chaudhary-nikhil/E22_Senior_Design/hardware/GoldenForm_1.kicad_pcb

## KiCad design hardware/GoldenForm_1.kicad_pcb (2026-03-06)

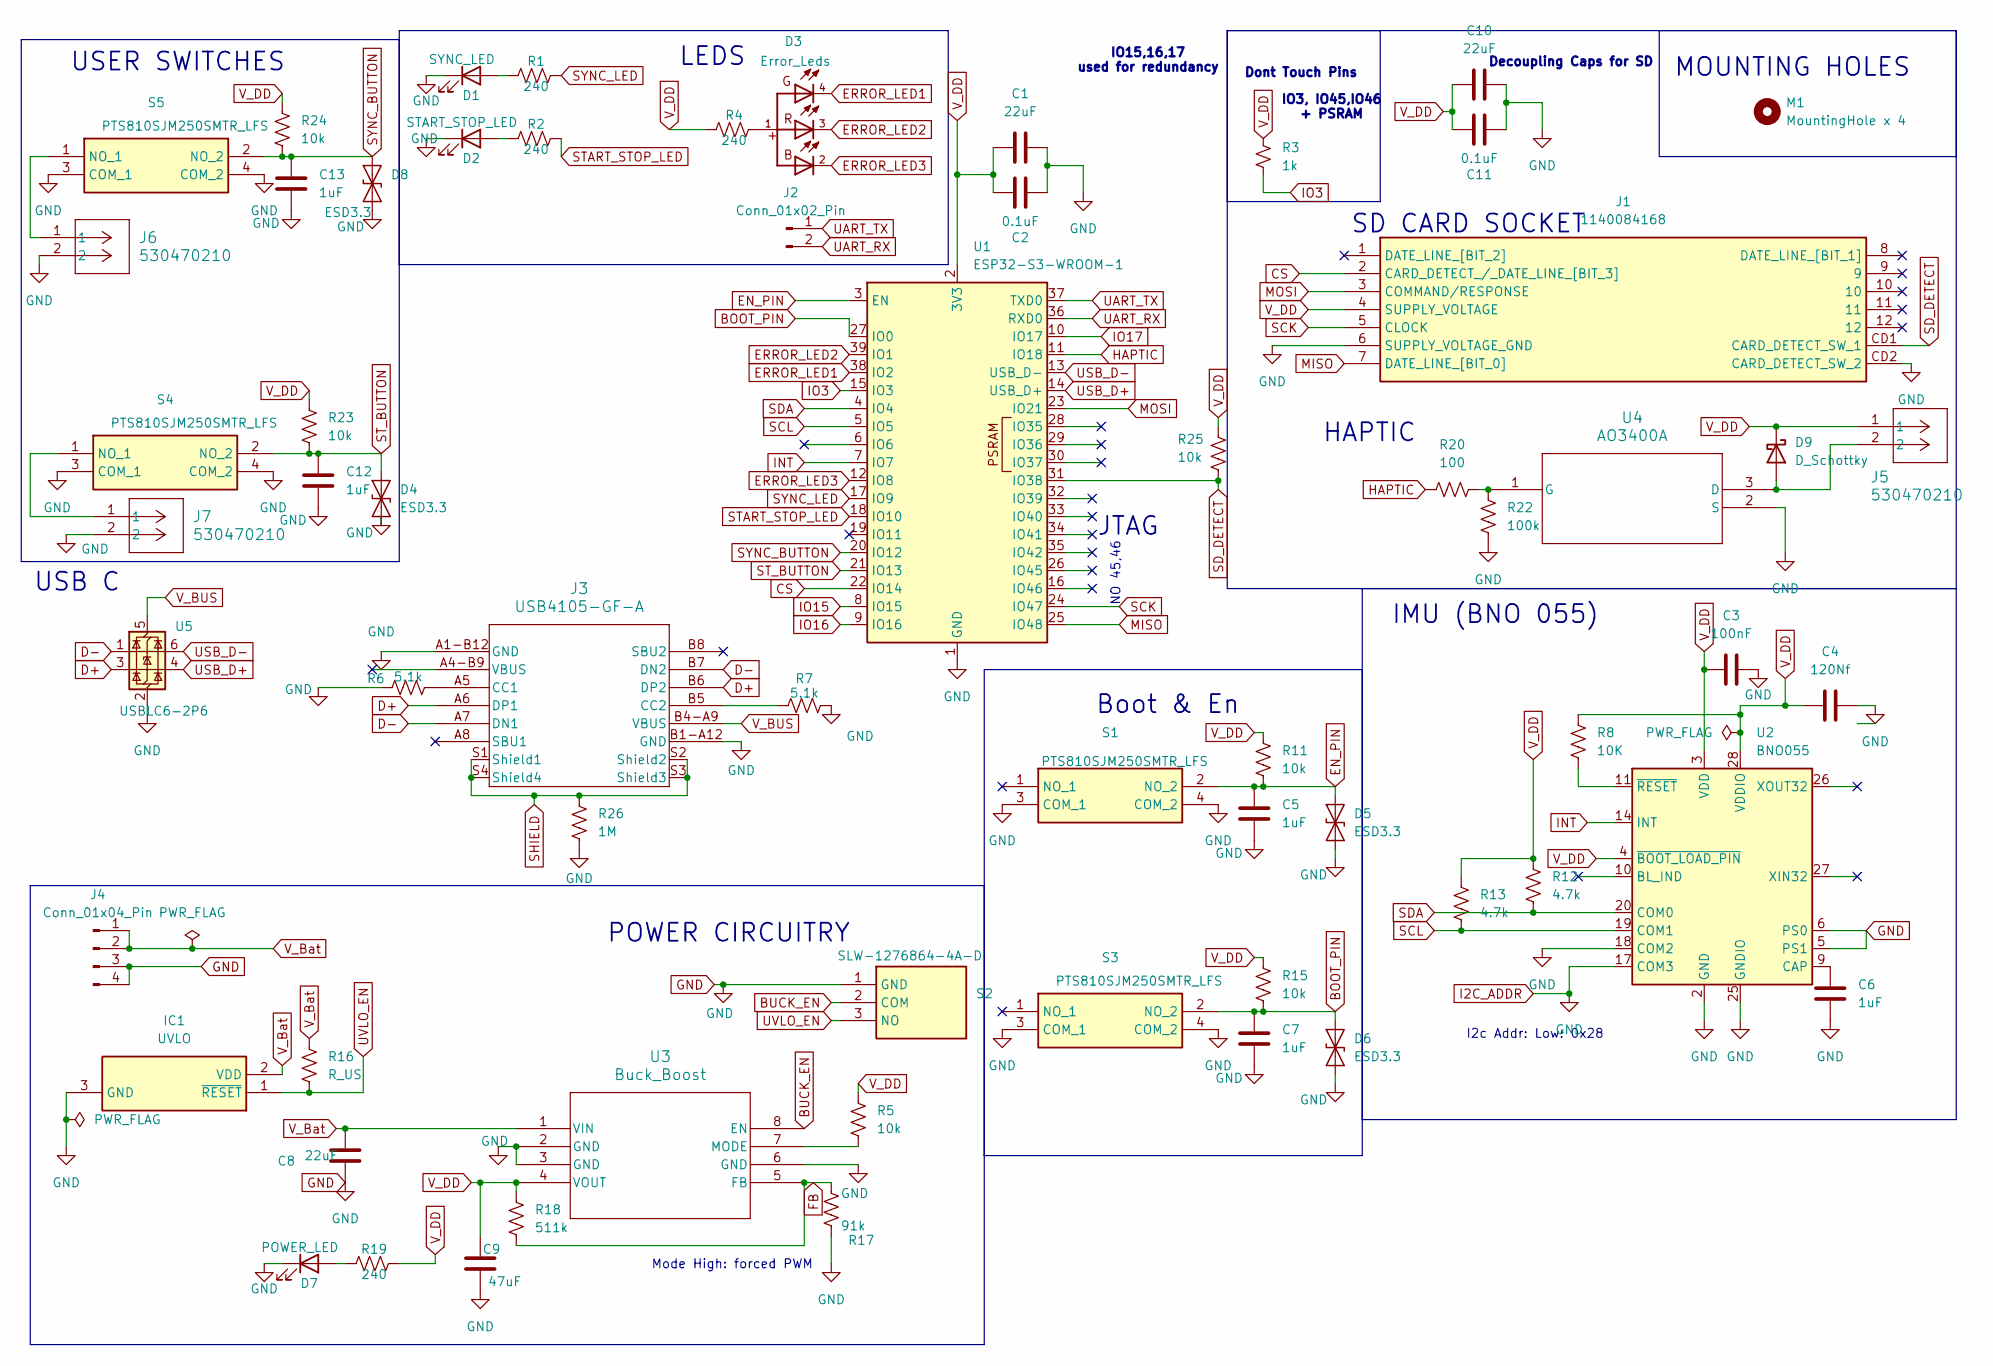
[picture p1: schematic GoldenForm_1.kicad_sch, GoldenFormPCB_1]

Parts:
C1, C10: 22uF; C_0805_2012Metric_Pad1.18x1.45mm_HandSolder
C2, C11: 0.1uF; C_0805_2012Metric_Pad1.18x1.45mm_HandSolder
C3: 100nF; C_0805_2012Metric_Pad1.18x1.45mm_HandSolder
C4: 120Nf; C_0805_2012Metric_Pad1.18x1.45mm_HandSolder
C5, C6, C7, C12, C13: 1uF; C_0805_2012Metric_Pad1.18x1.45mm_HandSolder
C8: 22uF; C_0603_1608Metric_Pad1.08x0.95mm_HandSolder
C9: 47uF; C_0603_1608Metric_Pad1.08x0.95mm_HandSolder
D1: SYNC_LED; LED_0805_2012Metric_Pad1.15x1.40mm_HandSolder
D2: START_STOP_LED; LED_0805_2012Metric_Pad1.15x1.40mm_HandSolder
D3: Error_Leds; WL-SFTW_3528_PLCC4; DigiKey_Part_Number 732-4998-1-ND
D4, D5, D6, D8: ESD3.3; D_0805_2012Metric_Pad1.15x1.40mm_HandSolder
D7: POWER_LED; LED_0805_2012Metric_Pad1.15x1.40mm_HandSolder
D9: D_Schottky; D_SOD-323_HandSoldering
IC1: UVLO; SOT95P237X112-3N; Mouser Part Number 595-TLV803EB33VDBZR
J1: 1140084168; Mouser Part Number 523-114-00841-68
J2: Conn_01x02_Pin; PinHeader_1x02_P2.54mm_Vertical
J3: USB4105-GF-A; USB4105_GCT
J4: Conn_01x04_Pin; PinHeader_1x04_P2.54mm_Vertical
J5, J6, J7: 530470210; CONN02_530470210_MOL
M1: MountingHole x 4; MountingHole_3.2mm_M3
R1, R2, R4, R19: 240; R_0805_2012Metric_Pad1.20x1.40mm_HandSolder
R3: 1k; R_0805_2012Metric_Pad1.20x1.40mm_HandSolder
R5, R11, R15, R23, R24, R25: 10k; R_0805_2012Metric_Pad1.20x1.40mm_HandSolder
R6, R7: 5.1k; R_0805_2012Metric_Pad1.20x1.40mm_HandSolder
R8: 10K; R_0805_2012Metric_Pad1.20x1.40mm_HandSolder
R12, R13: 4.7k; R_0805_2012Metric_Pad1.20x1.40mm_HandSolder
R16: R_US; R_0805_2012Metric_Pad1.20x1.40mm_HandSolder
R17: 91k; R_0805_2012Metric_Pad1.20x1.40mm_HandSolder
R18: 511k; R_0805_2012Metric_Pad1.20x1.40mm_HandSolder
R20: 100; R_0805_2012Metric_Pad1.20x1.40mm_HandSolder
R22: 100k; R_0805_2012Metric_Pad1.20x1.40mm_HandSolder
R26: 1M; R_0805_2012Metric_Pad1.20x1.40mm_HandSolder
S1, S3, S4, S5: PTS810SJM250SMTR_LFS; PTS810SJM250SMTRLFS; Mouser Part Number 611-PTS810SJM250SMTR
S2: SLW-1276864-4A-D; SLW12768644AD; Mouser Part Number 179-SLW-1276864-4A-D
U1: ESP32-S3-WROOM-1
U2: BNO055; LGA-28_5.2x3.8mm_P0.5mm
U3: Buck_Boost; MICROSIP8_SIU_TEX
U4: AO3400A; SOT-23-3L_AOS
U5: USBLC6-2P6; SOT-666

Connections:
BOOT_PIN: C7.1, D6.2 (A2), R15.2, S3.2 (NO_2), U1.27 (IO0)
BUCK_EN: S2.2 (COM), U3.8 (EN)
CS: J1.2 (CARD_DETECT_/_DATE_LINE_[BIT_3]), U1.22 (IO14)
D+: J3.A6 (DP1), J3.B6 (DP2), U5.3 (I/O2)
D-: J3.A7 (DN1), J3.B7 (DN2), U5.1 (I/O1)
EN_PIN: C5.1, D5.2 (A2), R11.2, S1.2 (NO_2), U1.3 (EN)
ERROR_LED1: D3.4, U1.38 (IO2)
ERROR_LED2: D3.3, U1.39 (IO1)
ERROR_LED3: D3.2, U1.12 (IO8)
FB: R17.1, R18.2, U3.5 (FB)
GND: C1.2, C2.2, C3.2, C4.1, C5.2, C6.2, C7.2, C8.2, C9.2, C10.2, C11.2, C12.2, C13.2, D1.1 (K), D2.1 (K), D4.1 (A1), D5.1 (A1), D6.1 (A1), D7.1 (K), D8.1 (A1), IC1.3 (GND), J1.6 (SUPPLY_VOLTAGE_GND), J1.CD2 (CARD_DETECT_SW_2), J3.A1-B12 (GND), J3.B1-A12 (GND), J4.3, J4.4, J6.2, J7.2, R6.1, R7.2, R17.2, R22.1, R26.2, S1.3 (COM_1), S1.4 (COM_2), S2.1 (GND), S3.3 (COM_1), S3.4 (COM_2), S4.3 (COM_1), S4.4 (COM_2), S5.3 (COM_1), S5.4 (COM_2), U1.1 (GND), U1.40 (GND), U1.41 (GND), U2.2 (GND), U2.5 (PS1), U2.6 (PS0), U2.17 (COM3), U2.18 (COM2), U2.25 (GNDIO), U3.2 (GND), U3.3 (GND), U3.6 (GND), U4.2 (S), U5.2 (GND)
HAPTIC: R20.1, U1.11 (IO18)
INT: U1.7 (IO7), U2.14 (INT)
IO3: R3.2, U1.15 (IO3)
IO15: U1.8 (IO15)
IO16: U1.9 (IO16)
IO17: U1.10 (IO17)
MISO: J1.7 (DATE_LINE_[BIT_0]), U1.25 (IO48)
MOSI: J1.3 (COMMAND/RESPONSE), U1.23 (IO21)
unnamed: D1.2 (A), R1.1
unnamed: D2.2 (A), R2.1
unnamed: D3.1, R4.2
unnamed: D7.2 (A), R19.1
unnamed: D9.2 (A), J5.2, U4.3 (D)
unnamed: J3.A5 (CC1), R6.2
unnamed: J3.B5 (CC2), R7.1
unnamed: J7.1, S4.1 (NO_1)
unnamed: J6.1, S5.1 (NO_1)
unnamed: C6.1, U2.9 (CAP)
unnamed: R8.2, U2.11 (~RESET)
unnamed: R5.2, U3.7 (MODE)
unnamed: R20.2, R22.2, U4.1 (G)
SCK: J1.5 (CLOCK), U1.24 (IO47)
SCL: R13.2, U1.5 (IO5), U2.19 (COM1)
SDA: R12.2, U1.4 (IO4), U2.20 (COM0)
SD_DETECT: J1.CD1 (CARD_DETECT_SW_1), R25.2, U1.31 (IO38)
SHIELD: J3.S1 (Shield1), J3.S2 (Shield2), J3.S3 (Shield3), J3.S4 (Shield4), R26.1
START_STOP_LED: R2.2, U1.18 (IO10)
ST_BUTTON: C12.1, D4.2 (A2), R23.2, S4.2 (NO_2), U1.21 (IO13)
SYNC_BUTTON: C13.1, D8.2 (A2), R24.2, S5.2 (NO_2), U1.20 (IO12)
SYNC_LED: R1.2, U1.17 (IO9)
UART_RX: J2.2, U1.36 (RXD0)
UART_TX: J2.1, U1.37 (TXD0)
USB_D+: U1.14 (USB_D+), U5.4 (I/O2)
USB_D-: U1.13 (USB_D-), U5.6 (I/O1)
UVLO_EN: IC1.1 (~RESET), R16.2, S2.3 (NO)
V_BUS: J3.B4-A9 (VBUS), U5.5 (VBUS)
V_Bat: C8.1, IC1.2 (VDD), J4.1, J4.2, R16.1, U3.1 (VIN)
V_DD: C1.1, C2.1, C3.1, C4.2, C9.1, C10.1, C11.1, D9.1 (K), J1.4 (SUPPLY_VOLTAGE), J5.1, R3.1, R4.1, R5.1, R8.1, R11.1, R12.1, R13.1, R15.1, R18.1, R19.2, R23.1, R24.1, R25.1, U1.2 (3V3), U2.3 (VDD), U2.4 (~BOOT_LOAD_PIN), U2.28 (VDDIO), U3.4 (VOUT)

Notes on the sheet:
LEDS
SD CARD SOCKET
POWER CIRCUITRY
Mode High: forced PWM
NO 45,46
USB C
IMU (BNO 055)
USER SWITCHES
Decoupling Caps for SD
Dont Touch Pins
HAPTIC
JTAG
IO3, IO45,IO46 + PSRAM
Boot & En
I2c Addr: Low: 0x28
MOUNTING HOLES
IO15,16,17 used for redundancy

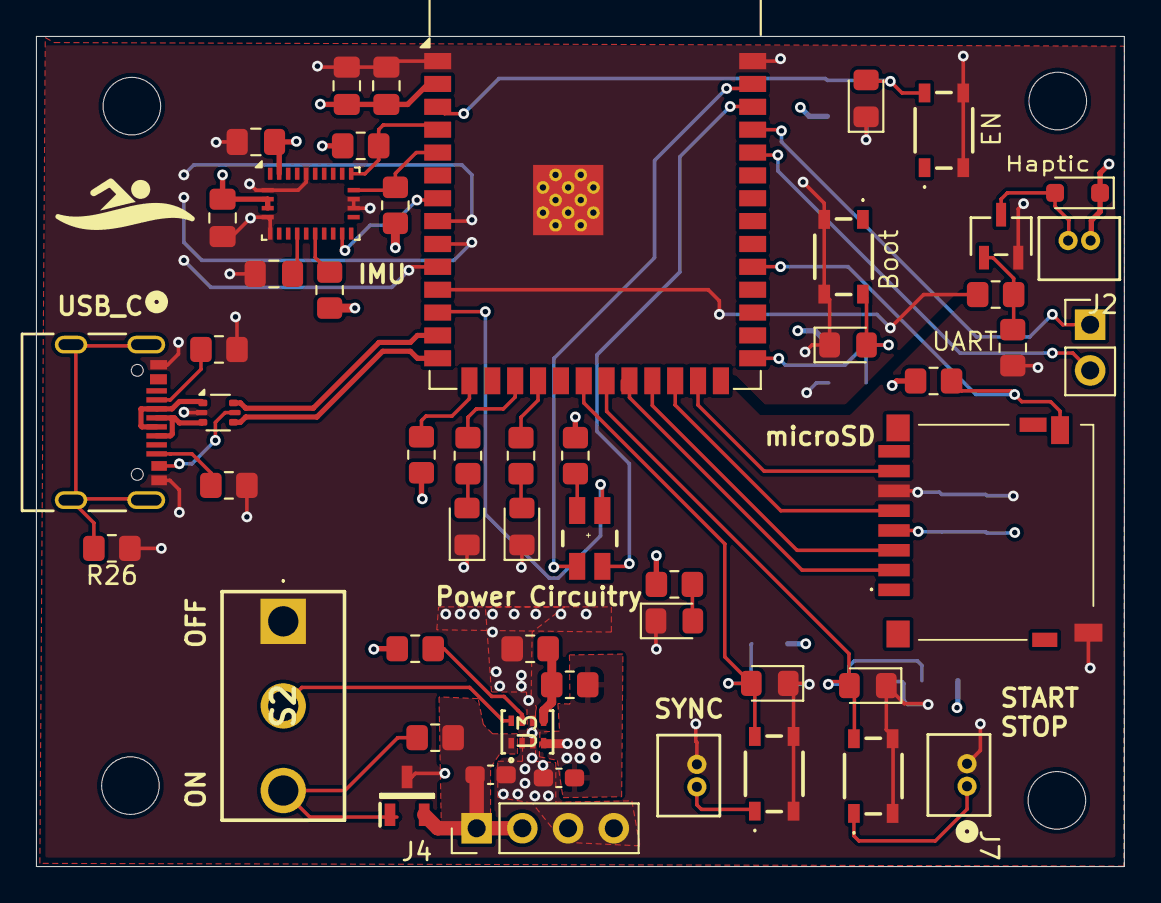
[picture p2: board GoldenForm_1.kicad_pcb from above]

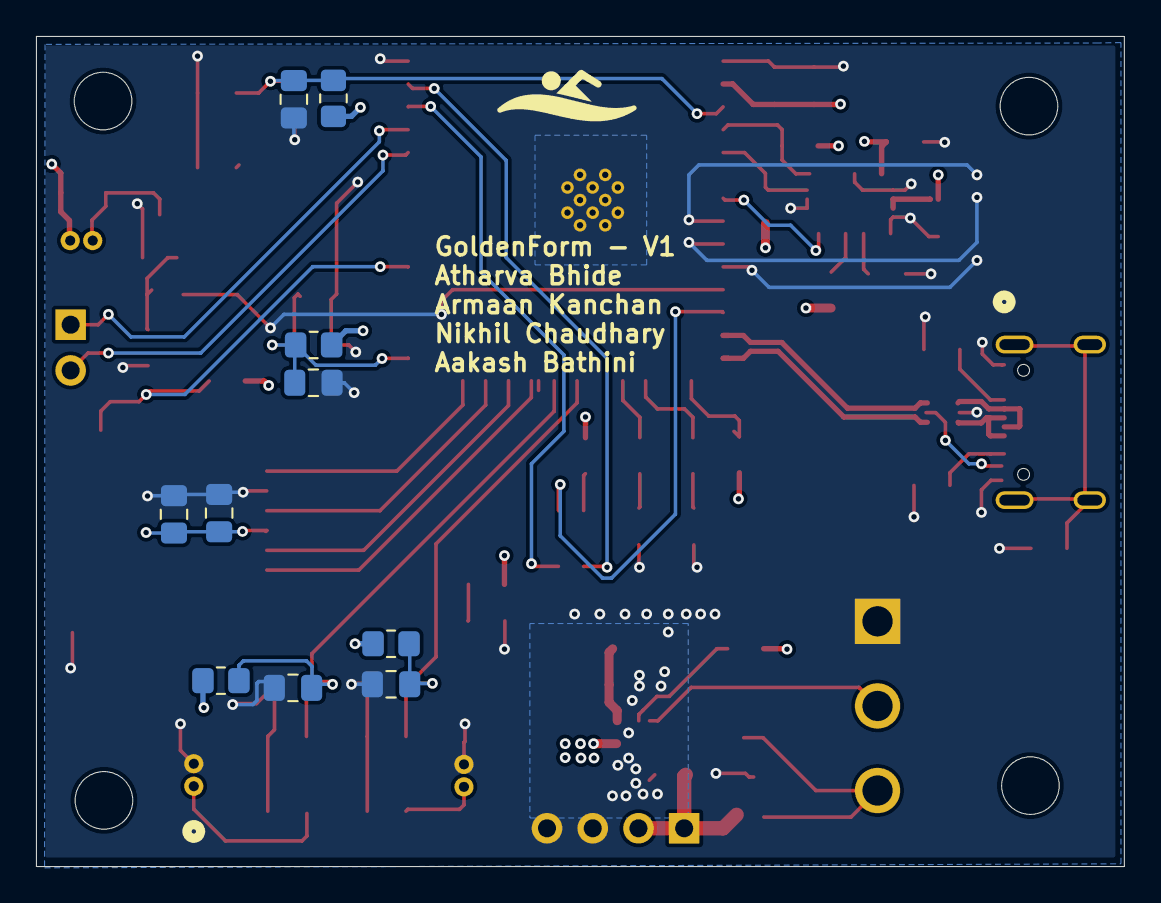
[picture p3: board GoldenForm_1.kicad_pcb from below]

Board: 4 copper layers, 60.4 x 46.1 mm, 62 parts (10 on the bottom side), 46 nets.
