chaudhary-nikhil/E22_Senior_Design/main/dummy_imu.c

#include "dummy_imu.h"

#include <stddef.h>

/*
 * Derived from goldenform_Session_1_-_Apr_21_10_44_AM_raw.json.
 * 504 samples, ~50 Hz, span 9913 ms, 4 strokes.
 *
 * Unlike the previous downsampled table this keeps the native ~20 ms
 * cadence so that downstream LIA integration and stroke detection see
 * the same sample rate they would on real hardware. Feeding widely
 * spaced samples caused the position trails to look erratic because
 * every LIA spike integrated over ~260 ms of dt instead of ~20 ms.
 */
static const bno055_sample_t s_demo_samples[] = {
    { .t_ms=16067, .ax=1.61f, .ay=-0.21f, .az=9.86f, .gx=-0.247f, .gy=0.232f, .gz=-0.146f, .mx=0.0f, .my=0.0f, .mz=0.0f, .roll=0.0f, .pitch=0.0f, .yaw=0.0f, .qw=0.9819f, .qx=-0.0167f, .qy=-0.1154f, .qz=-0.1487f, .lia_x=0.15f, .lia_y=-0.34f, .lia_z=0.3f, .temp=0.0f, .sys_cal=0, .gyro_cal=3, .accel_cal=3, .mag_cal=3, .haptic_fired=0, .deviation_score=0.0f, .haptic_reason=0, .pull_duration_ms=0.0f, .device_id=1, .device_role=0, .stroke_count=0, .breath_count=0, .entry_angle=0.0f },
    { .t_ms=16086, .ax=2.43f, .ay=-0.34f, .az=9.84f, .gx=-0.173f, .gy=0.216f, .gz=-0.079f, .mx=0.0f, .my=0.0f, .mz=0.0f, .roll=0.0f, .pitch=0.0f, .yaw=0.0f, .qw=0.9821f, .qx=-0.0175f, .qy=-0.1143f, .qz=-0.1492f, .lia_x=0.22f, .lia_y=-0.09f, .lia_z=0.28f, .temp=0.0f, .sys_cal=0, .gyro_cal=3, .accel_cal=3, .mag_cal=3, .haptic_fired=0, .deviation_score=0.0f, .haptic_reason=0, .pull_duration_ms=0.0f, .device_id=1, .device_role=0, .stroke_count=0, .breath_count=0, .entry_angle=0.0f },
    { .t_ms=16103, .ax=2.45f, .ay=-0.09f, .az=9.83f, .gx=0.001f, .gy=0.213f, .gz=-0.069f, .mx=0.0f, .my=0.0f, .mz=0.0f, .roll=0.0f, .pitch=0.0f, .yaw=0.0f, .qw=0.9822f, .qx=-0.017f, .qy=-0.1122f, .qz=-0.1497f, .lia_x=-0.36f, .lia_y=0.03f, .lia_z=1.15f, .temp=0.0f, .sys_cal=0, .gyro_cal=3, .accel_cal=3, .mag_cal=3, .haptic_fired=0, .deviation_score=0.0f, .haptic_reason=0, .pull_duration_ms=0.0f, .device_id=1, .device_role=0, .stroke_count=0, .breath_count=0, .entry_angle=0.0f },
    { .t_ms=16124, .ax=1.82f, .ay=0.02f, .az=10.71f, .gx=-0.159f, .gy=0.269f, .gz=-0.017f, .mx=0.0f, .my=0.0f, .mz=0.0f, .roll=0.0f, .pitch=0.0f, .yaw=0.0f, .qw=0.9824f, .qx=-0.0197f, .qy=-0.1093f, .qz=-0.1503f, .lia_x=-0.37f, .lia_y=0.0f, .lia_z=1.13f, .temp=0.0f, .sys_cal=0, .gyro_cal=3, .accel_cal=3, .mag_cal=3, .haptic_fired=0, .deviation_score=0.0f, .haptic_reason=0, .pull_duration_ms=0.0f, .device_id=1, .device_role=0, .stroke_count=0, .breath_count=0, .entry_angle=0.0f },
    { .t_ms=16151, .ax=2.33f, .ay=-0.49f, .az=9.85f, .gx=-0.863f, .gy=0.022f, .gz=-0.038f, .mx=0.0f, .my=0.0f, .mz=0.0f, .roll=0.0f, .pitch=0.0f, .yaw=0.0f, .qw=0.9821f, .qx=-0.0311f, .qy=-0.1071f, .qz=-0.1521f, .lia_x=0.26f, .lia_y=-0.46f, .lia_z=0.03f, .temp=0.0f, .sys_cal=0, .gyro_cal=3, .accel_cal=3, .mag_cal=3, .haptic_fired=0, .deviation_score=0.0f, .haptic_reason=0, .pull_duration_ms=0.0f, .device_id=1, .device_role=0, .stroke_count=0, .breath_count=0, .entry_angle=0.0f },
    { .t_ms=16172, .ax=2.46f, .ay=-0.86f, .az=9.49f, .gx=-0.694f, .gy=-0.12f, .gz=-0.02f, .mx=0.0f, .my=0.0f, .mz=0.0f, .roll=0.0f, .pitch=0.0f, .yaw=0.0f, .qw=0.9818f, .qx=-0.0372f, .qy=-0.1072f, .qz=-0.1527f, .lia_x=0.4f, .lia_y=-0.42f, .lia_z=0.44f, .temp=0.0f, .sys_cal=0, .gyro_cal=3, .accel_cal=3, .mag_cal=3, .haptic_fired=0, .deviation_score=0.0f, .haptic_reason=0, .pull_duration_ms=0.0f, .device_id=1, .device_role=0, .stroke_count=0, .breath_count=0, .entry_angle=0.0f },
    { .t_ms=16189, .ax=2.58f, .ay=-0.79f, .az=10.11f, .gx=-0.435f, .gy=0.032f, .gz=0.038f, .mx=0.0f, .my=0.0f, .mz=0.0f, .roll=0.0f, .pitch=0.0f, .yaw=0.0f, .qw=0.9817f, .qx=-0.0406f, .qy=-0.1054f, .qz=-0.1529f, .lia_x=0.42f, .lia_y=-0.3f, .lia_z=0.18f, .temp=0.0f, .sys_cal=0, .gyro_cal=3, .accel_cal=3, .mag_cal=3, .haptic_fired=0, .deviation_score=0.0f, .haptic_reason=0, .pull_duration_ms=0.0f, .device_id=1, .device_role=0, .stroke_count=0, .breath_count=0, .entry_angle=0.0f },
    { .t_ms=16207, .ax=2.58f, .ay=-0.76f, .az=9.38f, .gx=-0.127f, .gy=0.372f, .gz=-0.035f, .mx=0.0f, .my=0.0f, .mz=0.0f, .roll=0.0f, .pitch=0.0f, .yaw=0.0f, .qw=0.9821f, .qx=-0.0399f, .qy=-0.1017f, .qz=-0.1536f, .lia_x=0.43f, .lia_y=-0.74f, .lia_z=-0.16f, .temp=0.0f, .sys_cal=0, .gyro_cal=3, .accel_cal=3, .mag_cal=3, .haptic_fired=0, .deviation_score=0.0f, .haptic_reason=0, .pull_duration_ms=0.0f, .device_id=1, .device_role=0, .stroke_count=0, .breath_count=0, .entry_angle=0.0f },
    { .t_ms=16227, .ax=2.51f, .ay=-1.2f, .az=9.4f, .gx=0.392f, .gy=0.429f, .gz=-0.088f, .mx=0.0f, .my=0.0f, .mz=0.0f, .roll=0.0f, .pitch=0.0f, .yaw=0.0f, .qw=0.9823f, .qx=-0.0377f, .qy=-0.1f, .qz=-0.1541f, .lia_x=0.31f, .lia_y=-0.61f, .lia_z=-0.13f, .temp=0.0f, .sys_cal=0, .gyro_cal=3, .accel_cal=3, .mag_cal=3, .haptic_fired=0, .deviation_score=0.0f, .haptic_reason=0, .pull_duration_ms=0.0f, .device_id=1, .device_role=0, .stroke_count=0, .breath_count=0, .entry_angle=0.0f },
    { .t_ms=16245, .ax=2.31f, .ay=-0.98f, .az=9.45f, .gx=0.574f, .gy=0.452f, .gz=-0.057f, .mx=0.0f, .my=0.0f, .mz=0.0f, .roll=0.0f, .pitch=0.0f, .yaw=0.0f, .qw=0.9828f, .qx=-0.0311f, .qy=-0.0963f, .qz=-0.1542f, .lia_x=0.12f, .lia_y=-0.44f, .lia_z=-0.57f, .temp=0.0f, .sys_cal=0, .gyro_cal=3, .accel_cal=3, .mag_cal=3, .haptic_fired=0, .deviation_score=0.0f, .haptic_reason=0, .pull_duration_ms=0.0f, .device_id=1, .device_role=0, .stroke_count=0, .breath_count=0, .entry_angle=0.0f },
    { .t_ms=16264, .ax=2.02f, .ay=-0.68f, .az=9.04f, .gx=0.66f, .gy=0.586f, .gz=-0.057f, .mx=0.0f, .my=0.0f, .mz=0.0f, .roll=0.0f, .pitch=0.0f, .yaw=0.0f, .qw=0.9835f, .qx=-0.0241f, .qy=-0.0918f, .qz=-0.1542f, .lia_x=-0.1f, .lia_y=-0.09f, .lia_z=-0.92f, .temp=0.0f, .sys_cal=0, .gyro_cal=3, .accel_cal=3, .mag_cal=3, .haptic_fired=0, .deviation_score=0.0f, .haptic_reason=0, .pull_duration_ms=0.0f, .device_id=1, .device_role=0, .stroke_count=0, .breath_count=0, .entry_angle=0.0f },
    { .t_ms=16284, .ax=1.69f, .ay=-0.22f, .az=8.71f, .gx=0.545f, .gy=0.502f, .gz=-0.046f, .mx=0.0f, .my=0.0f, .mz=0.0f, .roll=0.0f, .pitch=0.0f, .yaw=0.0f, .qw=0.9839f, .qx=-0.0186f, .qy=-0.0878f, .qz=-0.1542f, .lia_x=-0.26f, .lia_y=0.16f, .lia_z=-0.84f, .temp=0.0f, .sys_cal=0, .gyro_cal=3, .accel_cal=3, .mag_cal=3, .haptic_fired=0, .deviation_score=0.0f, .haptic_reason=0, .pull_duration_ms=0.0f, .device_id=1, .device_role=0, .stroke_count=0, .breath_count=0, .entry_angle=0.0f },
    { .t_ms=16301, .ax=1.32f, .ay=0.2f, .az=8.96f, .gx=0.338f, .gy=0.571f, .gz=0.021f, .mx=0.0f, .my=0.0f, .mz=0.0f, .roll=0.0f, .pitch=0.0f, .yaw=0.0f, .qw=0.9846f, .qx=-0.0146f, .qy=-0.0819f, .qz=-0.1537f, .lia_x=-0.41f, .lia_y=0.05f, .lia_z=-1.16f, .temp=0.0f, .sys_cal=0, .gyro_cal=3, .accel_cal=3, .mag_cal=3, .haptic_fired=0, .deviation_score=0.0f, .haptic_reason=0, .pull_duration_ms=0.0f, .device_id=1, .device_role=0, .stroke_count=0, .breath_count=0, .entry_angle=0.0f },
    { .t_ms=16322, .ax=0.78f, .ay=-0.09f, .az=8.51f, .gx=0.351f, .gy=0.973f, .gz=0.101f, .mx=0.0f, .my=0.0f, .mz=0.0f, .roll=0.0f, .pitch=0.0f, .yaw=0.0f, .qw=0.9856f, .qx=-0.0096f, .qy=-0.0726f, .qz=-0.1523f, .lia_x=-1.03f, .lia_y=-0.13f, .lia_z=-0.82f, .temp=0.0f, .sys_cal=0, .gyro_cal=3, .accel_cal=3, .mag_cal=3, .haptic_fired=0, .deviation_score=0.0f, .haptic_reason=0, .pull_duration_ms=0.0f, .device_id=1, .device_role=0, .stroke_count=0, .breath_count=0, .entry_angle=0.0f },
    { .t_ms=16339, .ax=0.39f, .ay=-0.22f, .az=9.16f, .gx=0.321f, .gy=1.142f, .gz=0.176f, .mx=0.0f, .my=0.0f, .mz=0.0f, .roll=0.0f, .pitch=0.0f, .yaw=0.0f, .qw=0.9866f, .qx=-0.0058f, .qy=-0.0624f, .qz=-0.1507f, .lia_x=-1.3f, .lia_y=-0.58f, .lia_z=-0.77f, .temp=0.0f, .sys_cal=0, .gyro_cal=3, .accel_cal=3, .mag_cal=3, .haptic_fired=0, .deviation_score=0.0f, .haptic_reason=0, .pull_duration_ms=0.0f, .device_id=1, .device_role=0, .stroke_count=0, .breath_count=0, .entry_angle=0.0f },
    { .t_ms=16359, .ax=-0.08f, .ay=-0.66f, .az=8.68f, .gx=0.037f, .gy=0.867f, .gz=0.12f, .mx=0.0f, .my=0.0f, .mz=0.0f, .roll=0.0f, .pitch=0.0f, .yaw=0.0f, .qw=0.9872f, .qx=-0.0044f, .qy=-0.0552f, .qz=-0.1496f, .lia_x=-1.57f, .lia_y=-0.85f, .lia_z=-0.92f, .temp=0.0f, .sys_cal=0, .gyro_cal=3, .accel_cal=3, .mag_cal=3, .haptic_fired=0, .deviation_score=0.0f, .haptic_reason=0, .pull_duration_ms=0.0f, .device_id=1, .device_role=0, .stroke_count=0, .breath_count=0, .entry_angle=0.0f },
    { .t_ms=16379, .ax=-0.49f, .ay=-0.85f, .az=8.75f, .gx=0.117f, .gy=0.501f, .gz=0.111f, .mx=0.0f, .my=0.0f, .mz=0.0f, .roll=0.0f, .pitch=0.0f, .yaw=0.0f, .qw=0.9874f, .qx=-0.0021f, .qy=-0.0511f, .qz=-0.1482f, .lia_x=-2.13f, .lia_y=-0.94f, .lia_z=-1.46f, .temp=0.0f, .sys_cal=0, .gyro_cal=3, .accel_cal=3, .mag_cal=3, .haptic_fired=0, .deviation_score=0.0f, .haptic_reason=0, .pull_duration_ms=0.0f, .device_id=1, .device_role=0, .stroke_count=0, .breath_count=0, .entry_angle=0.0f },
    { .t_ms=16396, .ax=-1.14f, .ay=-0.83f, .az=8.28f, .gx=0.232f, .gy=0.397f, .gz=0.28f, .mx=0.0f, .my=0.0f, .mz=0.0f, .roll=0.0f, .pitch=0.0f, .yaw=0.0f, .qw=0.9879f, .qx=-0.0004f, .qy=-0.0493f, .qz=-0.1445f, .lia_x=-2.73f, .lia_y=-0.27f, .lia_z=-1.05f, .temp=0.0f, .sys_cal=0, .gyro_cal=3, .accel_cal=3, .mag_cal=3, .haptic_fired=0, .deviation_score=0.0f, .haptic_reason=0, .pull_duration_ms=0.0f, .device_id=1, .device_role=0, .stroke_count=0, .breath_count=0, .entry_angle=0.0f },
    { .t_ms=16415, .ax=-1.78f, .ay=-0.1f, .az=8.7f, .gx=0.358f, .gy=0.232f, .gz=0.604f, .mx=0.0f, .my=0.0f, .mz=0.0f, .roll=0.0f, .pitch=0.0f, .yaw=0.0f, .qw=0.9888f, .qx=0.0027f, .qy=-0.0483f, .qz=-0.1416f, .lia_x=-3.2f, .lia_y=0.0f, .lia_z=-1.75f, .temp=0.0f, .sys_cal=0, .gyro_cal=3, .accel_cal=3, .mag_cal=3, .haptic_fired=0, .deviation_score=0.0f, .haptic_reason=0, .pull_duration_ms=0.0f, .device_id=1, .device_role=0, .stroke_count=0, .breath_count=0, .entry_angle=0.0f },
    { .t_ms=16434, .ax=-2.29f, .ay=0.2f, .az=8.01f, .gx=0.211f, .gy=0.283f, .gz=0.718f, .mx=0.0f, .my=0.0f, .mz=0.0f, .roll=0.0f, .pitch=0.0f, .yaw=0.0f, .qw=0.9899f, .qx=0.0051f, .qy=-0.0459f, .qz=-0.1343f, .lia_x=-3.5f, .lia_y=-0.07f, .lia_z=-1.09f, .temp=0.0f, .sys_cal=0, .gyro_cal=3, .accel_cal=3, .mag_cal=3, .haptic_fired=0, .deviation_score=0.0f, .haptic_reason=0, .pull_duration_ms=0.0f, .device_id=1, .device_role=0, .stroke_count=0, .breath_count=0, .entry_angle=0.0f },
    { .t_ms=16452, .ax=-2.76f, .ay=-0.15f, .az=8.66f, .gx=0.377f, .gy=0.275f, .gz=0.753f, .mx=0.0f, .my=0.0f, .mz=0.0f, .roll=0.0f, .pitch=0.0f, .yaw=0.0f, .qw=0.9908f, .qx=0.0095f, .qy=-0.0439f, .qz=-0.1271f, .lia_x=-3.71f, .lia_y=-1.03f, .lia_z=-1.0f, .temp=0.0f, .sys_cal=0, .gyro_cal=3, .accel_cal=3, .mag_cal=3, .haptic_fired=0, .deviation_score=0.0f, .haptic_reason=0, .pull_duration_ms=0.0f, .device_id=1, .device_role=0, .stroke_count=0, .breath_count=0, .entry_angle=0.0f },
    { .t_ms=16473, .ax=-2.88f, .ay=-0.67f, .az=8.75f, .gx=0.72f, .gy=0.205f, .gz=0.672f, .mx=0.0f, .my=0.0f, .mz=0.0f, .roll=0.0f, .pitch=0.0f, .yaw=0.0f, .qw=0.9916f, .qx=0.0171f, .qy=-0.0435f, .qz=-0.1201f, .lia_x=-3.54f, .lia_y=-1.25f, .lia_z=-1.18f, .temp=0.0f, .sys_cal=0, .gyro_cal=3, .accel_cal=3, .mag_cal=3, .haptic_fired=0, .deviation_score=0.0f, .haptic_reason=0, .pull_duration_ms=0.0f, .device_id=1, .device_role=0, .stroke_count=0, .breath_count=0, .entry_angle=0.0f },
    { .t_ms=16491, .ax=-2.8f, .ay=-0.71f, .az=8.25f, .gx=1.032f, .gy=-0.011f, .gz=0.869f, .mx=0.0f, .my=0.0f, .mz=0.0f, .roll=0.0f, .pitch=0.0f, .yaw=0.0f, .qw=0.9925f, .qx=0.0267f, .qy=-0.0457f, .qz=-0.1104f, .lia_x=-3.72f, .lia_y=-1.09f, .lia_z=-1.62f, .temp=0.0f, .sys_cal=0, .gyro_cal=3, .accel_cal=3, .mag_cal=3, .haptic_fired=0, .deviation_score=0.0f, .haptic_reason=0, .pull_duration_ms=0.0f, .device_id=1, .device_role=0, .stroke_count=0, .breath_count=0, .entry_angle=0.0f },
    { .t_ms=16510, .ax=-2.95f, .ay=0.42f, .az=8.47f, .gx=0.981f, .gy=-0.225f, .gz=1.226f, .mx=0.0f, .my=0.0f, .mz=0.0f, .roll=0.0f, .pitch=0.0f, .yaw=0.0f, .qw=0.9934f, .qx=0.0342f, .qy=-0.049f, .qz=-0.0978f, .lia_x=-3.88f, .lia_y=0.45f, .lia_z=-0.69f, .temp=0.0f, .sys_cal=0, .gyro_cal=3, .accel_cal=3, .mag_cal=3, .haptic_fired=0, .deviation_score=0.0f, .haptic_reason=0, .pull_duration_ms=0.0f, .device_id=1, .device_role=0, .stroke_count=0, .breath_count=0, .entry_angle=0.0f },
    { .t_ms=16529, .ax=-2.99f, .ay=0.78f, .az=10.33f, .gx=0.427f, .gy=-0.111f, .gz=1.307f, .mx=0.0f, .my=0.0f, .mz=0.0f, .roll=0.0f, .pitch=0.0f, .yaw=0.0f, .qw=0.9939f, .qx=0.0359f, .qy=-0.0497f, .qz=-0.0856f, .lia_x=-4.4f, .lia_y=-0.68f, .lia_z=1.8f, .temp=0.0f, .sys_cal=0, .gyro_cal=3, .accel_cal=3, .mag_cal=3, .haptic_fired=0, .deviation_score=0.0f, .haptic_reason=0, .pull_duration_ms=0.0f, .device_id=1, .device_role=0, .stroke_count=0, .breath_count=0, .entry_angle=0.0f },
    { .t_ms=16551, .ax=-3.39f, .ay=0.2f, .az=10.78f, .gx=-0.507f, .gy=0.393f, .gz=1.081f, .mx=0.0f, .my=0.0f, .mz=0.0f, .roll=0.0f, .pitch=0.0f, .yaw=0.0f, .qw=0.9957f, .qx=0.0297f, .qy=-0.0453f, .qz=-0.0757f, .lia_x=-4.02f, .lia_y=-0.97f, .lia_z=0.2f, .temp=0.0f, .sys_cal=0, .gyro_cal=3, .accel_cal=3, .mag_cal=3, .haptic_fired=0, .deviation_score=0.0f, .haptic_reason=0, .pull_duration_ms=0.0f, .device_id=1, .device_role=0, .stroke_count=0, .breath_count=0, .entry_angle=0.0f },
    { .t_ms=16573, .ax=-3.4f, .ay=-0.62f, .az=9.96f, .gx=-0.513f, .gy=0.374f, .gz=1.021f, .mx=0.0f, .my=0.0f, .mz=0.0f, .roll=0.0f, .pitch=0.0f, .yaw=0.0f, .qw=0.9966f, .qx=0.0261f, .qy=-0.0424f, .qz=-0.0657f, .lia_x=-4.49f, .lia_y=-1.3f, .lia_z=0.23f, .temp=0.0f, .sys_cal=0, .gyro_cal=3, .accel_cal=3, .mag_cal=3, .haptic_fired=0, .deviation_score=0.0f, .haptic_reason=0, .pull_duration_ms=0.0f, .device_id=1, .device_role=0, .stroke_count=0, .breath_count=0, .entry_angle=0.0f },
    { .t_ms=16590, .ax=-3.69f, .ay=-0.82f, .az=10.37f, .gx=0.199f, .gy=0.128f, .gz=1.142f, .mx=0.0f, .my=0.0f, .mz=0.0f, .roll=0.0f, .pitch=0.0f, .yaw=0.0f, .qw=0.9969f, .qx=0.0297f, .qy=-0.0416f, .qz=-0.0541f, .lia_x=-3.01f, .lia_y=-1.3f, .lia_z=-0.1f, .temp=0.0f, .sys_cal=0, .gyro_cal=3, .accel_cal=3, .mag_cal=3, .haptic_fired=0, .deviation_score=0.0f, .haptic_reason=0, .pull_duration_ms=0.0f, .device_id=1, .device_role=0, .stroke_count=0, .breath_count=0, .entry_angle=0.0f },
    { .t_ms=16608, .ax=-2.23f, .ay=-0.68f, .az=9.91f, .gx=1.096f, .gy=0.297f, .gz=1.364f, .mx=0.0f, .my=0.0f, .mz=0.0f, .roll=0.0f, .pitch=0.0f, .yaw=0.0f, .qw=0.9976f, .qx=0.0411f, .qy=-0.0389f, .qz=-0.0397f, .lia_x=-2.07f, .lia_y=-0.05f, .lia_z=0.79f, .temp=0.0f, .sys_cal=0, .gyro_cal=3, .accel_cal=3, .mag_cal=3, .haptic_fired=0, .deviation_score=0.0f, .haptic_reason=0, .pull_duration_ms=0.0f, .device_id=1, .device_role=0, .stroke_count=0, .breath_count=0, .entry_angle=0.0f },
    { .t_ms=16628, .ax=-1.34f, .ay=0.78f, .az=10.53f, .gx=1.3f, .gy=0.567f, .gz=1.548f, .mx=0.0f, .my=0.0f, .mz=0.0f, .roll=0.0f, .pitch=0.0f, .yaw=0.0f, .qw=0.9977f, .qx=0.0472f, .qy=-0.0367f, .qz=-0.0237f, .lia_x=-1.48f, .lia_y=-0.83f, .lia_z=1.35f, .temp=0.0f, .sys_cal=0, .gyro_cal=3, .accel_cal=3, .mag_cal=3, .haptic_fired=0, .deviation_score=0.0f, .haptic_reason=0, .pull_duration_ms=0.0f, .device_id=1, .device_role=0, .stroke_count=0, .breath_count=0, .entry_angle=0.0f },
    { .t_ms=16646, .ax=-0.84f, .ay=0.19f, .az=11.09f, .gx=0.962f, .gy=0.656f, .gz=1.582f, .mx=0.0f, .my=0.0f, .mz=0.0f, .roll=0.0f, .pitch=0.0f, .yaw=0.0f, .qw=0.9979f, .qx=0.0541f, .qy=-0.0314f, .qz=-0.0089f, .lia_x=-0.81f, .lia_y=-0.47f, .lia_z=0.68f, .temp=0.0f, .sys_cal=0, .gyro_cal=3, .accel_cal=3, .mag_cal=3, .haptic_fired=0, .deviation_score=0.0f, .haptic_reason=0, .pull_duration_ms=0.0f, .device_id=1, .device_role=0, .stroke_count=0, .breath_count=0, .entry_angle=0.0f },
    { .t_ms=16665, .ax=-0.26f, .ay=0.61f, .az=10.41f, .gx=0.291f, .gy=0.59f, .gz=1.197f, .mx=0.0f, .my=0.0f, .mz=0.0f, .roll=0.0f, .pitch=0.0f, .yaw=0.0f, .qw=0.998f, .qx=0.0564f, .qy=-0.027f, .qz=-0.0029f, .lia_x=-0.08f, .lia_y=-0.58f, .lia_z=0.88f, .temp=0.0f, .sys_cal=0, .gyro_cal=3, .accel_cal=3, .mag_cal=3, .haptic_fired=0, .deviation_score=0.0f, .haptic_reason=0, .pull_duration_ms=0.0f, .device_id=1, .device_role=0, .stroke_count=0, .breath_count=0, .entry_angle=0.0f },
    { .t_ms=16684, .ax=0.4f, .ay=0.54f, .az=10.61f, .gx=0.308f, .gy=0.473f, .gz=0.999f, .mx=0.0f, .my=0.0f, .mz=0.0f, .roll=0.0f, .pitch=0.0f, .yaw=0.0f, .qw=0.9979f, .qx=0.0596f, .qy=-0.0221f, .qz=0.0067f, .lia_x=0.66f, .lia_y=-0.39f, .lia_z=1.61f, .temp=0.0f, .sys_cal=0, .gyro_cal=3, .accel_cal=3, .mag_cal=3, .haptic_fired=0, .deviation_score=0.0f, .haptic_reason=0, .pull_duration_ms=0.0f, .device_id=1, .device_role=0, .stroke_count=0, .breath_count=0, .entry_angle=0.0f },
    { .t_ms=16702, .ax=1.34f, .ay=0.48f, .az=12.06f, .gx=0.419f, .gy=0.892f, .gz=0.872f, .mx=0.0f, .my=0.0f, .mz=0.0f, .roll=0.0f, .pitch=0.0f, .yaw=0.0f, .qw=0.9979f, .qx=0.0626f, .qy=-0.0129f, .qz=0.0156f, .lia_x=1.51f, .lia_y=-1.46f, .lia_z=2.78f, .temp=0.0f, .sys_cal=0, .gyro_cal=3, .accel_cal=3, .mag_cal=3, .haptic_fired=0, .deviation_score=0.0f, .haptic_reason=0, .pull_duration_ms=0.0f, .device_id=1, .device_role=0, .stroke_count=0, .breath_count=0, .entry_angle=0.0f },
    { .t_ms=16723, .ax=1.54f, .ay=-0.51f, .az=12.51f, .gx=0.012f, .gy=1.227f, .gz=0.832f, .mx=0.0f, .my=0.0f, .mz=0.0f, .roll=0.0f, .pitch=0.0f, .yaw=0.0f, .qw=0.9978f, .qx=0.0612f, .qy=-0.0018f, .qz=0.024f, .lia_x=1.89f, .lia_y=-2.22f, .lia_z=3.16f, .temp=0.0f, .sys_cal=0, .gyro_cal=3, .accel_cal=3, .mag_cal=3, .haptic_fired=0, .deviation_score=0.0f, .haptic_reason=0, .pull_duration_ms=0.0f, .device_id=1, .device_role=0, .stroke_count=0, .breath_count=0, .entry_angle=0.0f },
    { .t_ms=16740, .ax=1.95f, .ay=-0.82f, .az=12.81f, .gx=-0.497f, .gy=1.024f, .gz=0.687f, .mx=0.0f, .my=0.0f, .mz=0.0f, .roll=0.0f, .pitch=0.0f, .yaw=0.0f, .qw=0.998f, .qx=0.0552f, .qy=0.0065f, .qz=0.0305f, .lia_x=2.04f, .lia_y=-1.71f, .lia_z=2.89f, .temp=0.0f, .sys_cal=0, .gyro_cal=3, .accel_cal=3, .mag_cal=3, .haptic_fired=0, .deviation_score=0.0f, .haptic_reason=0, .pull_duration_ms=0.0f, .device_id=1, .device_role=0, .stroke_count=0, .breath_count=0, .entry_angle=0.0f },
    { .t_ms=16759, .ax=1.95f, .ay=-0.22f, .az=12.61f, .gx=-0.785f, .gy=0.551f, .gz=0.336f, .mx=0.0f, .my=0.0f, .mz=0.0f, .roll=0.0f, .pitch=0.0f, .yaw=0.0f, .qw=0.9983f, .qx=0.0477f, .qy=0.0109f, .qz=0.0329f, .lia_x=2.01f, .lia_y=-1.13f, .lia_z=2.81f, .temp=0.0f, .sys_cal=0, .gyro_cal=3, .accel_cal=3, .mag_cal=3, .haptic_fired=0, .deviation_score=0.0f, .haptic_reason=0, .pull_duration_ms=0.0f, .device_id=1, .device_role=0, .stroke_count=0, .breath_count=0, .entry_angle=0.0f },
    { .t_ms=16779, .ax=1.82f, .ay=-0.19f, .az=12.57f, .gx=-0.657f, .gy=0.423f, .gz=-0.109f, .mx=0.0f, .my=0.0f, .mz=0.0f, .roll=0.0f, .pitch=0.0f, .yaw=0.0f, .qw=0.9984f, .qx=0.0444f, .qy=0.0129f, .qz=0.0314f, .lia_x=1.83f, .lia_y=-0.93f, .lia_z=3.06f, .temp=0.0f, .sys_cal=0, .gyro_cal=3, .accel_cal=3, .mag_cal=3, .haptic_fired=0, .deviation_score=0.0f, .haptic_reason=0, .pull_duration_ms=0.0f, .device_id=1, .device_role=0, .stroke_count=0, .breath_count=0, .entry_angle=0.0f },
    { .t_ms=16796, .ax=1.56f, .ay=-0.1f, .az=12.82f, .gx=-0.506f, .gy=0.47f, .gz=-0.441f, .mx=0.0f, .my=0.0f, .mz=0.0f, .roll=0.0f, .pitch=0.0f, .yaw=0.0f, .qw=0.9986f, .qx=0.0404f, .qy=0.0177f, .qz=0.0266f, .lia_x=2.16f, .lia_y=-0.94f, .lia_z=2.57f, .temp=0.0f, .sys_cal=0, .gyro_cal=3, .accel_cal=3, .mag_cal=3, .haptic_fired=0, .deviation_score=0.0f, .haptic_reason=0, .pull_duration_ms=0.0f, .device_id=1, .device_role=0, .stroke_count=0, .breath_count=0, .entry_angle=0.0f },
    { .t_ms=16815, .ax=1.78f, .ay=-0.13f, .az=12.34f, .gx=0.096f, .gy=0.5f, .gz=-0.75f, .mx=0.0f, .my=0.0f, .mz=0.0f, .roll=0.0f, .pitch=0.0f, .yaw=0.0f, .qw=0.9985f, .qx=0.0435f, .qy=0.0226f, .qz=0.023f, .lia_x=2.06f, .lia_y=-1.15f, .lia_z=3.12f, .temp=0.0f, .sys_cal=0, .gyro_cal=3, .accel_cal=3, .mag_cal=3, .haptic_fired=0, .deviation_score=0.0f, .haptic_reason=0, .pull_duration_ms=0.0f, .device_id=1, .device_role=0, .stroke_count=0, .breath_count=0, .entry_angle=0.0f },
    { .t_ms=16834, .ax=1.59f, .ay=-0.19f, .az=12.87f, .gx=1.038f, .gy=0.453f, .gz=-0.913f, .mx=0.0f, .my=0.0f, .mz=0.0f, .roll=0.0f, .pitch=0.0f, .yaw=0.0f, .qw=0.998f, .qx=0.0543f, .qy=0.0275f, .qz=0.014f, .lia_x=1.77f, .lia_y=-0.6f, .lia_z=3.14f, .temp=0.0f, .sys_cal=0, .gyro_cal=3, .accel_cal=3, .mag_cal=3, .haptic_fired=0, .deviation_score=0.0f, .haptic_reason=0, .pull_duration_ms=0.0f, .device_id=1, .device_role=0, .stroke_count=0, .breath_count=0, .entry_angle=0.0f },
    { .t_ms=16852, .ax=1.2f, .ay=0.96f, .az=13.06f, .gx=1.198f, .gy=0.257f, .gz=-0.839f, .mx=0.0f, .my=0.0f, .mz=0.0f, .roll=0.0f, .pitch=0.0f, .yaw=0.0f, .qw=0.9975f, .qx=0.0643f, .qy=0.0296f, .qz=0.0061f, .lia_x=1.8f, .lia_y=-0.04f, .lia_z=3.61f, .temp=0.0f, .sys_cal=0, .gyro_cal=3, .accel_cal=3, .mag_cal=3, .haptic_fired=0, .deviation_score=0.0f, .haptic_reason=0, .pull_duration_ms=0.0f, .device_id=1, .device_role=0, .stroke_count=0, .breath_count=0, .entry_angle=0.0f },
    { .t_ms=16873, .ax=1.19f, .ay=0.8f, .az=13.32f, .gx=0.527f, .gy=-0.056f, .gz=-0.674f, .mx=0.0f, .my=0.0f, .mz=0.0f, .roll=0.0f, .pitch=0.0f, .yaw=0.0f, .qw=0.9973f, .qx=0.0673f, .qy=0.029f, .qz=-0.0001f, .lia_x=2.08f, .lia_y=-0.93f, .lia_z=3.3f, .temp=0.0f, .sys_cal=0, .gyro_cal=3, .accel_cal=3, .mag_cal=3, .haptic_fired=0, .deviation_score=0.0f, .haptic_reason=0, .pull_duration_ms=0.0f, .device_id=1, .device_role=0, .stroke_count=0, .breath_count=0, .entry_angle=0.0f },
    { .t_ms=16890, .ax=1.78f, .ay=0.21f, .az=12.63f, .gx=-0.164f, .gy=-0.268f, .gz=-0.448f, .mx=0.0f, .my=0.0f, .mz=0.0f, .roll=0.0f, .pitch=0.0f, .yaw=0.0f, .qw=0.9976f, .qx=0.065f, .qy=0.0261f, .qz=-0.0043f, .lia_x=2.44f, .lia_y=-1.08f, .lia_z=2.48f, .temp=0.0f, .sys_cal=0, .gyro_cal=3, .accel_cal=3, .mag_cal=3, .haptic_fired=0, .deviation_score=0.0f, .haptic_reason=0, .pull_duration_ms=0.0f, .device_id=1, .device_role=0, .stroke_count=0, .breath_count=0, .entry_angle=0.0f },
    { .t_ms=16909, .ax=1.92f, .ay=0.2f, .az=11.44f, .gx=-0.205f, .gy=-0.422f, .gz=-0.435f, .mx=0.0f, .my=0.0f, .mz=0.0f, .roll=0.0f, .pitch=0.0f, .yaw=0.0f, .qw=0.9977f, .qx=0.064f, .qy=0.0227f, .qz=-0.0092f, .lia_x=2.47f, .lia_y=-0.68f, .lia_z=1.66f, .temp=0.0f, .sys_cal=0, .gyro_cal=3, .accel_cal=3, .mag_cal=3, .haptic_fired=0, .deviation_score=0.0f, .haptic_reason=0, .pull_duration_ms=0.0f, .device_id=1, .device_role=0, .stroke_count=0, .breath_count=0, .entry_angle=0.0f },
    { .t_ms=16929, .ax=2.01f, .ay=0.56f, .az=11.77f, .gx=0.279f, .gy=-0.179f, .gz=-0.682f, .mx=0.0f, .my=0.0f, .mz=0.0f, .roll=0.0f, .pitch=0.0f, .yaw=0.0f, .qw=0.9976f, .qx=0.0652f, .qy=0.022f, .qz=-0.0168f, .lia_x=2.32f, .lia_y=0.34f, .lia_z=2.48f, .temp=0.0f, .sys_cal=0, .gyro_cal=3, .accel_cal=3, .mag_cal=3, .haptic_fired=0, .deviation_score=0.0f, .haptic_reason=0, .pull_duration_ms=0.0f, .device_id=1, .device_role=0, .stroke_count=0, .breath_count=0, .entry_angle=0.0f },
    { .t_ms=16946, .ax=1.86f, .ay=1.65f, .az=12.19f, .gx=0.397f, .gy=0.056f, .gz=-1.048f, .mx=0.0f, .my=0.0f, .mz=0.0f, .roll=0.0f, .pitch=0.0f, .yaw=0.0f, .qw=0.9971f, .qx=0.0687f, .qy=0.024f, .qz=-0.0274f, .lia_x=2.18f, .lia_y=1.1f, .lia_z=2.12f, .temp=0.0f, .sys_cal=0, .gyro_cal=3, .accel_cal=3, .mag_cal=3, .haptic_fired=0, .deviation_score=0.0f, .haptic_reason=0, .pull_duration_ms=0.0f, .device_id=1, .device_role=0, .stroke_count=0, .breath_count=0, .entry_angle=0.0f },
    { .t_ms=16965, .ax=1.64f, .ay=2.45f, .az=11.81f, .gx=0.262f, .gy=0.206f, .gz=-1.189f, .mx=0.0f, .my=0.0f, .mz=0.0f, .roll=0.0f, .pitch=0.0f, .yaw=0.0f, .qw=0.9966f, .qx=0.0704f, .qy=0.0258f, .qz=-0.0331f, .lia_x=2.24f, .lia_y=1.28f, .lia_z=0.94f, .temp=0.0f, .sys_cal=0, .gyro_cal=3, .accel_cal=3, .mag_cal=3, .haptic_fired=0, .deviation_score=0.0f, .haptic_reason=0, .pull_duration_ms=0.0f, .device_id=1, .device_role=0, .stroke_count=0, .breath_count=0, .entry_angle=0.0f },
    { .t_ms=16984, .ax=1.7f, .ay=2.64f, .az=10.64f, .gx=0.089f, .gy=-0.293f, .gz=-1.115f, .mx=0.0f, .my=0.0f, .mz=0.0f, .roll=0.0f, .pitch=0.0f, .yaw=0.0f, .qw=0.9963f, .qx=0.0713f, .qy=0.0222f, .qz=-0.0435f, .lia_x=2.2f, .lia_y=1.1f, .lia_z=0.72f, .temp=0.0f, .sys_cal=0, .gyro_cal=3, .accel_cal=3, .mag_cal=3, .haptic_fired=0, .deviation_score=0.0f, .haptic_reason=0, .pull_duration_ms=0.0f, .device_id=1, .device_role=0, .stroke_count=0, .breath_count=0, .entry_angle=0.0f },
    { .t_ms=17002, .ax=1.79f, .ay=2.24f, .az=10.3f, .gx=0.329f, .gy=-0.788f, .gz=-0.772f, .mx=0.0f, .my=0.0f, .mz=0.0f, .roll=0.0f, .pitch=0.0f, .yaw=0.0f, .qw=0.9958f, .qx=0.0745f, .qy=0.0146f, .qz=-0.0505f, .lia_x=2.09f, .lia_y=0.69f, .lia_z=0.66f, .temp=0.0f, .sys_cal=0, .gyro_cal=3, .accel_cal=3, .mag_cal=3, .haptic_fired=0, .deviation_score=0.0f, .haptic_reason=0, .pull_duration_ms=0.0f, .device_id=1, .device_role=0, .stroke_count=0, .breath_count=0, .entry_angle=0.0f },
    { .t_ms=17023, .ax=2.24f, .ay=2.23f, .az=10.93f, .gx=0.453f, .gy=-0.743f, .gz=-0.336f, .mx=0.0f, .my=0.0f, .mz=0.0f, .roll=0.0f, .pitch=0.0f, .yaw=0.0f, .qw=0.9955f, .qx=0.0776f, .qy=0.0085f, .qz=-0.0534f, .lia_x=2.62f, .lia_y=0.83f, .lia_z=1.34f, .temp=0.0f, .sys_cal=0, .gyro_cal=3, .accel_cal=3, .mag_cal=3, .haptic_fired=0, .deviation_score=0.0f, .haptic_reason=0, .pull_duration_ms=0.0f, .device_id=1, .device_role=0, .stroke_count=0, .breath_count=0, .entry_angle=0.0f },
    { .t_ms=17040, .ax=2.37f, .ay=2.34f, .az=10.88f, .gx=-0.106f, .gy=-0.285f, .gz=-0.068f, .mx=0.0f, .my=0.0f, .mz=0.0f, .roll=0.0f, .pitch=0.0f, .yaw=0.0f, .qw=0.9957f, .qx=0.0747f, .qy=0.0068f, .qz=-0.054f, .lia_x=3.14f, .lia_y=0.58f, .lia_z=0.83f, .temp=0.0f, .sys_cal=0, .gyro_cal=3, .accel_cal=3, .mag_cal=3, .haptic_fired=0, .deviation_score=0.0f, .haptic_reason=0, .pull_duration_ms=0.0f, .device_id=1, .device_role=0, .stroke_count=0, .breath_count=0, .entry_angle=0.0f },
    { .t_ms=17059, .ax=2.93f, .ay=2.04f, .az=10.23f, .gx=-0.741f, .gy=-0.046f, .gz=-0.033f, .mx=0.0f, .my=0.0f, .mz=0.0f, .roll=0.0f, .pitch=0.0f, .yaw=0.0f, .qw=0.9962f, .qx=0.0672f, .qy=0.0067f, .qz=-0.0545f, .lia_x=3.23f, .lia_y=0.57f, .lia_z=0.32f, .temp=0.0f, .sys_cal=0, .gyro_cal=3, .accel_cal=3, .mag_cal=3, .haptic_fired=0, .deviation_score=0.0f, .haptic_reason=0, .pull_duration_ms=0.0f, .device_id=1, .device_role=0, .stroke_count=0, .breath_count=0, .entry_angle=0.0f },
    { .t_ms=17087, .ax=2.96f, .ay=1.89f, .az=10.04f, .gx=-0.704f, .gy=-0.139f, .gz=-0.184f, .mx=0.0f, .my=0.0f, .mz=0.0f, .roll=0.0f, .pitch=0.0f, .yaw=0.0f, .qw=0.9965f, .qx=0.0612f, .qy=0.0053f, .qz=-0.0569f, .lia_x=2.0f, .lia_y=0.47f, .lia_z=1.19f, .temp=0.0f, .sys_cal=0, .gyro_cal=3, .accel_cal=3, .mag_cal=3, .haptic_fired=0, .deviation_score=0.0f, .haptic_reason=0, .pull_duration_ms=0.0f, .device_id=1, .device_role=0, .stroke_count=0, .breath_count=0, .entry_angle=0.0f },
    { .t_ms=17116, .ax=1.72f, .ay=1.44f, .az=11.38f, .gx=-0.439f, .gy=-0.572f, .gz=0.211f, .mx=0.0f, .my=0.0f, .mz=0.0f, .roll=0.0f, .pitch=0.0f, .yaw=0.0f, .qw=0.9969f, .qx=0.0538f, .qy=-0.0012f, .qz=-0.0543f, .lia_x=1.92f, .lia_y=-0.17f, .lia_z=1.74f, .temp=0.0f, .sys_cal=0, .gyro_cal=3, .accel_cal=3, .mag_cal=3, .haptic_fired=0, .deviation_score=0.0f, .haptic_reason=0, .pull_duration_ms=0.0f, .device_id=1, .device_role=0, .stroke_count=0, .breath_count=0, .entry_angle=0.0f },
    { .t_ms=17136, .ax=1.94f, .ay=0.81f, .az=11.49f, .gx=-0.754f, .gy=-0.634f, .gz=0.416f, .mx=0.0f, .my=0.0f, .mz=0.0f, .roll=0.0f, .pitch=0.0f, .yaw=0.0f, .qw=0.9976f, .qx=0.0458f, .qy=-0.0072f, .qz=-0.0519f, .lia_x=2.14f, .lia_y=-0.22f, .lia_z=1.7f, .temp=0.0f, .sys_cal=0, .gyro_cal=3, .accel_cal=3, .mag_cal=3, .haptic_fired=0, .deviation_score=0.0f, .haptic_reason=0, .pull_duration_ms=0.0f, .device_id=1, .device_role=0, .stroke_count=0, .breath_count=0, .entry_angle=0.0f },
    { .t_ms=17154, .ax=2.36f, .ay=0.72f, .az=11.47f, .gx=-0.837f, .gy=-0.664f, .gz=0.631f, .mx=0.0f, .my=0.0f, .mz=0.0f, .roll=0.0f, .pitch=0.0f, .yaw=0.0f, .qw=0.9981f, .qx=0.0375f, .qy=-0.0138f, .qz=-0.0461f, .lia_x=2.86f, .lia_y=0.01f, .lia_z=0.12f, .temp=0.0f, .sys_cal=0, .gyro_cal=3, .accel_cal=3, .mag_cal=3, .haptic_fired=0, .deviation_score=0.0f, .haptic_reason=0, .pull_duration_ms=0.0f, .device_id=1, .device_role=0, .stroke_count=0, .breath_count=0, .entry_angle=0.0f },
    { .t_ms=17175, .ax=3.18f, .ay=0.71f, .az=9.9f, .gx=-0.583f, .gy=-0.876f, .gz=0.595f, .mx=0.0f, .my=0.0f, .mz=0.0f, .roll=0.0f, .pitch=0.0f, .yaw=0.0f, .qw=0.9983f, .qx=0.0334f, .qy=-0.0303f, .qz=-0.0394f, .lia_x=2.06f, .lia_y=-0.13f, .lia_z=0.97f, .temp=0.0f, .sys_cal=0, .gyro_cal=3, .accel_cal=3, .mag_cal=3, .haptic_fired=0, .deviation_score=0.0f, .haptic_reason=0, .pull_duration_ms=0.0f, .device_id=1, .device_role=0, .stroke_count=0, .breath_count=0, .entry_angle=0.0f },
    { .t_ms=17196, .ax=2.63f, .ay=0.56f, .az=10.74f, .gx=0.314f, .gy=-1.462f, .gz=0.315f, .mx=0.0f, .my=0.0f, .mz=0.0f, .roll=0.0f, .pitch=0.0f, .yaw=0.0f, .qw=0.9979f, .qx=0.0412f, .qy=-0.0448f, .qz=-0.0371f, .lia_x=1.31f, .lia_y=0.62f, .lia_z=1.67f, .temp=0.0f, .sys_cal=0, .gyro_cal=3, .accel_cal=3, .mag_cal=3, .haptic_fired=0, .deviation_score=0.0f, .haptic_reason=0, .pull_duration_ms=0.0f, .device_id=1, .device_role=0, .stroke_count=0, .breath_count=0, .entry_angle=0.0f },
    { .t_ms=17218, .ax=2.15f, .ay=1.46f, .az=11.0f, .gx=1.13f, .gy=-1.409f, .gz=0.119f, .mx=0.0f, .my=0.0f, .mz=0.0f, .roll=0.0f, .pitch=0.0f, .yaw=0.0f, .qw=0.9969f, .qx=0.0464f, .qy=-0.0586f, .qz=-0.0359f, .lia_x=1.49f, .lia_y=0.61f, .lia_z=0.67f, .temp=0.0f, .sys_cal=0, .gyro_cal=3, .accel_cal=3, .mag_cal=3, .haptic_fired=0, .deviation_score=0.0f, .haptic_reason=0, .pull_duration_ms=0.0f, .device_id=1, .device_role=0, .stroke_count=0, .breath_count=0, .entry_angle=0.0f },
    { .t_ms=17237, .ax=2.6f, .ay=1.71f, .az=10.35f, .gx=1.654f, .gy=-1.332f, .gz=0.219f, .mx=0.0f, .my=0.0f, .mz=0.0f, .roll=0.0f, .pitch=0.0f, .yaw=0.0f, .qw=0.9952f, .qx=0.0646f, .qy=-0.0654f, .qz=-0.0345f, .lia_x=2.06f, .lia_y=1.2f, .lia_z=0.49f, .temp=0.0f, .sys_cal=0, .gyro_cal=3, .accel_cal=3, .mag_cal=3, .haptic_fired=0, .deviation_score=0.0f, .haptic_reason=0, .pull_duration_ms=0.0f, .device_id=1, .device_role=0, .stroke_count=0, .breath_count=0, .entry_angle=0.0f },
    { .t_ms=17255, .ax=3.43f, .ay=2.75f, .az=10.08f, .gx=2.616f, .gy=-1.405f, .gz=0.395f, .mx=0.0f, .my=0.0f, .mz=0.0f, .roll=0.0f, .pitch=0.0f, .yaw=0.0f, .qw=0.9924f, .qx=0.0884f, .qy=-0.0799f, .qz=-0.0242f, .lia_x=1.04f, .lia_y=0.75f, .lia_z=-0.53f, .temp=0.0f, .sys_cal=0, .gyro_cal=3, .accel_cal=3, .mag_cal=3, .haptic_fired=0, .deviation_score=0.0f, .haptic_reason=0, .pull_duration_ms=0.0f, .device_id=1, .device_role=0, .stroke_count=0, .breath_count=0, .entry_angle=0.0f },
    { .t_ms=17276, .ax=2.68f, .ay=2.66f, .az=8.94f, .gx=1.799f, .gy=-1.283f, .gz=0.923f, .mx=0.0f, .my=0.0f, .mz=0.0f, .roll=0.0f, .pitch=0.0f, .yaw=0.0f, .qw=0.9904f, .qx=0.0997f, .qy=-0.0945f, .qz=-0.0192f, .lia_x=2.28f, .lia_y=0.16f, .lia_z=0.78f, .temp=0.0f, .sys_cal=0, .gyro_cal=3, .accel_cal=3, .mag_cal=3, .haptic_fired=0, .deviation_score=0.0f, .haptic_reason=0, .pull_duration_ms=0.0f, .device_id=1, .device_role=0, .stroke_count=0, .breath_count=0, .entry_angle=0.0f },
    { .t_ms=17293, .ax=2.92f, .ay=2.23f, .az=8.92f, .gx=-0.47f, .gy=-1.623f, .gz=1.27f, .mx=0.0f, .my=0.0f, .mz=0.0f, .roll=0.0f, .pitch=0.0f, .yaw=0.0f, .qw=0.9899f, .qx=0.0882f, .qy=-0.1106f, .qz=-0.0093f, .lia_x=0.83f, .lia_y=0.15f, .lia_z=-0.47f, .temp=0.0f, .sys_cal=0, .gyro_cal=3, .accel_cal=3, .mag_cal=3, .haptic_fired=0, .deviation_score=0.0f, .haptic_reason=0, .pull_duration_ms=0.0f, .device_id=1, .device_role=0, .stroke_count=0, .breath_count=0, .entry_angle=0.0f },
    { .t_ms=17313, .ax=3.51f, .ay=1.35f, .az=9.19f, .gx=-2.508f, .gy=-1.274f, .gz=1.225f, .mx=0.0f, .my=0.0f, .mz=0.0f, .roll=0.0f, .pitch=0.0f, .yaw=0.0f, .qw=0.9907f, .qx=0.0595f, .qy=-0.1219f, .qz=-0.0023f, .lia_x=1.39f, .lia_y=-0.46f, .lia_z=-0.76f, .temp=0.0f, .sys_cal=0, .gyro_cal=3, .accel_cal=3, .mag_cal=3, .haptic_fired=0, .deviation_score=0.0f, .haptic_reason=0, .pull_duration_ms=0.0f, .device_id=1, .device_role=0, .stroke_count=0, .breath_count=0, .entry_angle=0.0f },
    { .t_ms=17332, .ax=4.68f, .ay=0.05f, .az=8.34f, .gx=-3.439f, .gy=-0.798f, .gz=0.794f, .mx=0.0f, .my=0.0f, .mz=0.0f, .roll=0.0f, .pitch=0.0f, .yaw=0.0f, .qw=0.9911f, .qx=0.0266f, .qy=-0.1299f, .qz=0.0001f, .lia_x=2.06f, .lia_y=-0.96f, .lia_z=-1.21f, .temp=0.0f, .sys_cal=0, .gyro_cal=3, .accel_cal=3, .mag_cal=3, .haptic_fired=0, .deviation_score=0.0f, .haptic_reason=0, .pull_duration_ms=0.0f, .device_id=1, .device_role=0, .stroke_count=0, .breath_count=0, .entry_angle=0.0f },
    { .t_ms=17350, .ax=4.58f, .ay=-1.54f, .az=7.65f, .gx=-2.705f, .gy=-0.922f, .gz=0.579f, .mx=0.0f, .my=0.0f, .mz=0.0f, .roll=0.0f, .pitch=0.0f, .yaw=0.0f, .qw=0.9902f, .qx=0.0037f, .qy=-0.1396f, .qz=0.0025f, .lia_x=1.46f, .lia_y=-1.68f, .lia_z=-1.55f, .temp=0.0f, .sys_cal=0, .gyro_cal=3, .accel_cal=3, .mag_cal=3, .haptic_fired=0, .deviation_score=0.0f, .haptic_reason=0, .pull_duration_ms=0.0f, .device_id=1, .device_role=0, .stroke_count=0, .breath_count=0, .entry_angle=0.0f },
    { .t_ms=17371, .ax=4.16f, .ay=-1.44f, .az=8.27f, .gx=-1.213f, .gy=-1.185f, .gz=0.623f, .mx=0.0f, .my=0.0f, .mz=0.0f, .roll=0.0f, .pitch=0.0f, .yaw=0.0f, .qw=0.9894f, .qx=-0.0068f, .qy=-0.1512f, .qz=0.0074f, .lia_x=1.26f, .lia_y=-0.37f, .lia_z=-0.87f, .temp=0.0f, .sys_cal=0, .gyro_cal=3, .accel_cal=3, .mag_cal=3, .haptic_fired=0, .deviation_score=0.0f, .haptic_reason=0, .pull_duration_ms=0.0f, .device_id=1, .device_role=0, .stroke_count=0, .breath_count=0, .entry_angle=0.0f },
    { .t_ms=17389, .ax=4.19f, .ay=-0.52f, .az=8.48f, .gx=-0.788f, .gy=-1.23f, .gz=0.734f, .mx=0.0f, .my=0.0f, .mz=0.0f, .roll=0.0f, .pitch=0.0f, .yaw=0.0f, .qw=0.9875f, .qx=-0.0106f, .qy=-0.1571f, .qz=0.0133f, .lia_x=1.67f, .lia_y=0.29f, .lia_z=-1.55f, .temp=0.0f, .sys_cal=0, .gyro_cal=3, .accel_cal=3, .mag_cal=3, .haptic_fired=0, .deviation_score=0.0f, .haptic_reason=0, .pull_duration_ms=0.0f, .device_id=1, .device_role=0, .stroke_count=0, .breath_count=0, .entry_angle=0.0f },
    { .t_ms=17406, .ax=4.82f, .ay=-0.02f, .az=7.72f, .gx=-0.759f, .gy=-1.125f, .gz=0.597f, .mx=0.0f, .my=0.0f, .mz=0.0f, .roll=0.0f, .pitch=0.0f, .yaw=0.0f, .qw=0.9855f, .qx=-0.0192f, .qy=-0.1737f, .qz=0.017f, .lia_x=1.24f, .lia_y=0.69f, .lia_z=-0.93f, .temp=0.0f, .sys_cal=0, .gyro_cal=3, .accel_cal=3, .mag_cal=3, .haptic_fired=0, .deviation_score=0.0f, .haptic_reason=0, .pull_duration_ms=0.0f, .device_id=1, .device_role=0, .stroke_count=0, .breath_count=0, .entry_angle=0.0f },
    { .t_ms=17428, .ax=4.58f, .ay=0.16f, .az=8.26f, .gx=-1.013f, .gy=-1.181f, .gz=0.387f, .mx=0.0f, .my=0.0f, .mz=0.0f, .roll=0.0f, .pitch=0.0f, .yaw=0.0f, .qw=0.983f, .qx=-0.0305f, .qy=-0.1798f, .qz=0.018f, .lia_x=1.17f, .lia_y=0.14f, .lia_z=-1.01f, .temp=0.0f, .sys_cal=0, .gyro_cal=3, .accel_cal=3, .mag_cal=3, .haptic_fired=0, .deviation_score=0.0f, .haptic_reason=0, .pull_duration_ms=0.0f, .device_id=1, .device_role=0, .stroke_count=0, .breath_count=0, .entry_angle=0.0f },
    { .t_ms=17445, .ax=4.65f, .ay=-0.64f, .az=8.08f, .gx=-1.493f, .gy=-1.335f, .gz=0.427f, .mx=0.0f, .my=0.0f, .mz=0.0f, .roll=0.0f, .pitch=0.0f, .yaw=0.0f, .qw=0.9799f, .qx=-0.0456f, .qy=-0.1929f, .qz=0.0204f, .lia_x=1.12f, .lia_y=-0.1f, .lia_z=-2.3f, .temp=0.0f, .sys_cal=0, .gyro_cal=3, .accel_cal=3, .mag_cal=3, .haptic_fired=0, .deviation_score=0.0f, .haptic_reason=0, .pull_duration_ms=0.0f, .device_id=1, .device_role=0, .stroke_count=0, .breath_count=0, .entry_angle=0.0f },
    { .t_ms=17465, .ax=5.0f, .ay=-1.2f, .az=6.66f, .gx=-1.302f, .gy=-1.448f, .gz=0.659f, .mx=0.0f, .my=0.0f, .mz=0.0f, .roll=0.0f, .pitch=0.0f, .yaw=0.0f, .qw=0.9764f, .qx=-0.0567f, .qy=-0.2067f, .qz=0.0257f, .lia_x=1.0f, .lia_y=-0.18f, .lia_z=-2.44f, .temp=0.0f, .sys_cal=0, .gyro_cal=3, .accel_cal=3, .mag_cal=3, .haptic_fired=0, .deviation_score=0.0f, .haptic_reason=0, .pull_duration_ms=0.0f, .device_id=1, .device_role=0, .stroke_count=0, .breath_count=0, .entry_angle=0.0f },
    { .t_ms=17484, .ax=4.85f, .ay=-1.29f, .az=6.65f, .gx=-0.327f, .gy=-1.516f, .gz=0.815f, .mx=0.0f, .my=0.0f, .mz=0.0f, .roll=0.0f, .pitch=0.0f, .yaw=0.0f, .qw=0.9731f, .qx=-0.0594f, .qy=-0.2201f, .qz=0.0341f, .lia_x=0.39f, .lia_y=-0.06f, .lia_z=-1.81f, .temp=0.0f, .sys_cal=0, .gyro_cal=3, .accel_cal=3, .mag_cal=3, .haptic_fired=0, .deviation_score=0.0f, .haptic_reason=0, .pull_duration_ms=0.0f, .device_id=1, .device_role=0, .stroke_count=0, .breath_count=0, .entry_angle=0.0f },
    { .t_ms=17501, .ax=4.74f, .ay=-1.7f, .az=6.99f, .gx=0.125f, .gy=-1.205f, .gz=0.865f, .mx=0.0f, .my=0.0f, .mz=0.0f, .roll=0.0f, .pitch=0.0f, .yaw=0.0f, .qw=0.9703f, .qx=-0.0604f, .qy=-0.23f, .qz=0.0433f, .lia_x=0.93f, .lia_y=-0.67f, .lia_z=-1.89f, .temp=0.0f, .sys_cal=0, .gyro_cal=3, .accel_cal=3, .mag_cal=3, .haptic_fired=0, .deviation_score=0.0f, .haptic_reason=0, .pull_duration_ms=0.0f, .device_id=1, .device_role=0, .stroke_count=0, .breath_count=0, .entry_angle=0.0f },
    { .t_ms=17522, .ax=5.63f, .ay=-1.86f, .az=6.66f, .gx=-0.265f, .gy=-0.855f, .gz=1.029f, .mx=0.0f, .my=0.0f, .mz=0.0f, .roll=0.0f, .pitch=0.0f, .yaw=0.0f, .qw=0.9678f, .qx=-0.0661f, .qy=-0.2372f, .qz=0.0526f, .lia_x=1.58f, .lia_y=-0.26f, .lia_z=-2.76f, .temp=0.0f, .sys_cal=0, .gyro_cal=3, .accel_cal=3, .mag_cal=3, .haptic_fired=0, .deviation_score=0.0f, .haptic_reason=0, .pull_duration_ms=0.0f, .device_id=1, .device_role=0, .stroke_count=0, .breath_count=0, .entry_angle=0.0f },
    { .t_ms=17539, .ax=6.01f, .ay=-1.76f, .az=5.85f, .gx=-0.656f, .gy=-0.785f, .gz=0.934f, .mx=0.0f, .my=0.0f, .mz=0.0f, .roll=0.0f, .pitch=0.0f, .yaw=0.0f, .qw=0.9664f, .qx=-0.07f, .qy=-0.2443f, .qz=0.0598f, .lia_x=1.62f, .lia_y=0.08f, .lia_z=-3.25f, .temp=0.0f, .sys_cal=0, .gyro_cal=3, .accel_cal=3, .mag_cal=3, .haptic_fired=0, .deviation_score=0.0f, .haptic_reason=0, .pull_duration_ms=0.0f, .device_id=1, .device_role=0, .stroke_count=0, .breath_count=0, .entry_angle=0.0f },
    { .t_ms=17557, .ax=6.16f, .ay=-1.58f, .az=5.27f, .gx=-0.526f, .gy=-0.786f, .gz=0.563f, .mx=0.0f, .my=0.0f, .mz=0.0f, .roll=0.0f, .pitch=0.0f, .yaw=0.0f, .qw=0.9639f, .qx=-0.0742f, .qy=-0.2512f, .qz=0.0646f, .lia_x=0.6f, .lia_y=-0.23f, .lia_z=-2.83f, .temp=0.0f, .sys_cal=0, .gyro_cal=3, .accel_cal=3, .mag_cal=3, .haptic_fired=0, .deviation_score=0.0f, .haptic_reason=0, .pull_duration_ms=0.0f, .device_id=1, .device_role=0, .stroke_count=0, .breath_count=0, .entry_angle=0.0f },
    { .t_ms=17578, .ax=5.25f, .ay=-1.95f, .az=5.62f, .gx=0.127f, .gy=-0.623f, .gz=0.355f, .mx=0.0f, .my=0.0f, .mz=0.0f, .roll=0.0f, .pitch=0.0f, .yaw=0.0f, .qw=0.9622f, .qx=-0.0727f, .qy=-0.2538f, .qz=0.067f, .lia_x=0.16f, .lia_y=-0.44f, .lia_z=-2.48f, .temp=0.0f, .sys_cal=0, .gyro_cal=3, .accel_cal=3, .mag_cal=3, .haptic_fired=0, .deviation_score=0.0f, .haptic_reason=0, .pull_duration_ms=0.0f, .device_id=1, .device_role=0, .stroke_count=0, .breath_count=0, .entry_angle=0.0f },
    { .t_ms=17595, .ax=4.88f, .ay=-2.13f, .az=5.94f, .gx=0.452f, .gy=-0.436f, .gz=0.427f, .mx=0.0f, .my=0.0f, .mz=0.0f, .roll=0.0f, .pitch=0.0f, .yaw=0.0f, .qw=0.9613f, .qx=-0.07f, .qy=-0.2563f, .qz=0.0728f, .lia_x=0.01f, .lia_y=-0.4f, .lia_z=-3.16f, .temp=0.0f, .sys_cal=0, .gyro_cal=3, .accel_cal=3, .mag_cal=3, .haptic_fired=0, .deviation_score=0.0f, .haptic_reason=0, .pull_duration_ms=0.0f, .device_id=1, .device_role=0, .stroke_count=0, .breath_count=0, .entry_angle=0.0f },
    { .t_ms=17615, .ax=5.04f, .ay=-2.1f, .az=5.25f, .gx=0.134f, .gy=-0.075f, .gz=0.733f, .mx=0.0f, .my=0.0f, .mz=0.0f, .roll=0.0f, .pitch=0.0f, .yaw=0.0f, .qw=0.9606f, .qx=-0.0714f, .qy=-0.2561f, .qz=0.0803f, .lia_x=0.49f, .lia_y=-0.25f, .lia_z=-3.47f, .temp=0.0f, .sys_cal=0, .gyro_cal=3, .accel_cal=3, .mag_cal=3, .haptic_fired=0, .deviation_score=0.0f, .haptic_reason=0, .pull_duration_ms=0.0f, .device_id=1, .device_role=0, .stroke_count=0, .breath_count=0, .entry_angle=0.0f },
    { .t_ms=17633, .ax=5.28f, .ay=-1.88f, .az=4.95f, .gx=-0.002f, .gy=0.107f, .gz=0.878f, .mx=0.0f, .my=0.0f, .mz=0.0f, .roll=0.0f, .pitch=0.0f, .yaw=0.0f, .qw=0.9604f, .qx=-0.0731f, .qy=-0.2539f, .qz=0.0884f, .lia_x=0.68f, .lia_y=0.2f, .lia_z=-3.0f, .temp=0.0f, .sys_cal=0, .gyro_cal=3, .accel_cal=3, .mag_cal=3, .haptic_fired=0, .deviation_score=0.0f, .haptic_reason=0, .pull_duration_ms=0.0f, .device_id=1, .device_role=0, .stroke_count=0, .breath_count=0, .entry_angle=0.0f },
    { .t_ms=17651, .ax=5.33f, .ay=-1.69f, .az=6.09f, .gx=0.208f, .gy=0.346f, .gz=0.845f, .mx=0.0f, .my=0.0f, .mz=0.0f, .roll=0.0f, .pitch=0.0f, .yaw=0.0f, .qw=0.9608f, .qx=-0.074f, .qy=-0.2495f, .qz=0.0964f, .lia_x=1.19f, .lia_y=-0.08f, .lia_z=-2.46f, .temp=0.0f, .sys_cal=0, .gyro_cal=3, .accel_cal=3, .mag_cal=3, .haptic_fired=0, .deviation_score=0.0f, .haptic_reason=0, .pull_duration_ms=0.0f, .device_id=1, .device_role=0, .stroke_count=0, .breath_count=0, .entry_angle=0.0f },
    { .t_ms=17672, .ax=5.93f, .ay=-2.08f, .az=5.33f, .gx=-0.035f, .gy=0.432f, .gz=0.857f, .mx=0.0f, .my=0.0f, .mz=0.0f, .roll=0.0f, .pitch=0.0f, .yaw=0.0f, .qw=0.9608f, .qx=-0.0764f, .qy=-0.2455f, .qz=0.1039f, .lia_x=1.55f, .lia_y=-0.62f, .lia_z=-4.09f, .temp=0.0f, .sys_cal=0, .gyro_cal=3, .accel_cal=3, .mag_cal=3, .haptic_fired=0, .deviation_score=0.0f, .haptic_reason=0, .pull_duration_ms=0.0f, .device_id=1, .device_role=0, .stroke_count=0, .breath_count=0, .entry_angle=0.0f },
    { .t_ms=17689, .ax=6.02f, .ay=-2.56f, .az=4.41f, .gx=0.324f, .gy=0.095f, .gz=0.716f, .mx=0.0f, .my=0.0f, .mz=0.0f, .roll=0.0f, .pitch=0.0f, .yaw=0.0f, .qw=0.9606f, .qx=-0.0758f, .qy=-0.2446f, .qz=0.111f, .lia_x=1.32f, .lia_y=-0.7f, .lia_z=-4.43f, .temp=0.0f, .sys_cal=0, .gyro_cal=3, .accel_cal=3, .mag_cal=3, .haptic_fired=0, .deviation_score=0.0f, .haptic_reason=0, .pull_duration_ms=0.0f, .device_id=1, .device_role=0, .stroke_count=0, .breath_count=0, .entry_angle=0.0f },
    { .t_ms=17706, .ax=5.77f, .ay=-2.61f, .az=3.39f, .gx=0.812f, .gy=-0.136f, .gz=0.357f, .mx=0.0f, .my=0.0f, .mz=0.0f, .roll=0.0f, .pitch=0.0f, .yaw=0.0f, .qw=0.9604f, .qx=-0.0665f, .qy=-0.2447f, .qz=0.1152f, .lia_x=0.59f, .lia_y=-0.19f, .lia_z=-5.26f, .temp=0.0f, .sys_cal=0, .gyro_cal=3, .accel_cal=3, .mag_cal=3, .haptic_fired=0, .deviation_score=0.0f, .haptic_reason=0, .pull_duration_ms=0.0f, .device_id=1, .device_role=0, .stroke_count=0, .breath_count=0, .entry_angle=0.0f },
    { .t_ms=17732, .ax=4.85f, .ay=-1.53f, .az=3.52f, .gx=0.541f, .gy=-0.159f, .gz=-0.073f, .mx=0.0f, .my=0.0f, .mz=0.0f, .roll=0.0f, .pitch=0.0f, .yaw=0.0f, .qw=0.9605f, .qx=-0.0628f, .qy=-0.2457f, .qz=0.1146f, .lia_x=0.16f, .lia_y=0.67f, .lia_z=-5.04f, .temp=0.0f, .sys_cal=0, .gyro_cal=3, .accel_cal=3, .mag_cal=3, .haptic_fired=0, .deviation_score=0.0f, .haptic_reason=0, .pull_duration_ms=0.0f, .device_id=1, .device_role=0, .stroke_count=0, .breath_count=0, .entry_angle=0.0f },
    { .t_ms=17749, .ax=4.64f, .ay=-1.05f, .az=2.21f, .gx=-0.22f, .gy=-0.021f, .gz=-0.42f, .mx=0.0f, .my=0.0f, .mz=0.0f, .roll=0.0f, .pitch=0.0f, .yaw=0.0f, .qw=0.9611f, .qx=-0.0633f, .qy=-0.2455f, .qz=0.1093f, .lia_x=-0.88f, .lia_y=-0.06f, .lia_z=-6.72f, .temp=0.0f, .sys_cal=0, .gyro_cal=3, .accel_cal=3, .mag_cal=3, .haptic_fired=0, .deviation_score=0.0f, .haptic_reason=0, .pull_duration_ms=0.0f, .device_id=1, .device_role=0, .stroke_count=0, .breath_count=0, .entry_angle=0.0f },
    { .t_ms=17772, .ax=3.24f, .ay=-1.95f, .az=1.57f, .gx=0.436f, .gy=0.4f, .gz=-0.778f, .mx=0.0f, .my=0.0f, .mz=0.0f, .roll=0.0f, .pitch=0.0f, .yaw=0.0f, .qw=0.9621f, .qx=-0.0605f, .qy=-0.2437f, .qz=0.1061f, .lia_x=-1.23f, .lia_y=-0.3f, .lia_z=-6.99f, .temp=0.0f, .sys_cal=0, .gyro_cal=3, .accel_cal=3, .mag_cal=3, .haptic_fired=0, .deviation_score=0.0f, .haptic_reason=0, .pull_duration_ms=0.0f, .device_id=1, .device_role=0, .stroke_count=0, .breath_count=0, .entry_angle=0.0f },
    { .t_ms=17790, .ax=2.94f, .ay=-1.68f, .az=1.31f, .gx=1.18f, .gy=0.573f, .gz=-0.748f, .mx=0.0f, .my=0.0f, .mz=0.0f, .roll=0.0f, .pitch=0.0f, .yaw=0.0f, .qw=0.9651f, .qx=-0.0359f, .qy=-0.2316f, .qz=0.1007f, .lia_x=-2.31f, .lia_y=0.71f, .lia_z=-9.03f, .temp=0.0f, .sys_cal=0, .gyro_cal=3, .accel_cal=3, .mag_cal=3, .haptic_fired=0, .deviation_score=0.0f, .haptic_reason=0, .pull_duration_ms=0.0f, .device_id=1, .device_role=0, .stroke_count=0, .breath_count=0, .entry_angle=0.0f },
    { .t_ms=17812, .ax=1.73f, .ay=0.11f, .az=-0.34f, .gx=1.813f, .gy=0.954f, .gz=-0.705f, .mx=0.0f, .my=0.0f, .mz=0.0f, .roll=0.0f, .pitch=0.0f, .yaw=0.0f, .qw=0.9702f, .qx=-0.0211f, .qy=-0.2214f, .qz=0.0968f, .lia_x=-3.26f, .lia_y=2.25f, .lia_z=-8.45f, .temp=0.0f, .sys_cal=0, .gyro_cal=3, .accel_cal=3, .mag_cal=3, .haptic_fired=0, .deviation_score=0.0f, .haptic_reason=0, .pull_duration_ms=0.0f, .device_id=1, .device_role=0, .stroke_count=0, .breath_count=0, .entry_angle=0.0f },
    { .t_ms=17832, .ax=0.3f, .ay=1.14f, .az=-0.07f, .gx=0.352f, .gy=0.99f, .gz=-0.957f, .mx=0.0f, .my=0.0f, .mz=0.0f, .roll=0.0f, .pitch=0.0f, .yaw=0.0f, .qw=0.9733f, .qx=-0.0196f, .qy=-0.2117f, .qz=0.0867f, .lia_x=-4.27f, .lia_y=1.12f, .lia_z=-9.64f, .temp=0.0f, .sys_cal=0, .gyro_cal=3, .accel_cal=3, .mag_cal=3, .haptic_fired=0, .deviation_score=0.0f, .haptic_reason=0, .pull_duration_ms=0.0f, .device_id=1, .device_role=0, .stroke_count=0, .breath_count=0, .entry_angle=0.0f },
    { .t_ms=17850, .ax=-0.26f, .ay=0.38f, .az=-0.15f, .gx=-0.266f, .gy=1.334f, .gz=-1.305f, .mx=0.0f, .my=0.0f, .mz=0.0f, .roll=0.0f, .pitch=0.0f, .yaw=0.0f, .qw=0.9774f, .qx=-0.0175f, .qy=-0.197f, .qz=0.0744f, .lia_x=-8.39f, .lia_y=2.44f, .lia_z=-8.3f, .temp=0.0f, .sys_cal=0, .gyro_cal=3, .accel_cal=3, .mag_cal=3, .haptic_fired=0, .deviation_score=0.0f, .haptic_reason=0, .pull_duration_ms=0.0f, .device_id=1, .device_role=0, .stroke_count=0, .breath_count=0, .entry_angle=0.0f },
    { .t_ms=17871, .ax=-4.64f, .ay=2.41f, .az=1.6f, .gx=1.377f, .gy=2.578f, .gz=-1.131f, .mx=0.0f, .my=0.0f, .mz=0.0f, .roll=0.0f, .pitch=0.0f, .yaw=0.0f, .qw=0.9834f, .qx=-0.0003f, .qy=-0.168f, .qz=0.0681f, .lia_x=-10.03f, .lia_y=3.09f, .lia_z=-6.13f, .temp=0.0f, .sys_cal=0, .gyro_cal=3, .accel_cal=3, .mag_cal=3, .haptic_fired=0, .deviation_score=0.0f, .haptic_reason=0, .pull_duration_ms=0.0f, .device_id=1, .device_role=0, .stroke_count=0, .breath_count=0, .entry_angle=0.0f },
    { .t_ms=17889, .ax=-6.79f, .ay=2.86f, .az=3.11f, .gx=2.298f, .gy=3.913f, .gz=-0.195f, .mx=0.0f, .my=0.0f, .mz=0.0f, .roll=0.0f, .pitch=0.0f, .yaw=0.0f, .qw=0.9864f, .qx=0.0116f, .qy=-0.1485f, .qz=0.0732f, .lia_x=-10.39f, .lia_y=1.81f, .lia_z=1.49f, .temp=0.0f, .sys_cal=0, .gyro_cal=3, .accel_cal=3, .mag_cal=3, .haptic_fired=0, .deviation_score=0.0f, .haptic_reason=0, .pull_duration_ms=0.0f, .device_id=1, .device_role=0, .stroke_count=0, .breath_count=0, .entry_angle=0.0f },
    { .t_ms=17907, .ax=-7.89f, .ay=2.04f, .az=10.97f, .gx=2.342f, .gy=4.12f, .gz=0.773f, .mx=0.0f, .my=0.0f, .mz=0.0f, .roll=0.0f, .pitch=0.0f, .yaw=0.0f, .qw=0.9909f, .qx=0.0234f, .qy=-0.0915f, .qz=0.0807f, .lia_x=-8.66f, .lia_y=1.77f, .lia_z=3.93f, .temp=0.0f, .sys_cal=0, .gyro_cal=3, .accel_cal=3, .mag_cal=3, .haptic_fired=0, .deviation_score=0.0f, .haptic_reason=0, .pull_duration_ms=0.0f, .device_id=1, .device_role=0, .stroke_count=1, .breath_count=0, .entry_angle=10.67f },
    { .t_ms=17929, .ax=-6.85f, .ay=1.96f, .az=13.57f, .gx=-2.164f, .gy=2.526f, .gz=-0.057f, .mx=0.0f, .my=0.0f, .mz=0.0f, .roll=0.0f, .pitch=0.0f, .yaw=0.0f, .qw=0.9936f, .qx=0.0059f, .qy=-0.0802f, .qz=0.0738f, .lia_x=-9.75f, .lia_y=3.62f, .lia_z=7.12f, .temp=0.0f, .sys_cal=0, .gyro_cal=3, .accel_cal=3, .mag_cal=3, .haptic_fired=0, .deviation_score=0.0f, .haptic_reason=0, .pull_duration_ms=0.0f, .device_id=1, .device_role=0, .stroke_count=1, .breath_count=0, .entry_angle=0.0f },
    { .t_ms=17946, .ax=-8.38f, .ay=3.42f, .az=16.83f, .gx=-2.152f, .gy=2.071f, .gz=-1.071f, .mx=0.0f, .my=0.0f, .mz=0.0f, .roll=0.0f, .pitch=0.0f, .yaw=0.0f, .qw=0.9961f, .qx=-0.0118f, .qy=-0.0614f, .qz=0.0626f, .lia_x=-10.86f, .lia_y=3.77f, .lia_z=9.14f, .temp=0.0f, .sys_cal=0, .gyro_cal=3, .accel_cal=3, .mag_cal=3, .haptic_fired=0, .deviation_score=0.0f, .haptic_reason=0, .pull_duration_ms=0.0f, .device_id=1, .device_role=0, .stroke_count=1, .breath_count=0, .entry_angle=0.0f },
    { .t_ms=17966, .ax=-9.89f, .ay=3.43f, .az=18.89f, .gx=-0.711f, .gy=2.404f, .gz=-2.901f, .mx=0.0f, .my=0.0f, .mz=0.0f, .roll=0.0f, .pitch=0.0f, .yaw=0.0f, .qw=0.9985f, .qx=-0.0166f, .qy=-0.0381f, .qz=0.0339f, .lia_x=-9.2f, .lia_y=1.8f, .lia_z=8.32f, .temp=0.0f, .sys_cal=0, .gyro_cal=3, .accel_cal=3, .mag_cal=3, .haptic_fired=0, .deviation_score=0.0f, .haptic_reason=0, .pull_duration_ms=0.0f, .device_id=1, .device_role=0, .stroke_count=1, .breath_count=0, .entry_angle=0.0f },
    { .t_ms=17986, .ax=-8.68f, .ay=1.44f, .az=18.11f, .gx=-0.215f, .gy=2.399f, .gz=-2.19f, .mx=0.0f, .my=0.0f, .mz=0.0f, .roll=0.0f, .pitch=0.0f, .yaw=0.0f, .qw=0.9995f, .qx=-0.0186f, .qy=-0.0176f, .qz=0.0175f, .lia_x=-8.05f, .lia_y=1.29f, .lia_z=7.47f, .temp=0.0f, .sys_cal=0, .gyro_cal=3, .accel_cal=3, .mag_cal=3, .haptic_fired=0, .deviation_score=0.0f, .haptic_reason=0, .pull_duration_ms=0.0f, .device_id=1, .device_role=0, .stroke_count=1, .breath_count=0, .entry_angle=0.0f },
    { .t_ms=18003, .ax=-5.51f, .ay=0.14f, .az=15.82f, .gx=-0.166f, .gy=1.448f, .gz=-0.07f, .mx=0.0f, .my=0.0f, .mz=0.0f, .roll=0.0f, .pitch=0.0f, .yaw=0.0f, .qw=0.9996f, .qx=-0.0196f, .qy=-0.0053f, .qz=0.0199f, .lia_x=-4.96f, .lia_y=-0.11f, .lia_z=4.89f, .temp=0.0f, .sys_cal=0, .gyro_cal=3, .accel_cal=3, .mag_cal=3, .haptic_fired=0, .deviation_score=0.0f, .haptic_reason=0, .pull_duration_ms=0.0f, .device_id=1, .device_role=0, .stroke_count=1, .breath_count=0, .entry_angle=0.0f },
    { .t_ms=18025, .ax=-4.43f, .ay=-1.03f, .az=14.69f, .gx=0.278f, .gy=0.92f, .gz=0.89f, .mx=0.0f, .my=0.0f, .mz=0.0f, .roll=0.0f, .pitch=0.0f, .yaw=0.0f, .qw=0.9995f, .qx=-0.0161f, .qy=0.0034f, .qz=0.0284f, .lia_x=-3.91f, .lia_y=-0.95f, .lia_z=4.96f, .temp=0.0f, .sys_cal=0, .gyro_cal=3, .accel_cal=3, .mag_cal=3, .haptic_fired=0, .deviation_score=0.0f, .haptic_reason=0, .pull_duration_ms=0.0f, .device_id=1, .device_role=0, .stroke_count=1, .breath_count=0, .entry_angle=0.0f },
    { .t_ms=18042, .ax=-3.98f, .ay=-1.78f, .az=13.84f, .gx=0.564f, .gy=0.816f, .gz=0.796f, .mx=0.0f, .my=0.0f, .mz=0.0f, .roll=0.0f, .pitch=0.0f, .yaw=0.0f, .qw=0.9993f, .qx=-0.0104f, .qy=0.0118f, .qz=0.0352f, .lia_x=-2.0f, .lia_y=-1.52f, .lia_z=3.68f, .temp=0.0f, .sys_cal=0, .gyro_cal=3, .accel_cal=3, .mag_cal=3, .haptic_fired=0, .deviation_score=0.0f, .haptic_reason=0, .pull_duration_ms=0.0f, .device_id=1, .device_role=0, .stroke_count=1, .breath_count=0, .entry_angle=0.0f },
    { .t_ms=18062, .ax=-2.24f, .ay=-1.09f, .az=13.02f, .gx=0.867f, .gy=0.88f, .gz=0.482f, .mx=0.0f, .my=0.0f, .mz=0.0f, .roll=0.0f, .pitch=0.0f, .yaw=0.0f, .qw=0.999f, .qx=-0.0009f, .qy=0.0209f, .qz=0.0391f, .lia_x=-0.83f, .lia_y=-0.23f, .lia_z=2.79f, .temp=0.0f, .sys_cal=0, .gyro_cal=3, .accel_cal=3, .mag_cal=3, .haptic_fired=0, .deviation_score=0.0f, .haptic_reason=0, .pull_duration_ms=0.0f, .device_id=1, .device_role=0, .stroke_count=1, .breath_count=0, .entry_angle=0.0f },
    { .t_ms=18090, .ax=-1.42f, .ay=0.18f, .az=12.91f, .gx=1.182f, .gy=0.832f, .gz=0.111f, .mx=0.0f, .my=0.0f, .mz=0.0f, .roll=0.0f, .pitch=0.0f, .yaw=0.0f, .qw=0.9987f, .qx=0.0144f, .qy=0.0336f, .qz=0.041f, .lia_x=-1.34f, .lia_y=-0.53f, .lia_z=3.79f, .temp=0.0f, .sys_cal=0, .gyro_cal=3, .accel_cal=3, .mag_cal=3, .haptic_fired=0, .deviation_score=0.0f, .haptic_reason=0, .pull_duration_ms=0.0f, .device_id=1, .device_role=0, .stroke_count=1, .breath_count=0, .entry_angle=0.0f },
    { .t_ms=18109, .ax=-1.98f, .ay=-0.22f, .az=13.57f, .gx=0.196f, .gy=0.657f, .gz=0.215f, .mx=0.0f, .my=0.0f, .mz=0.0f, .roll=0.0f, .pitch=0.0f, .yaw=0.0f, .qw=0.9982f, .qx=0.0136f, .qy=0.0396f, .qz=0.0438f, .lia_x=-1.26f, .lia_y=-2.15f, .lia_z=4.2f, .temp=0.0f, .sys_cal=0, .gyro_cal=3, .accel_cal=3, .mag_cal=3, .haptic_fired=0, .deviation_score=0.0f, .haptic_reason=0, .pull_duration_ms=0.0f, .device_id=1, .device_role=0, .stroke_count=1, .breath_count=0, .entry_angle=0.0f },
    { .t_ms=18129, .ax=-2.03f, .ay=-1.85f, .az=13.97f, .gx=-0.334f, .gy=0.491f, .gz=0.489f, .mx=0.0f, .my=0.0f, .mz=0.0f, .roll=0.0f, .pitch=0.0f, .yaw=0.0f, .qw=0.998f, .qx=0.0101f, .qy=0.0417f, .qz=0.0463f, .lia_x=-0.31f, .lia_y=-2.04f, .lia_z=3.43f, .temp=0.0f, .sys_cal=0, .gyro_cal=3, .accel_cal=3, .mag_cal=3, .haptic_fired=0, .deviation_score=0.0f, .haptic_reason=0, .pull_duration_ms=0.0f, .device_id=1, .device_role=0, .stroke_count=1, .breath_count=0, .entry_angle=0.0f },
    { .t_ms=18147, .ax=-1.15f, .ay=-1.88f, .az=13.2f, .gx=-0.856f, .gy=0.371f, .gz=0.55f, .mx=0.0f, .my=0.0f, .mz=0.0f, .roll=0.0f, .pitch=0.0f, .yaw=0.0f, .qw=0.9977f, .qx=0.0028f, .qy=0.0444f, .qz=0.0516f, .lia_x=1.63f, .lia_y=-0.1f, .lia_z=0.67f, .temp=0.0f, .sys_cal=0, .gyro_cal=3, .accel_cal=3, .mag_cal=3, .haptic_fired=0, .deviation_score=0.0f, .haptic_reason=0, .pull_duration_ms=0.0f, .device_id=1, .device_role=0, .stroke_count=1, .breath_count=0, .entry_angle=0.0f },
    { .t_ms=18166, .ax=0.75f, .ay=-0.01f, .az=10.44f, .gx=-0.134f, .gy=0.227f, .gz=0.019f, .mx=0.0f, .my=0.0f, .mz=0.0f, .roll=0.0f, .pitch=0.0f, .yaw=0.0f, .qw=0.9975f, .qx=0.0048f, .qy=0.0466f, .qz=0.053f, .lia_x=1.48f, .lia_y=0.47f, .lia_z=0.92f, .temp=0.0f, .sys_cal=0, .gyro_cal=3, .accel_cal=3, .mag_cal=3, .haptic_fired=0, .deviation_score=0.0f, .haptic_reason=0, .pull_duration_ms=0.0f, .device_id=1, .device_role=0, .stroke_count=1, .breath_count=0, .entry_angle=0.0f },
    { .t_ms=18186, .ax=0.02f, .ay=0.71f, .az=10.68f, .gx=1.058f, .gy=0.171f, .gz=-0.201f, .mx=0.0f, .my=0.0f, .mz=0.0f, .roll=0.0f, .pitch=0.0f, .yaw=0.0f, .qw=0.9974f, .qx=0.0152f, .qy=0.0489f, .qz=0.0502f, .lia_x=-0.1f, .lia_y=-0.7f, .lia_z=2.01f, .temp=0.0f, .sys_cal=0, .gyro_cal=3, .accel_cal=3, .mag_cal=3, .haptic_fired=0, .deviation_score=0.0f, .haptic_reason=0, .pull_duration_ms=0.0f, .device_id=1, .device_role=0, .stroke_count=1, .breath_count=0, .entry_angle=0.0f },
    { .t_ms=18203, .ax=-1.39f, .ay=-0.93f, .az=11.88f, .gx=0.806f, .gy=0.269f, .gz=-0.149f, .mx=0.0f, .my=0.0f, .mz=0.0f, .roll=0.0f, .pitch=0.0f, .yaw=0.0f, .qw=0.9972f, .qx=0.0202f, .qy=0.0523f, .qz=0.0499f, .lia_x=-0.63f, .lia_y=-1.86f, .lia_z=2.2f, .temp=0.0f, .sys_cal=0, .gyro_cal=3, .accel_cal=3, .mag_cal=3, .haptic_fired=0, .deviation_score=0.0f, .haptic_reason=0, .pull_duration_ms=0.0f, .device_id=1, .device_role=0, .stroke_count=1, .breath_count=0, .entry_angle=0.0f },
    { .t_ms=18224, .ax=-1.64f, .ay=-1.75f, .az=12.14f, .gx=-0.292f, .gy=0.456f, .gz=0.4f, .mx=0.0f, .my=0.0f, .mz=0.0f, .roll=0.0f, .pitch=0.0f, .yaw=0.0f, .qw=0.9968f, .qx=0.0154f, .qy=0.0563f, .qz=0.0547f, .lia_x=-0.33f, .lia_y=-2.04f, .lia_z=2.18f, .temp=0.0f, .sys_cal=0, .gyro_cal=3, .accel_cal=3, .mag_cal=3, .haptic_fired=0, .deviation_score=0.0f, .haptic_reason=0, .pull_duration_ms=0.0f, .device_id=1, .device_role=0, .stroke_count=1, .breath_count=0, .entry_angle=0.0f },
    { .t_ms=18241, .ax=-1.41f, .ay=-1.67f, .az=11.5f, .gx=-0.916f, .gy=0.351f, .gz=0.482f, .mx=0.0f, .my=0.0f, .mz=0.0f, .roll=0.0f, .pitch=0.0f, .yaw=0.0f, .qw=0.9966f, .qx=0.0069f, .qy=0.0585f, .qz=0.0588f, .lia_x=0.79f, .lia_y=-1.26f, .lia_z=1.01f, .temp=0.0f, .sys_cal=0, .gyro_cal=3, .accel_cal=3, .mag_cal=3, .haptic_fired=0, .deviation_score=0.0f, .haptic_reason=0, .pull_duration_ms=0.0f, .device_id=1, .device_role=0, .stroke_count=1, .breath_count=0, .entry_angle=0.0f },
    { .t_ms=18260, .ax=-0.33f, .ay=-1.06f, .az=9.69f, .gx=-0.444f, .gy=0.073f, .gz=-0.032f, .mx=0.0f, .my=0.0f, .mz=0.0f, .roll=0.0f, .pitch=0.0f, .yaw=0.0f, .qw=0.9966f, .qx=0.0054f, .qy=0.0589f, .qz=0.0569f, .lia_x=0.64f, .lia_y=0.74f, .lia_z=-0.44f, .temp=0.0f, .sys_cal=0, .gyro_cal=3, .accel_cal=3, .mag_cal=3, .haptic_fired=0, .deviation_score=0.0f, .haptic_reason=0, .pull_duration_ms=0.0f, .device_id=1, .device_role=0, .stroke_count=1, .breath_count=0, .entry_angle=0.0f },
    { .t_ms=18280, .ax=-0.49f, .ay=0.91f, .az=9.29f, .gx=0.688f, .gy=0.002f, .gz=-0.648f, .mx=0.0f, .my=0.0f, .mz=0.0f, .roll=0.0f, .pitch=0.0f, .yaw=0.0f, .qw=0.9968f, .qx=0.0085f, .qy=0.0591f, .qz=0.0499f, .lia_x=-0.4f, .lia_y=0.72f, .lia_z=-0.02f, .temp=0.0f, .sys_cal=0, .gyro_cal=3, .accel_cal=3, .mag_cal=3, .haptic_fired=0, .deviation_score=0.0f, .haptic_reason=0, .pull_duration_ms=0.0f, .device_id=1, .device_role=0, .stroke_count=1, .breath_count=0, .entry_angle=0.0f },
    { .t_ms=18297, .ax=-1.54f, .ay=1.03f, .az=9.71f, .gx=0.99f, .gy=-0.014f, .gz=-0.728f, .mx=0.0f, .my=0.0f, .mz=0.0f, .roll=0.0f, .pitch=0.0f, .yaw=0.0f, .qw=0.9969f, .qx=0.0176f, .qy=0.0598f, .qz=0.0468f, .lia_x=-1.3f, .lia_y=-0.36f, .lia_z=1.03f, .temp=0.0f, .sys_cal=0, .gyro_cal=3, .accel_cal=3, .mag_cal=3, .haptic_fired=0, .deviation_score=0.0f, .haptic_reason=0, .pull_duration_ms=0.0f, .device_id=1, .device_role=0, .stroke_count=1, .breath_count=0, .entry_angle=0.0f },
    { .t_ms=18317, .ax=-2.49f, .ay=0.05f, .az=10.76f, .gx=0.215f, .gy=0.312f, .gz=0.125f, .mx=0.0f, .my=0.0f, .mz=0.0f, .roll=0.0f, .pitch=0.0f, .yaw=0.0f, .qw=0.9964f, .qx=0.0182f, .qy=0.0654f, .qz=0.0508f, .lia_x=-0.87f, .lia_y=-0.69f, .lia_z=0.76f, .temp=0.0f, .sys_cal=0, .gyro_cal=3, .accel_cal=3, .mag_cal=3, .haptic_fired=0, .deviation_score=0.0f, .haptic_reason=0, .pull_duration_ms=0.0f, .device_id=1, .device_role=0, .stroke_count=1, .breath_count=0, .entry_angle=0.0f },
    { .t_ms=18342, .ax=-2.13f, .ay=-0.16f, .az=10.3f, .gx=-0.235f, .gy=0.515f, .gz=0.491f, .mx=0.0f, .my=0.0f, .mz=0.0f, .roll=0.0f, .pitch=0.0f, .yaw=0.0f, .qw=0.9959f, .qx=0.0168f, .qy=0.0697f, .qz=0.0547f, .lia_x=0.0f, .lia_y=-0.25f, .lia_z=0.08f, .temp=0.0f, .sys_cal=0, .gyro_cal=3, .accel_cal=3, .mag_cal=3, .haptic_fired=0, .deviation_score=0.0f, .haptic_reason=0, .pull_duration_ms=0.0f, .device_id=1, .device_role=0, .stroke_count=1, .breath_count=0, .entry_angle=0.0f },
    { .t_ms=18361, .ax=-1.35f, .ay=0.56f, .az=9.34f, .gx=0.208f, .gy=0.243f, .gz=0.041f, .mx=0.0f, .my=0.0f, .mz=0.0f, .roll=0.0f, .pitch=0.0f, .yaw=0.0f, .qw=0.9958f, .qx=0.0199f, .qy=0.0717f, .qz=0.0538f, .lia_x=-0.14f, .lia_y=0.35f, .lia_z=-0.08f, .temp=0.0f, .sys_cal=0, .gyro_cal=3, .accel_cal=3, .mag_cal=3, .haptic_fired=0, .deviation_score=0.0f, .haptic_reason=0, .pull_duration_ms=0.0f, .device_id=1, .device_role=0, .stroke_count=1, .breath_count=0, .entry_angle=0.0f },
    { .t_ms=18380, .ax=-1.52f, .ay=0.81f, .az=10.12f, .gx=0.524f, .gy=0.119f, .gz=-0.261f, .mx=0.0f, .my=0.0f, .mz=0.0f, .roll=0.0f, .pitch=0.0f, .yaw=0.0f, .qw=0.9957f, .qx=0.0223f, .qy=0.0735f, .qz=0.0516f, .lia_x=-0.87f, .lia_y=-0.67f, .lia_z=0.9f, .temp=0.0f, .sys_cal=0, .gyro_cal=3, .accel_cal=3, .mag_cal=3, .haptic_fired=0, .deviation_score=0.0f, .haptic_reason=0, .pull_duration_ms=0.0f, .device_id=1, .device_role=0, .stroke_count=1, .breath_count=0, .entry_angle=0.0f },
    { .t_ms=18398, .ax=-2.28f, .ay=-0.13f, .az=10.59f, .gx=0.372f, .gy=0.209f, .gz=0.093f, .mx=0.0f, .my=0.0f, .mz=0.0f, .roll=0.0f, .pitch=0.0f, .yaw=0.0f, .qw=0.9955f, .qx=0.0243f, .qy=0.0748f, .qz=0.0535f, .lia_x=-0.88f, .lia_y=-1.1f, .lia_z=0.98f, .temp=0.0f, .sys_cal=0, .gyro_cal=3, .accel_cal=3, .mag_cal=3, .haptic_fired=0, .deviation_score=0.0f, .haptic_reason=0, .pull_duration_ms=0.0f, .device_id=1, .device_role=0, .stroke_count=1, .breath_count=0, .entry_angle=0.0f },
    { .t_ms=18421, .ax=-2.35f, .ay=-0.45f, .az=10.67f, .gx=-0.156f, .gy=0.261f, .gz=0.283f, .mx=0.0f, .my=0.0f, .mz=0.0f, .roll=0.0f, .pitch=0.0f, .yaw=0.0f, .qw=0.9951f, .qx=0.0228f, .qy=0.0782f, .qz=0.0557f, .lia_x=-0.77f, .lia_y=-0.87f, .lia_z=1.16f, .temp=0.0f, .sys_cal=0, .gyro_cal=3, .accel_cal=3, .mag_cal=3, .haptic_fired=0, .deviation_score=0.0f, .haptic_reason=0, .pull_duration_ms=0.0f, .device_id=1, .device_role=0, .stroke_count=1, .breath_count=0, .entry_angle=0.0f },
    { .t_ms=18441, .ax=-2.27f, .ay=-0.34f, .az=10.71f, .gx=0.205f, .gy=0.113f, .gz=-0.037f, .mx=0.0f, .my=0.0f, .mz=0.0f, .roll=0.0f, .pitch=0.0f, .yaw=0.0f, .qw=0.9951f, .qx=0.0259f, .qy=0.0792f, .qz=0.0543f, .lia_x=-0.32f, .lia_y=-0.4f, .lia_z=0.69f, .temp=0.0f, .sys_cal=0, .gyro_cal=3, .accel_cal=3, .mag_cal=3, .haptic_fired=0, .deviation_score=0.0f, .haptic_reason=0, .pull_duration_ms=0.0f, .device_id=1, .device_role=0, .stroke_count=1, .breath_count=0, .entry_angle=0.0f },
    { .t_ms=18459, .ax=-1.84f, .ay=0.18f, .az=10.36f, .gx=0.693f, .gy=-0.003f, .gz=-0.344f, .mx=0.0f, .my=0.0f, .mz=0.0f, .roll=0.0f, .pitch=0.0f, .yaw=0.0f, .qw=0.9951f, .qx=0.0331f, .qy=0.0794f, .qz=0.0499f, .lia_x=-0.24f, .lia_y=0.32f, .lia_z=0.0f, .temp=0.0f, .sys_cal=0, .gyro_cal=3, .accel_cal=3, .mag_cal=3, .haptic_fired=0, .deviation_score=0.0f, .haptic_reason=0, .pull_duration_ms=0.0f, .device_id=1, .device_role=0, .stroke_count=1, .breath_count=0, .entry_angle=0.0f },
    { .t_ms=18479, .ax=-1.76f, .ay=1.04f, .az=9.65f, .gx=0.86f, .gy=-0.095f, .gz=-0.413f, .mx=0.0f, .my=0.0f, .mz=0.0f, .roll=0.0f, .pitch=0.0f, .yaw=0.0f, .qw=0.995f, .qx=0.0372f, .qy=0.0792f, .qz=0.0476f, .lia_x=-0.9f, .lia_y=0.22f, .lia_z=0.61f, .temp=0.0f, .sys_cal=0, .gyro_cal=3, .accel_cal=3, .mag_cal=3, .haptic_fired=0, .deviation_score=0.0f, .haptic_reason=0, .pull_duration_ms=0.0f, .device_id=1, .device_role=0, .stroke_count=1, .breath_count=0, .entry_angle=0.0f },
    { .t_ms=18497, .ax=-2.4f, .ay=1.08f, .az=10.27f, .gx=0.711f, .gy=-0.088f, .gz=-0.297f, .mx=0.0f, .my=0.0f, .mz=0.0f, .roll=0.0f, .pitch=0.0f, .yaw=0.0f, .qw=0.9949f, .qx=0.0421f, .qy=0.079f, .qz=0.0453f, .lia_x=-1.04f, .lia_y=-0.3f, .lia_z=1.14f, .temp=0.0f, .sys_cal=0, .gyro_cal=3, .accel_cal=3, .mag_cal=3, .haptic_fired=0, .deviation_score=0.0f, .haptic_reason=0, .pull_duration_ms=0.0f, .device_id=1, .device_role=0, .stroke_count=1, .breath_count=0, .entry_angle=0.0f },
    { .t_ms=18516, .ax=-2.5f, .ay=0.57f, .az=10.79f, .gx=-0.128f, .gy=0.06f, .gz=0.112f, .mx=0.0f, .my=0.0f, .mz=0.0f, .roll=0.0f, .pitch=0.0f, .yaw=0.0f, .qw=0.9949f, .qx=0.0392f, .qy=0.0797f, .qz=0.0474f, .lia_x=-0.77f, .lia_y=-0.68f, .lia_z=1.24f, .temp=0.0f, .sys_cal=0, .gyro_cal=3, .accel_cal=3, .mag_cal=3, .haptic_fired=0, .deviation_score=0.0f, .haptic_reason=0, .pull_duration_ms=609.0f, .device_id=1, .device_role=0, .stroke_count=1, .breath_count=0, .entry_angle=0.0f },
    { .t_ms=18536, .ax=-2.07f, .ay=-0.03f, .az=10.89f, .gx=-0.694f, .gy=0.148f, .gz=0.317f, .mx=0.0f, .my=0.0f, .mz=0.0f, .roll=0.0f, .pitch=0.0f, .yaw=0.0f, .qw=0.9949f, .qx=0.0327f, .qy=0.0806f, .qz=0.0507f, .lia_x=-0.26f, .lia_y=-0.92f, .lia_z=1.16f, .temp=0.0f, .sys_cal=0, .gyro_cal=3, .accel_cal=3, .mag_cal=3, .haptic_fired=0, .deviation_score=0.0f, .haptic_reason=0, .pull_duration_ms=0.0f, .device_id=1, .device_role=0, .stroke_count=1, .breath_count=0, .entry_angle=0.0f },
    { .t_ms=18554, .ax=-1.47f, .ay=-0.25f, .az=10.66f, .gx=-0.521f, .gy=0.069f, .gz=0.104f, .mx=0.0f, .my=0.0f, .mz=0.0f, .roll=0.0f, .pitch=0.0f, .yaw=0.0f, .qw=0.995f, .qx=0.0289f, .qy=0.0807f, .qz=0.0513f, .lia_x=0.08f, .lia_y=-0.83f, .lia_z=0.98f, .temp=0.0f, .sys_cal=0, .gyro_cal=3, .accel_cal=3, .mag_cal=3, .haptic_fired=0, .deviation_score=0.0f, .haptic_reason=0, .pull_duration_ms=0.0f, .device_id=1, .device_role=0, .stroke_count=1, .breath_count=0, .entry_angle=0.0f },
    { .t_ms=18575, .ax=-1.59f, .ay=-0.15f, .az=10.64f, .gx=-0.019f, .gy=-0.024f, .gz=-0.192f, .mx=0.0f, .my=0.0f, .mz=0.0f, .roll=0.0f, .pitch=0.0f, .yaw=0.0f, .qw=0.9951f, .qx=0.0296f, .qy=0.0807f, .qz=0.0488f, .lia_x=-0.12f, .lia_y=-0.89f, .lia_z=0.96f, .temp=0.0f, .sys_cal=0, .gyro_cal=3, .accel_cal=3, .mag_cal=3, .haptic_fired=0, .deviation_score=0.0f, .haptic_reason=0, .pull_duration_ms=0.0f, .device_id=1, .device_role=0, .stroke_count=1, .breath_count=0, .entry_angle=0.0f },
    { .t_ms=18592, .ax=-1.67f, .ay=-0.44f, .az=10.89f, .gx=0.376f, .gy=0.068f, .gz=-0.335f, .mx=0.0f, .my=0.0f, .mz=0.0f, .roll=0.0f, .pitch=0.0f, .yaw=0.0f, .qw=0.9951f, .qx=0.033f, .qy=0.0818f, .qz=0.0456f, .lia_x=-0.49f, .lia_y=-1.14f, .lia_z=1.51f, .temp=0.0f, .sys_cal=0, .gyro_cal=3, .accel_cal=3, .mag_cal=3, .haptic_fired=0, .deviation_score=0.0f, .haptic_reason=0, .pull_duration_ms=0.0f, .device_id=1, .device_role=0, .stroke_count=1, .breath_count=0, .entry_angle=0.0f },
    { .t_ms=18612, .ax=-2.05f, .ay=-0.27f, .az=11.51f, .gx=0.214f, .gy=0.144f, .gz=-0.183f, .mx=0.0f, .my=0.0f, .mz=0.0f, .roll=0.0f, .pitch=0.0f, .yaw=0.0f, .qw=0.995f, .qx=0.0336f, .qy=0.0833f, .qz=0.0442f, .lia_x=-0.65f, .lia_y=-0.94f, .lia_z=2.01f, .temp=0.0f, .sys_cal=0, .gyro_cal=3, .accel_cal=3, .mag_cal=3, .haptic_fired=0, .deviation_score=0.0f, .haptic_reason=0, .pull_duration_ms=0.0f, .device_id=1, .device_role=0, .stroke_count=1, .breath_count=0, .entry_angle=0.0f },
    { .t_ms=18631, .ax=-2.25f, .ay=-0.21f, .az=11.66f, .gx=-0.283f, .gy=0.105f, .gz=-0.047f, .mx=0.0f, .my=0.0f, .mz=0.0f, .roll=0.0f, .pitch=0.0f, .yaw=0.0f, .qw=0.995f, .qx=0.0322f, .qy=0.0838f, .qz=0.0441f, .lia_x=-0.4f, .lia_y=-0.75f, .lia_z=1.71f, .temp=0.0f, .sys_cal=0, .gyro_cal=3, .accel_cal=3, .mag_cal=3, .haptic_fired=0, .deviation_score=0.0f, .haptic_reason=0, .pull_duration_ms=0.0f, .device_id=1, .device_role=0, .stroke_count=1, .breath_count=0, .entry_angle=0.0f },
    { .t_ms=18648, .ax=-2.01f, .ay=-0.09f, .az=11.36f, .gx=-0.381f, .gy=0.045f, .gz=-0.06f, .mx=0.0f, .my=0.0f, .mz=0.0f, .roll=0.0f, .pitch=0.0f, .yaw=0.0f, .qw=0.9951f, .qx=0.0283f, .qy=0.0837f, .qz=0.0436f, .lia_x=-0.08f, .lia_y=-0.76f, .lia_z=1.42f, .temp=0.0f, .sys_cal=0, .gyro_cal=3, .accel_cal=3, .mag_cal=3, .haptic_fired=0, .deviation_score=0.0f, .haptic_reason=0, .pull_duration_ms=0.0f, .device_id=1, .device_role=0, .stroke_count=1, .breath_count=0, .entry_angle=0.0f },
    { .t_ms=18668, .ax=-1.68f, .ay=-0.18f, .az=11.08f, .gx=-0.413f, .gy=-0.133f, .gz=-0.149f, .mx=0.0f, .my=0.0f, .mz=0.0f, .roll=0.0f, .pitch=0.0f, .yaw=0.0f, .qw=0.9954f, .qx=0.0243f, .qy=0.0825f, .qz=0.043f, .lia_x=-0.11f, .lia_y=-0.9f, .lia_z=1.33f, .temp=0.0f, .sys_cal=0, .gyro_cal=3, .accel_cal=3, .mag_cal=3, .haptic_fired=0, .deviation_score=0.0f, .haptic_reason=0, .pull_duration_ms=0.0f, .device_id=1, .device_role=0, .stroke_count=1, .breath_count=0, .entry_angle=0.0f },
    { .t_ms=18687, .ax=-1.69f, .ay=-0.4f, .az=11.0f, .gx=-0.397f, .gy=-0.128f, .gz=-0.196f, .mx=0.0f, .my=0.0f, .mz=0.0f, .roll=0.0f, .pitch=0.0f, .yaw=0.0f, .qw=0.9956f, .qx=0.0204f, .qy=0.0812f, .qz=0.0412f, .lia_x=-0.15f, .lia_y=-0.88f, .lia_z=0.95f, .temp=0.0f, .sys_cal=0, .gyro_cal=3, .accel_cal=3, .mag_cal=3, .haptic_fired=0, .deviation_score=0.0f, .haptic_reason=0, .pull_duration_ms=0.0f, .device_id=1, .device_role=0, .stroke_count=1, .breath_count=0, .entry_angle=0.0f },
    { .t_ms=18705, .ax=-1.61f, .ay=-0.27f, .az=10.63f, .gx=-0.348f, .gy=-0.065f, .gz=-0.293f, .mx=0.0f, .my=0.0f, .mz=0.0f, .roll=0.0f, .pitch=0.0f, .yaw=0.0f, .qw=0.9958f, .qx=0.0172f, .qy=0.0805f, .qz=0.0385f, .lia_x=-0.03f, .lia_y=-0.55f, .lia_z=1.12f, .temp=0.0f, .sys_cal=0, .gyro_cal=3, .accel_cal=3, .mag_cal=3, .haptic_fired=0, .deviation_score=0.0f, .haptic_reason=0, .pull_duration_ms=0.0f, .device_id=1, .device_role=0, .stroke_count=1, .breath_count=0, .entry_angle=0.0f },
    { .t_ms=18726, .ax=-1.63f, .ay=-0.08f, .az=10.79f, .gx=-0.195f, .gy=-0.108f, .gz=-0.293f, .mx=0.0f, .my=0.0f, .mz=0.0f, .roll=0.0f, .pitch=0.0f, .yaw=0.0f, .qw=0.9961f, .qx=0.0156f, .qy=0.0793f, .qz=0.0358f, .lia_x=-0.16f, .lia_y=-0.48f, .lia_z=0.69f, .temp=0.0f, .sys_cal=0, .gyro_cal=3, .accel_cal=3, .mag_cal=3, .haptic_fired=0, .deviation_score=0.0f, .haptic_reason=0, .pull_duration_ms=0.0f, .device_id=1, .device_role=0, .stroke_count=1, .breath_count=0, .entry_angle=0.0f },
    { .t_ms=18743, .ax=-1.52f, .ay=-0.11f, .az=10.18f, .gx=0.077f, .gy=-0.153f, .gz=-0.301f, .mx=0.0f, .my=0.0f, .mz=0.0f, .roll=0.0f, .pitch=0.0f, .yaw=0.0f, .qw=0.9963f, .qx=0.0172f, .qy=0.0778f, .qz=0.0327f, .lia_x=0.09f, .lia_y=-0.4f, .lia_z=0.37f, .temp=0.0f, .sys_cal=0, .gyro_cal=3, .accel_cal=3, .mag_cal=3, .haptic_fired=0, .deviation_score=0.0f, .haptic_reason=0, .pull_duration_ms=0.0f, .device_id=1, .device_role=0, .stroke_count=1, .breath_count=0, .entry_angle=0.0f },
    { .t_ms=18763, .ax=-1.25f, .ay=0.17f, .az=10.11f, .gx=0.442f, .gy=-0.195f, .gz=-0.343f, .mx=0.0f, .my=0.0f, .mz=0.0f, .roll=0.0f, .pitch=0.0f, .yaw=0.0f, .qw=0.9965f, .qx=0.0213f, .qy=0.0762f, .qz=0.0287f, .lia_x=0.51f, .lia_y=0.13f, .lia_z=0.42f, .temp=0.0f, .sys_cal=0, .gyro_cal=3, .accel_cal=3, .mag_cal=3, .haptic_fired=0, .deviation_score=0.0f, .haptic_reason=0, .pull_duration_ms=0.0f, .device_id=1, .device_role=0, .stroke_count=1, .breath_count=0, .entry_angle=0.0f },
    { .t_ms=18782, .ax=-0.95f, .ay=0.83f, .az=9.92f, .gx=0.344f, .gy=-0.164f, .gz=-0.472f, .mx=0.0f, .my=0.0f, .mz=0.0f, .roll=0.0f, .pitch=0.0f, .yaw=0.0f, .qw=0.9965f, .qx=0.0233f, .qy=0.0748f, .qz=0.0234f, .lia_x=0.56f, .lia_y=0.55f, .lia_z=0.24f, .temp=0.0f, .sys_cal=0, .gyro_cal=3, .accel_cal=3, .mag_cal=3, .haptic_fired=0, .deviation_score=0.0f, .haptic_reason=0, .pull_duration_ms=0.0f, .device_id=1, .device_role=0, .stroke_count=1, .breath_count=0, .entry_angle=0.0f },
    { .t_ms=18800, .ax=-0.88f, .ay=1.04f, .az=9.92f, .gx=0.152f, .gy=-0.157f, .gz=-0.683f, .mx=0.0f, .my=0.0f, .mz=0.0f, .roll=0.0f, .pitch=0.0f, .yaw=0.0f, .qw=0.9968f, .qx=0.0228f, .qy=0.0735f, .qz=0.0167f, .lia_x=0.61f, .lia_y=0.49f, .lia_z=0.04f, .temp=0.0f, .sys_cal=0, .gyro_cal=3, .accel_cal=3, .mag_cal=3, .haptic_fired=0, .deviation_score=0.0f, .haptic_reason=0, .pull_duration_ms=0.0f, .device_id=1, .device_role=0, .stroke_count=1, .breath_count=0, .entry_angle=0.0f },
    { .t_ms=18820, .ax=-0.81f, .ay=0.93f, .az=9.74f, .gx=-0.432f, .gy=-0.137f, .gz=-0.717f, .mx=0.0f, .my=0.0f, .mz=0.0f, .roll=0.0f, .pitch=0.0f, .yaw=0.0f, .qw=0.9971f, .qx=0.0188f, .qy=0.0728f, .qz=0.0104f, .lia_x=0.55f, .lia_y=0.2f, .lia_z=-0.12f, .temp=0.0f, .sys_cal=0, .gyro_cal=3, .accel_cal=3, .mag_cal=3, .haptic_fired=0, .deviation_score=0.0f, .haptic_reason=0, .pull_duration_ms=0.0f, .device_id=1, .device_role=0, .stroke_count=1, .breath_count=0, .entry_angle=0.0f },
    { .t_ms=18838, .ax=-0.85f, .ay=0.54f, .az=9.57f, .gx=-0.457f, .gy=-0.118f, .gz=-0.647f, .mx=0.0f, .my=0.0f, .mz=0.0f, .roll=0.0f, .pitch=0.0f, .yaw=0.0f, .qw=0.9973f, .qx=0.0145f, .qy=0.072f, .qz=0.0079f, .lia_x=0.74f, .lia_y=0.12f, .lia_z=-0.2f, .temp=0.0f, .sys_cal=0, .gyro_cal=3, .accel_cal=3, .mag_cal=3, .haptic_fired=0, .deviation_score=0.0f, .haptic_reason=0, .pull_duration_ms=0.0f, .device_id=1, .device_role=0, .stroke_count=1, .breath_count=0, .entry_angle=0.0f },
    { .t_ms=18856, .ax=-0.52f, .ay=0.39f, .az=9.5f, .gx=-0.145f, .gy=0.011f, .gz=-0.439f, .mx=0.0f, .my=0.0f, .mz=0.0f, .roll=0.0f, .pitch=0.0f, .yaw=0.0f, .qw=0.9973f, .qx=0.0135f, .qy=0.0726f, .qz=0.004f, .lia_x=1.2f, .lia_y=0.46f, .lia_z=0.0f, .temp=0.0f, .sys_cal=0, .gyro_cal=3, .accel_cal=3, .mag_cal=3, .haptic_fired=0, .deviation_score=0.0f, .haptic_reason=0, .pull_duration_ms=0.0f, .device_id=1, .device_role=0, .stroke_count=1, .breath_count=0, .entry_angle=0.0f },
    { .t_ms=18878, .ax=-0.23f, .ay=0.72f, .az=9.69f, .gx=0.037f, .gy=0.206f, .gz=-0.398f, .mx=0.0f, .my=0.0f, .mz=0.0f, .roll=0.0f, .pitch=0.0f, .yaw=0.0f, .qw=0.9971f, .qx=0.0134f, .qy=0.0748f, .qz=-0.0002f, .lia_x=1.25f, .lia_y=0.56f, .lia_z=0.18f, .temp=0.0f, .sys_cal=0, .gyro_cal=3, .accel_cal=3, .mag_cal=3, .haptic_fired=0, .deviation_score=0.0f, .haptic_reason=0, .pull_duration_ms=0.0f, .device_id=1, .device_role=0, .stroke_count=1, .breath_count=0, .entry_angle=0.0f },
    { .t_ms=18895, .ax=-0.19f, .ay=0.8f, .az=9.87f, .gx=-0.099f, .gy=0.221f, .gz=-0.542f, .mx=0.0f, .my=0.0f, .mz=0.0f, .roll=0.0f, .pitch=0.0f, .yaw=0.0f, .qw=0.9969f, .qx=0.0114f, .qy=0.0768f, .qz=-0.0057f, .lia_x=1.32f, .lia_y=0.46f, .lia_z=0.05f, .temp=0.0f, .sys_cal=0, .gyro_cal=3, .accel_cal=3, .mag_cal=3, .haptic_fired=0, .deviation_score=0.0f, .haptic_reason=0, .pull_duration_ms=0.0f, .device_id=1, .device_role=0, .stroke_count=1, .breath_count=0, .entry_angle=0.0f },
    { .t_ms=18915, .ax=-0.2f, .ay=0.47f, .az=9.5f, .gx=-0.3f, .gy=0.08f, .gz=-0.712f, .mx=0.0f, .my=0.0f, .mz=0.0f, .roll=0.0f, .pitch=0.0f, .yaw=0.0f, .qw=0.9969f, .qx=0.008f, .qy=0.0773f, .qz=-0.0126f, .lia_x=1.1f, .lia_y=0.07f, .lia_z=-0.01f, .temp=0.0f, .sys_cal=0, .gyro_cal=3, .accel_cal=3, .mag_cal=3, .haptic_fired=0, .deviation_score=0.0f, .haptic_reason=0, .pull_duration_ms=0.0f, .device_id=1, .device_role=0, .stroke_count=1, .breath_count=0, .entry_angle=0.0f },
    { .t_ms=18934, .ax=-0.44f, .ay=0.15f, .az=9.69f, .gx=-0.226f, .gy=0.028f, .gz=-0.764f, .mx=0.0f, .my=0.0f, .mz=0.0f, .roll=0.0f, .pitch=0.0f, .yaw=0.0f, .qw=0.9968f, .qx=0.0058f, .qy=0.078f, .qz=-0.0196f, .lia_x=0.84f, .lia_y=0.0f, .lia_z=0.18f, .temp=0.0f, .sys_cal=0, .gyro_cal=3, .accel_cal=3, .mag_cal=3, .haptic_fired=0, .deviation_score=0.0f, .haptic_reason=0, .pull_duration_ms=0.0f, .device_id=1, .device_role=0, .stroke_count=1, .breath_count=0, .entry_angle=0.0f },
    { .t_ms=18958, .ax=-0.69f, .ay=0.07f, .az=9.86f, .gx=0.01f, .gy=0.194f, .gz=-0.591f, .mx=0.0f, .my=0.0f, .mz=0.0f, .roll=0.0f, .pitch=0.0f, .yaw=0.0f, .qw=0.9965f, .qx=0.0059f, .qy=0.0808f, .qz=-0.0282f, .lia_x=0.85f, .lia_y=-0.13f, .lia_z=0.57f, .temp=0.0f, .sys_cal=0, .gyro_cal=3, .accel_cal=3, .mag_cal=3, .haptic_fired=0, .deviation_score=0.0f, .haptic_reason=0, .pull_duration_ms=0.0f, .device_id=1, .device_role=0, .stroke_count=1, .breath_count=0, .entry_angle=0.0f },
    { .t_ms=18979, .ax=-0.72f, .ay=-0.05f, .az=10.24f, .gx=0.146f, .gy=0.229f, .gz=-0.427f, .mx=0.0f, .my=0.0f, .mz=0.0f, .roll=0.0f, .pitch=0.0f, .yaw=0.0f, .qw=0.9962f, .qx=0.0069f, .qy=0.082f, .qz=-0.0303f, .lia_x=0.89f, .lia_y=-0.1f, .lia_z=1.13f, .temp=0.0f, .sys_cal=0, .gyro_cal=3, .accel_cal=3, .mag_cal=3, .haptic_fired=0, .deviation_score=0.0f, .haptic_reason=0, .pull_duration_ms=0.0f, .device_id=1, .device_role=0, .stroke_count=1, .breath_count=0, .entry_angle=0.0f },
    { .t_ms=18997, .ax=-0.57f, .ay=-0.01f, .az=10.8f, .gx=0.099f, .gy=0.287f, .gz=-0.397f, .mx=0.0f, .my=0.0f, .mz=0.0f, .roll=0.0f, .pitch=0.0f, .yaw=0.0f, .qw=0.9958f, .qx=0.0073f, .qy=0.0849f, .qz=-0.0341f, .lia_x=1.17f, .lia_y=-0.05f, .lia_z=0.78f, .temp=0.0f, .sys_cal=0, .gyro_cal=3, .accel_cal=3, .mag_cal=3, .haptic_fired=0, .deviation_score=0.0f, .haptic_reason=0, .pull_duration_ms=0.0f, .device_id=1, .device_role=0, .stroke_count=1, .breath_count=0, .entry_angle=0.0f },
    { .t_ms=19016, .ax=-0.44f, .ay=0.02f, .az=10.44f, .gx=-0.031f, .gy=0.24f, .gz=-0.379f, .mx=0.0f, .my=0.0f, .mz=0.0f, .roll=0.0f, .pitch=0.0f, .yaw=0.0f, .qw=0.9955f, .qx=0.0066f, .qy=0.0867f, .qz=-0.0377f, .lia_x=1.26f, .lia_y=-0.11f, .lia_z=0.63f, .temp=0.0f, .sys_cal=0, .gyro_cal=3, .accel_cal=3, .mag_cal=3, .haptic_fired=0, .deviation_score=0.0f, .haptic_reason=0, .pull_duration_ms=0.0f, .device_id=1, .device_role=0, .stroke_count=1, .breath_count=0, .entry_angle=0.0f },
    { .t_ms=19039, .ax=-0.6f, .ay=-0.32f, .az=10.29f, .gx=-0.067f, .gy=0.007f, .gz=-0.403f, .mx=0.0f, .my=0.0f, .mz=0.0f, .roll=0.0f, .pitch=0.0f, .yaw=0.0f, .qw=0.9954f, .qx=0.0058f, .qy=0.0866f, .qz=-0.0436f, .lia_x=0.99f, .lia_y=-0.52f, .lia_z=0.82f, .temp=0.0f, .sys_cal=0, .gyro_cal=3, .accel_cal=3, .mag_cal=3, .haptic_fired=0, .deviation_score=0.0f, .haptic_reason=0, .pull_duration_ms=0.0f, .device_id=1, .device_role=0, .stroke_count=1, .breath_count=0, .entry_angle=0.0f },
    { .t_ms=19068, .ax=-0.57f, .ay=-0.36f, .az=10.73f, .gx=0.05f, .gy=0.157f, .gz=-0.361f, .mx=0.0f, .my=0.0f, .mz=0.0f, .roll=0.0f, .pitch=0.0f, .yaw=0.0f, .qw=0.995f, .qx=0.0061f, .qy=0.088f, .qz=-0.0472f, .lia_x=1.11f, .lia_y=-0.02f, .lia_z=1.11f, .temp=0.0f, .sys_cal=0, .gyro_cal=3, .accel_cal=3, .mag_cal=3, .haptic_fired=0, .deviation_score=0.0f, .haptic_reason=0, .pull_duration_ms=0.0f, .device_id=1, .device_role=0, .stroke_count=1, .breath_count=0, .entry_angle=0.0f },
    { .t_ms=19087, .ax=-0.62f, .ay=0.01f, .az=10.76f, .gx=0.1f, .gy=0.153f, .gz=-0.376f, .mx=0.0f, .my=0.0f, .mz=0.0f, .roll=0.0f, .pitch=0.0f, .yaw=0.0f, .qw=0.9947f, .qx=0.0069f, .qy=0.089f, .qz=-0.0511f, .lia_x=1.15f, .lia_y=0.0f, .lia_z=1.1f, .temp=0.0f, .sys_cal=0, .gyro_cal=3, .accel_cal=3, .mag_cal=3, .haptic_fired=0, .deviation_score=0.0f, .haptic_reason=0, .pull_duration_ms=0.0f, .device_id=1, .device_role=0, .stroke_count=1, .breath_count=0, .entry_angle=0.0f },
    { .t_ms=19105, .ax=-0.88f, .ay=0.18f, .az=10.76f, .gx=0.12f, .gy=-0.043f, .gz=-0.445f, .mx=0.0f, .my=0.0f, .mz=0.0f, .roll=0.0f, .pitch=0.0f, .yaw=0.0f, .qw=0.9945f, .qx=0.0076f, .qy=0.088f, .qz=-0.0557f, .lia_x=0.81f, .lia_y=0.16f, .lia_z=1.35f, .temp=0.0f, .sys_cal=0, .gyro_cal=3, .accel_cal=3, .mag_cal=3, .haptic_fired=0, .deviation_score=0.0f, .haptic_reason=0, .pull_duration_ms=0.0f, .device_id=1, .device_role=0, .stroke_count=1, .breath_count=0, .entry_angle=0.0f },
    { .t_ms=19126, .ax=-1.03f, .ay=0.1f, .az=11.0f, .gx=0.109f, .gy=-0.231f, .gz=-0.5f, .mx=0.0f, .my=0.0f, .mz=0.0f, .roll=0.0f, .pitch=0.0f, .yaw=0.0f, .qw=0.9945f, .qx=0.0078f, .qy=0.0855f, .qz=-0.0604f, .lia_x=0.53f, .lia_y=-0.1f, .lia_z=1.39f, .temp=0.0f, .sys_cal=0, .gyro_cal=3, .accel_cal=3, .mag_cal=3, .haptic_fired=0, .deviation_score=0.0f, .haptic_reason=0, .pull_duration_ms=0.0f, .device_id=1, .device_role=0, .stroke_count=1, .breath_count=0, .entry_angle=0.0f },
    { .t_ms=19143, .ax=-1.14f, .ay=-0.1f, .az=10.96f, .gx=-0.067f, .gy=-0.334f, .gz=-0.384f, .mx=0.0f, .my=0.0f, .mz=0.0f, .roll=0.0f, .pitch=0.0f, .yaw=0.0f, .qw=0.9946f, .qx=0.0061f, .qy=0.0822f, .qz=-0.0637f, .lia_x=0.77f, .lia_y=-0.04f, .lia_z=1.27f, .temp=0.0f, .sys_cal=0, .gyro_cal=3, .accel_cal=3, .mag_cal=3, .haptic_fired=0, .deviation_score=0.0f, .haptic_reason=0, .pull_duration_ms=0.0f, .device_id=1, .device_role=0, .stroke_count=1, .breath_count=0, .entry_angle=0.0f },
    { .t_ms=19162, .ax=-0.83f, .ay=0.03f, .az=10.96f, .gx=-0.289f, .gy=-0.446f, .gz=-0.281f, .mx=0.0f, .my=0.0f, .mz=0.0f, .roll=0.0f, .pitch=0.0f, .yaw=0.0f, .qw=0.9949f, .qx=0.0023f, .qy=0.0768f, .qz=-0.0662f, .lia_x=0.91f, .lia_y=-0.07f, .lia_z=0.94f, .temp=0.0f, .sys_cal=0, .gyro_cal=3, .accel_cal=3, .mag_cal=3, .haptic_fired=0, .deviation_score=0.0f, .haptic_reason=0, .pull_duration_ms=0.0f, .device_id=1, .device_role=0, .stroke_count=1, .breath_count=0, .entry_angle=0.0f },
    { .t_ms=19181, .ax=-0.58f, .ay=-0.12f, .az=10.64f, .gx=-0.394f, .gy=-0.584f, .gz=-0.272f, .mx=0.0f, .my=0.0f, .mz=0.0f, .roll=0.0f, .pitch=0.0f, .yaw=0.0f, .qw=0.995f, .qx=0.0001f, .qy=0.0742f, .qz=-0.0685f, .lia_x=0.53f, .lia_y=-0.26f, .lia_z=0.81f, .temp=0.0f, .sys_cal=0, .gyro_cal=3, .accel_cal=3, .mag_cal=3, .haptic_fired=0, .deviation_score=0.0f, .haptic_reason=0, .pull_duration_ms=0.0f, .device_id=1, .device_role=0, .stroke_count=1, .breath_count=0, .entry_angle=0.0f },
    { .t_ms=19198, .ax=-0.84f, .ay=-0.4f, .az=10.52f, .gx=-0.388f, .gy=-0.651f, .gz=-0.286f, .mx=0.0f, .my=0.0f, .mz=0.0f, .roll=0.0f, .pitch=0.0f, .yaw=0.0f, .qw=0.9952f, .qx=-0.0043f, .qy=0.0679f, .qz=-0.0699f, .lia_x=0.5f, .lia_y=-0.57f, .lia_z=0.59f, .temp=0.0f, .sys_cal=0, .gyro_cal=3, .accel_cal=3, .mag_cal=3, .haptic_fired=0, .deviation_score=0.0f, .haptic_reason=0, .pull_duration_ms=0.0f, .device_id=1, .device_role=0, .stroke_count=1, .breath_count=0, .entry_angle=0.0f },
    { .t_ms=19218, .ax=-0.74f, .ay=-0.79f, .az=10.31f, .gx=-0.471f, .gy=-0.758f, .gz=-0.322f, .mx=0.0f, .my=0.0f, .mz=0.0f, .roll=0.0f, .pitch=0.0f, .yaw=0.0f, .qw=0.9955f, .qx=-0.0105f, .qy=0.0606f, .qz=-0.0725f, .lia_x=0.5f, .lia_y=-0.37f, .lia_z=0.8f, .temp=0.0f, .sys_cal=0, .gyro_cal=3, .accel_cal=3, .mag_cal=3, .haptic_fired=0, .deviation_score=0.0f, .haptic_reason=0, .pull_duration_ms=0.0f, .device_id=1, .device_role=0, .stroke_count=1, .breath_count=0, .entry_angle=0.0f },
    { .t_ms=19237, .ax=-0.58f, .ay=-0.76f, .az=10.54f, .gx=-0.973f, .gy=-0.864f, .gz=-0.361f, .mx=0.0f, .my=0.0f, .mz=0.0f, .roll=0.0f, .pitch=0.0f, .yaw=0.0f, .qw=0.9955f, .qx=-0.0226f, .qy=0.0532f, .qz=-0.0754f, .lia_x=0.49f, .lia_y=-0.33f, .lia_z=0.96f, .temp=0.0f, .sys_cal=0, .gyro_cal=3, .accel_cal=3, .mag_cal=3, .haptic_fired=0, .deviation_score=0.0f, .haptic_reason=0, .pull_duration_ms=0.0f, .device_id=1, .device_role=0, .stroke_count=1, .breath_count=0, .entry_angle=0.0f },
    { .t_ms=19255, .ax=-0.46f, .ay=-1.51f, .az=10.48f, .gx=-1.68f, .gy=-0.852f, .gz=-0.436f, .mx=0.0f, .my=0.0f, .mz=0.0f, .roll=0.0f, .pitch=0.0f, .yaw=0.0f, .qw=0.9951f, .qx=-0.0403f, .qy=0.0458f, .qz=-0.0786f, .lia_x=0.37f, .lia_y=-1.02f, .lia_z=0.87f, .temp=0.0f, .sys_cal=0, .gyro_cal=3, .accel_cal=3, .mag_cal=3, .haptic_fired=0, .deviation_score=0.0f, .haptic_reason=0, .pull_duration_ms=0.0f, .device_id=1, .device_role=0, .stroke_count=1, .breath_count=0, .entry_angle=0.0f },
    { .t_ms=19276, .ax=-0.4f, .ay=-2.2f, .az=10.59f, .gx=-1.752f, .gy=-0.981f, .gz=-0.408f, .mx=0.0f, .my=0.0f, .mz=0.0f, .roll=0.0f, .pitch=0.0f, .yaw=0.0f, .qw=0.9944f, .qx=-0.0571f, .qy=0.0374f, .qz=-0.081f, .lia_x=0.41f, .lia_y=-1.12f, .lia_z=1.07f, .temp=0.0f, .sys_cal=0, .gyro_cal=3, .accel_cal=3, .mag_cal=3, .haptic_fired=0, .deviation_score=0.0f, .haptic_reason=0, .pull_duration_ms=0.0f, .device_id=1, .device_role=0, .stroke_count=1, .breath_count=0, .entry_angle=0.0f },
    { .t_ms=19293, .ax=-0.14f, .ay=-2.16f, .az=10.83f, .gx=-1.265f, .gy=-0.934f, .gz=-0.271f, .mx=0.0f, .my=0.0f, .mz=0.0f, .roll=0.0f, .pitch=0.0f, .yaw=0.0f, .qw=0.9938f, .qx=-0.0687f, .qy=0.0296f, .qz=-0.0826f, .lia_x=0.53f, .lia_y=-0.63f, .lia_z=1.14f, .temp=0.0f, .sys_cal=0, .gyro_cal=3, .accel_cal=3, .mag_cal=3, .haptic_fired=0, .deviation_score=0.0f, .haptic_reason=0, .pull_duration_ms=0.0f, .device_id=1, .device_role=0, .stroke_count=1, .breath_count=0, .entry_angle=0.0f },
    { .t_ms=19313, .ax=0.07f, .ay=-1.81f, .az=10.81f, .gx=-0.712f, .gy=-0.725f, .gz=-0.268f, .mx=0.0f, .my=0.0f, .mz=0.0f, .roll=0.0f, .pitch=0.0f, .yaw=0.0f, .qw=0.9933f, .qx=-0.0754f, .qy=0.0233f, .qz=-0.0847f, .lia_x=0.66f, .lia_y=-0.14f, .lia_z=1.17f, .temp=0.0f, .sys_cal=0, .gyro_cal=3, .accel_cal=3, .mag_cal=3, .haptic_fired=0, .deviation_score=0.0f, .haptic_reason=0, .pull_duration_ms=0.0f, .device_id=1, .device_role=0, .stroke_count=1, .breath_count=0, .entry_angle=0.0f },
    { .t_ms=19332, .ax=0.33f, .ay=-1.65f, .az=10.79f, .gx=-0.54f, .gy=-0.632f, .gz=-0.31f, .mx=0.0f, .my=0.0f, .mz=0.0f, .roll=0.0f, .pitch=0.0f, .yaw=0.0f, .qw=0.993f, .qx=-0.0815f, .qy=0.0173f, .qz=-0.087f, .lia_x=0.67f, .lia_y=0.09f, .lia_z=1.2f, .temp=0.0f, .sys_cal=0, .gyro_cal=3, .accel_cal=3, .mag_cal=3, .haptic_fired=0, .deviation_score=0.0f, .haptic_reason=0, .pull_duration_ms=0.0f, .device_id=1, .device_role=0, .stroke_count=1, .breath_count=0, .entry_angle=0.0f },
    { .t_ms=19350, .ax=0.47f, .ay=-1.52f, .az=10.87f, .gx=-0.619f, .gy=-0.761f, .gz=-0.291f, .mx=0.0f, .my=0.0f, .mz=0.0f, .roll=0.0f, .pitch=0.0f, .yaw=0.0f, .qw=0.9924f, .qx=-0.0856f, .qy=0.0098f, .qz=-0.0891f, .lia_x=1.0f, .lia_y=0.13f, .lia_z=0.65f, .temp=0.0f, .sys_cal=0, .gyro_cal=3, .accel_cal=3, .mag_cal=3, .haptic_fired=0, .deviation_score=0.0f, .haptic_reason=0, .pull_duration_ms=0.0f, .device_id=1, .device_role=0, .stroke_count=1, .breath_count=0, .entry_angle=0.0f },
    { .t_ms=19370, .ax=0.97f, .ay=-1.63f, .az=10.3f, .gx=-0.918f, .gy=-1.048f, .gz=-0.37f, .mx=0.0f, .my=0.0f, .mz=0.0f, .roll=0.0f, .pitch=0.0f, .yaw=0.0f, .qw=0.9913f, .qx=-0.095f, .qy=-0.0003f, .qz=-0.0919f, .lia_x=0.87f, .lia_y=0.05f, .lia_z=1.02f, .temp=0.0f, .sys_cal=0, .gyro_cal=3, .accel_cal=3, .mag_cal=3, .haptic_fired=0, .deviation_score=0.0f, .haptic_reason=0, .pull_duration_ms=0.0f, .device_id=1, .device_role=0, .stroke_count=1, .breath_count=0, .entry_angle=0.0f },
    { .t_ms=19389, .ax=1.05f, .ay=-1.88f, .az=10.63f, .gx=-0.926f, .gy=-1.146f, .gz=-0.461f, .mx=0.0f, .my=0.0f, .mz=0.0f, .roll=0.0f, .pitch=0.0f, .yaw=0.0f, .qw=0.9901f, .qx=-0.1048f, .qy=-0.0057f, .qz=-0.0936f, .lia_x=0.87f, .lia_y=-0.14f, .lia_z=1.02f, .temp=0.0f, .sys_cal=0, .gyro_cal=3, .accel_cal=3, .mag_cal=3, .haptic_fired=0, .deviation_score=0.0f, .haptic_reason=0, .pull_duration_ms=0.0f, .device_id=1, .device_role=0, .stroke_count=1, .breath_count=0, .entry_angle=0.0f },
    { .t_ms=19407, .ax=1.28f, .ay=-2.25f, .az=10.59f, .gx=-0.884f, .gy=-1.13f, .gz=-0.467f, .mx=0.0f, .my=0.0f, .mz=0.0f, .roll=0.0f, .pitch=0.0f, .yaw=0.0f, .qw=0.9886f, .qx=-0.1139f, .qy=-0.0161f, .qz=-0.097f, .lia_x=0.87f, .lia_y=-0.29f, .lia_z=1.1f, .temp=0.0f, .sys_cal=0, .gyro_cal=3, .accel_cal=3, .mag_cal=3, .haptic_fired=0, .deviation_score=0.0f, .haptic_reason=0, .pull_duration_ms=0.0f, .device_id=1, .device_role=0, .stroke_count=1, .breath_count=0, .entry_angle=0.0f },
    { .t_ms=19428, .ax=1.5f, .ay=-2.53f, .az=10.63f, .gx=-0.713f, .gy=-1.074f, .gz=-0.491f, .mx=0.0f, .my=0.0f, .mz=0.0f, .roll=0.0f, .pitch=0.0f, .yaw=0.0f, .qw=0.9871f, .qx=-0.1216f, .qy=-0.0264f, .qz=-0.1005f, .lia_x=1.19f, .lia_y=-0.46f, .lia_z=1.21f, .temp=0.0f, .sys_cal=0, .gyro_cal=3, .accel_cal=3, .mag_cal=3, .haptic_fired=0, .deviation_score=0.0f, .haptic_reason=0, .pull_duration_ms=0.0f, .device_id=1, .device_role=0, .stroke_count=1, .breath_count=0, .entry_angle=0.0f },
    { .t_ms=19446, .ax=2.24f, .ay=-2.78f, .az=10.42f, .gx=-0.794f, .gy=-1.192f, .gz=-0.423f, .mx=0.0f, .my=0.0f, .mz=0.0f, .roll=0.0f, .pitch=0.0f, .yaw=0.0f, .qw=0.9853f, .qx=-0.1307f, .qy=-0.038f, .qz=-0.1031f, .lia_x=1.45f, .lia_y=-0.07f, .lia_z=0.78f, .temp=0.0f, .sys_cal=0, .gyro_cal=3, .accel_cal=3, .mag_cal=3, .haptic_fired=0, .deviation_score=0.0f, .haptic_reason=0, .pull_duration_ms=0.0f, .device_id=1, .device_role=0, .stroke_count=1, .breath_count=0, .entry_angle=0.0f },
    { .t_ms=19466, .ax=2.7f, .ay=-2.41f, .az=10.02f, .gx=-0.901f, .gy=-1.405f, .gz=-0.451f, .mx=0.0f, .my=0.0f, .mz=0.0f, .roll=0.0f, .pitch=0.0f, .yaw=0.0f, .qw=0.983f, .qx=-0.1401f, .qy=-0.0513f, .qz=-0.1065f, .lia_x=1.52f, .lia_y=0.44f, .lia_z=-0.16f, .temp=0.0f, .sys_cal=0, .gyro_cal=3, .accel_cal=3, .mag_cal=3, .haptic_fired=0, .deviation_score=0.0f, .haptic_reason=0, .pull_duration_ms=0.0f, .device_id=1, .device_role=0, .stroke_count=1, .breath_count=0, .entry_angle=0.0f },
    { .t_ms=19485, .ax=2.7f, .ay=-2.03f, .az=9.09f, .gx=-0.697f, .gy=-1.478f, .gz=-0.696f, .mx=0.0f, .my=0.0f, .mz=0.0f, .roll=0.0f, .pitch=0.0f, .yaw=0.0f, .qw=0.9805f, .qx=-0.1476f, .qy=-0.0658f, .qz=-0.1118f, .lia_x=1.08f, .lia_y=0.67f, .lia_z=-0.26f, .temp=0.0f, .sys_cal=0, .gyro_cal=3, .accel_cal=3, .mag_cal=3, .haptic_fired=0, .deviation_score=0.0f, .haptic_reason=0, .pull_duration_ms=0.0f, .device_id=1, .device_role=0, .stroke_count=1, .breath_count=0, .entry_angle=0.0f },
    { .t_ms=19503, .ax=2.67f, .ay=-2.1f, .az=8.64f, .gx=-0.629f, .gy=-1.439f, .gz=-0.781f, .mx=0.0f, .my=0.0f, .mz=0.0f, .roll=0.0f, .pitch=0.0f, .yaw=0.0f, .qw=0.9777f, .qx=-0.1548f, .qy=-0.0793f, .qz=-0.1174f, .lia_x=0.75f, .lia_y=0.84f, .lia_z=-0.84f, .temp=0.0f, .sys_cal=0, .gyro_cal=3, .accel_cal=3, .mag_cal=3, .haptic_fired=0, .deviation_score=0.0f, .haptic_reason=0, .pull_duration_ms=0.0f, .device_id=1, .device_role=0, .stroke_count=1, .breath_count=0, .entry_angle=0.0f },
    { .t_ms=19525, .ax=2.78f, .ay=-1.74f, .az=8.11f, .gx=-0.761f, .gy=-1.238f, .gz=-0.611f, .mx=0.0f, .my=0.0f, .mz=0.0f, .roll=0.0f, .pitch=0.0f, .yaw=0.0f, .qw=0.9749f, .qx=-0.1637f, .qy=-0.0906f, .qz=-0.1213f, .lia_x=0.72f, .lia_y=1.24f, .lia_z=-1.0f, .temp=0.0f, .sys_cal=0, .gyro_cal=3, .accel_cal=3, .mag_cal=3, .haptic_fired=0, .deviation_score=0.0f, .haptic_reason=0, .pull_duration_ms=0.0f, .device_id=1, .device_role=0, .stroke_count=1, .breath_count=0, .entry_angle=0.0f },
    { .t_ms=19542, .ax=2.84f, .ay=-1.66f, .az=8.11f, .gx=-1.205f, .gy=-1.182f, .gz=-0.297f, .mx=0.0f, .my=0.0f, .mz=0.0f, .roll=0.0f, .pitch=0.0f, .yaw=0.0f, .qw=0.9731f, .qx=-0.1699f, .qy=-0.1004f, .qz=-0.1224f, .lia_x=1.24f, .lia_y=0.98f, .lia_z=-0.28f, .temp=0.0f, .sys_cal=0, .gyro_cal=3, .accel_cal=3, .mag_cal=3, .haptic_fired=0, .deviation_score=0.0f, .haptic_reason=0, .pull_duration_ms=0.0f, .device_id=1, .device_role=0, .stroke_count=1, .breath_count=0, .entry_angle=0.0f },
    { .t_ms=19566, .ax=3.64f, .ay=-2.2f, .az=8.5f, .gx=-2.235f, .gy=-1.221f, .gz=0.154f, .mx=0.0f, .my=0.0f, .mz=0.0f, .roll=0.0f, .pitch=0.0f, .yaw=0.0f, .qw=0.9656f, .qx=-0.2034f, .qy=-0.1086f, .qz=-0.1205f, .lia_x=1.36f, .lia_y=1.06f, .lia_z=-0.36f, .temp=0.0f, .sys_cal=0, .gyro_cal=3, .accel_cal=3, .mag_cal=3, .haptic_fired=0, .deviation_score=0.0f, .haptic_reason=0, .pull_duration_ms=0.0f, .device_id=1, .device_role=0, .stroke_count=1, .breath_count=0, .entry_angle=0.0f },
    { .t_ms=19586, .ax=4.16f, .ay=-3.24f, .az=8.03f, .gx=-2.999f, .gy=-1.216f, .gz=0.394f, .mx=0.0f, .my=0.0f, .mz=0.0f, .roll=0.0f, .pitch=0.0f, .yaw=0.0f, .qw=0.9584f, .qx=-0.233f, .qy=-0.1153f, .qz=-0.1174f, .lia_x=1.48f, .lia_y=0.36f, .lia_z=-0.44f, .temp=0.0f, .sys_cal=0, .gyro_cal=3, .accel_cal=3, .mag_cal=3, .haptic_fired=0, .deviation_score=0.0f, .haptic_reason=0, .pull_duration_ms=0.0f, .device_id=1, .device_role=0, .stroke_count=1, .breath_count=0, .entry_angle=0.0f },
    { .t_ms=19603, .ax=4.18f, .ay=-4.21f, .az=7.84f, .gx=-2.644f, .gy=-1.037f, .gz=0.455f, .mx=0.0f, .my=0.0f, .mz=0.0f, .roll=0.0f, .pitch=0.0f, .yaw=0.0f, .qw=0.9521f, .qx=-0.257f, .qy=-0.1208f, .qz=-0.1133f, .lia_x=1.3f, .lia_y=0.04f, .lia_z=-0.06f, .temp=0.0f, .sys_cal=0, .gyro_cal=3, .accel_cal=3, .mag_cal=3, .haptic_fired=0, .deviation_score=0.0f, .haptic_reason=0, .pull_duration_ms=0.0f, .device_id=1, .device_role=0, .stroke_count=1, .breath_count=0, .entry_angle=0.0f },
    { .t_ms=19625, .ax=4.27f, .ay=-4.69f, .az=8.3f, .gx=-1.748f, .gy=-0.985f, .gz=0.548f, .mx=0.0f, .my=0.0f, .mz=0.0f, .roll=0.0f, .pitch=0.0f, .yaw=0.0f, .qw=0.9474f, .qx=-0.2734f, .qy=-0.1266f, .qz=-0.1074f, .lia_x=1.42f, .lia_y=-0.13f, .lia_z=0.04f, .temp=0.0f, .sys_cal=0, .gyro_cal=3, .accel_cal=3, .mag_cal=3, .haptic_fired=0, .deviation_score=0.0f, .haptic_reason=0, .pull_duration_ms=0.0f, .device_id=1, .device_role=0, .stroke_count=1, .breath_count=0, .entry_angle=0.0f },
    { .t_ms=19642, .ax=4.35f, .ay=-4.94f, .az=7.62f, .gx=-1.229f, .gy=-1.013f, .gz=0.734f, .mx=0.0f, .my=0.0f, .mz=0.0f, .roll=0.0f, .pitch=0.0f, .yaw=0.0f, .qw=0.944f, .qx=-0.2855f, .qy=-0.1329f, .qz=-0.0989f, .lia_x=1.73f, .lia_y=-0.41f, .lia_z=-0.54f, .temp=0.0f, .sys_cal=0, .gyro_cal=3, .accel_cal=3, .mag_cal=3, .haptic_fired=0, .deviation_score=0.0f, .haptic_reason=0, .pull_duration_ms=0.0f, .device_id=1, .device_role=0, .stroke_count=1, .breath_count=0, .entry_angle=0.0f },
    { .t_ms=19666, .ax=4.85f, .ay=-5.26f, .az=7.42f, .gx=-0.692f, .gy=-1.07f, .gz=0.822f, .mx=0.0f, .my=0.0f, .mz=0.0f, .roll=0.0f, .pitch=0.0f, .yaw=0.0f, .qw=0.9415f, .qx=-0.2932f, .qy=-0.14f, .qz=-0.0894f, .lia_x=1.62f, .lia_y=0.11f, .lia_z=-0.17f, .temp=0.0f, .sys_cal=0, .gyro_cal=3, .accel_cal=3, .mag_cal=3, .haptic_fired=0, .deviation_score=0.0f, .haptic_reason=0, .pull_duration_ms=0.0f, .device_id=1, .device_role=0, .stroke_count=1, .breath_count=0, .entry_angle=0.0f },
    { .t_ms=19686, .ax=4.56f, .ay=-5.16f, .az=7.55f, .gx=-0.574f, .gy=-1.142f, .gz=0.645f, .mx=0.0f, .my=0.0f, .mz=0.0f, .roll=0.0f, .pitch=0.0f, .yaw=0.0f, .qw=0.9386f, .qx=-0.3004f, .qy=-0.1488f, .qz=-0.0815f, .lia_x=1.04f, .lia_y=-0.09f, .lia_z=-0.45f, .temp=0.0f, .sys_cal=0, .gyro_cal=3, .accel_cal=3, .mag_cal=3, .haptic_fired=0, .deviation_score=0.0f, .haptic_reason=0, .pull_duration_ms=0.0f, .device_id=1, .device_role=0, .stroke_count=1, .breath_count=0, .entry_angle=0.0f },
    { .t_ms=19703, .ax=4.26f, .ay=-5.27f, .az=6.99f, .gx=-0.577f, .gy=-1.418f, .gz=0.383f, .mx=0.0f, .my=0.0f, .mz=0.0f, .roll=0.0f, .pitch=0.0f, .yaw=0.0f, .qw=0.9351f, .qx=-0.3067f, .qy=-0.1609f, .qz=-0.0748f, .lia_x=0.7f, .lia_y=-0.11f, .lia_z=-0.56f, .temp=0.0f, .sys_cal=0, .gyro_cal=3, .accel_cal=3, .mag_cal=3, .haptic_fired=0, .deviation_score=0.0f, .haptic_reason=0, .pull_duration_ms=0.0f, .device_id=1, .device_role=0, .stroke_count=1, .breath_count=0, .entry_angle=0.0f },
    { .t_ms=19724, .ax=4.1f, .ay=-5.8f, .az=7.06f, .gx=-0.268f, .gy=-1.732f, .gz=0.322f, .mx=0.0f, .my=0.0f, .mz=0.0f, .roll=0.0f, .pitch=0.0f, .yaw=0.0f, .qw=0.932f, .qx=-0.3099f, .qy=-0.1757f, .qz=-0.0666f, .lia_x=0.62f, .lia_y=-0.36f, .lia_z=-0.13f, .temp=0.0f, .sys_cal=0, .gyro_cal=3, .accel_cal=3, .mag_cal=3, .haptic_fired=0, .deviation_score=0.0f, .haptic_reason=0, .pull_duration_ms=0.0f, .device_id=1, .device_role=0, .stroke_count=1, .breath_count=0, .entry_angle=0.0f },
    { .t_ms=19741, .ax=4.23f, .ay=-5.8f, .az=7.17f, .gx=-0.057f, .gy=-1.714f, .gz=0.472f, .mx=0.0f, .my=0.0f, .mz=0.0f, .roll=0.0f, .pitch=0.0f, .yaw=0.0f, .qw=0.9308f, .qx=-0.3103f, .qy=-0.1827f, .qz=-0.0564f, .lia_x=0.94f, .lia_y=-0.36f, .lia_z=-0.69f, .temp=0.0f, .sys_cal=0, .gyro_cal=3, .accel_cal=3, .mag_cal=3, .haptic_fired=0, .deviation_score=0.0f, .haptic_reason=0, .pull_duration_ms=0.0f, .device_id=1, .device_role=0, .stroke_count=1, .breath_count=0, .entry_angle=0.0f },
    { .t_ms=19759, .ax=4.74f, .ay=-5.8f, .az=6.52f, .gx=0.289f, .gy=-1.726f, .gz=0.668f, .mx=0.0f, .my=0.0f, .mz=0.0f, .roll=0.0f, .pitch=0.0f, .yaw=0.0f, .qw=0.9291f, .qx=-0.3091f, .qy=-0.2033f, .qz=-0.0441f, .lia_x=2.4f, .lia_y=0.24f, .lia_z=-1.31f, .temp=0.0f, .sys_cal=0, .gyro_cal=3, .accel_cal=3, .mag_cal=3, .haptic_fired=0, .deviation_score=0.0f, .haptic_reason=0, .pull_duration_ms=0.0f, .device_id=1, .device_role=0, .stroke_count=1, .breath_count=0, .entry_angle=0.0f },
    { .t_ms=19780, .ax=6.37f, .ay=-5.18f, .az=5.82f, .gx=0.5f, .gy=-1.761f, .gz=0.719f, .mx=0.0f, .my=0.0f, .mz=0.0f, .roll=0.0f, .pitch=0.0f, .yaw=0.0f, .qw=0.9276f, .qx=-0.3065f, .qy=-0.2104f, .qz=-0.0377f, .lia_x=2.15f, .lia_y=0.71f, .lia_z=-1.71f, .temp=0.0f, .sys_cal=0, .gyro_cal=3, .accel_cal=3, .mag_cal=3, .haptic_fired=0, .deviation_score=0.0f, .haptic_reason=0, .pull_duration_ms=0.0f, .device_id=1, .device_role=0, .stroke_count=1, .breath_count=0, .entry_angle=0.0f },
    { .t_ms=19797, .ax=6.19f, .ay=-4.44f, .az=5.33f, .gx=0.649f, .gy=-1.816f, .gz=0.483f, .mx=0.0f, .my=0.0f, .mz=0.0f, .roll=0.0f, .pitch=0.0f, .yaw=0.0f, .qw=0.9258f, .qx=-0.3016f, .qy=-0.2263f, .qz=-0.028f, .lia_x=1.67f, .lia_y=1.66f, .lia_z=-1.65f, .temp=0.0f, .sys_cal=0, .gyro_cal=3, .accel_cal=3, .mag_cal=3, .haptic_fired=0, .deviation_score=0.0f, .haptic_reason=0, .pull_duration_ms=0.0f, .device_id=1, .device_role=0, .stroke_count=1, .breath_count=0, .entry_angle=0.0f },
    { .t_ms=19817, .ax=5.91f, .ay=-3.6f, .az=5.31f, .gx=0.73f, .gy=-1.95f, .gz=-0.172f, .mx=0.0f, .my=0.0f, .mz=0.0f, .roll=0.0f, .pitch=0.0f, .yaw=0.0f, .qw=0.9233f, .qx=-0.2952f, .qy=-0.2449f, .qz=-0.0228f, .lia_x=1.07f, .lia_y=1.13f, .lia_z=-1.78f, .temp=0.0f, .sys_cal=0, .gyro_cal=3, .accel_cal=3, .mag_cal=3, .haptic_fired=0, .deviation_score=0.0f, .haptic_reason=0, .pull_duration_ms=0.0f, .device_id=1, .device_role=0, .stroke_count=1, .breath_count=0, .entry_angle=0.0f },
    { .t_ms=19836, .ax=5.81f, .ay=-4.66f, .az=4.85f, .gx=0.675f, .gy=-2.077f, .gz=-0.236f, .mx=0.0f, .my=0.0f, .mz=0.0f, .roll=0.0f, .pitch=0.0f, .yaw=0.0f, .qw=0.9201f, .qx=-0.2891f, .qy=-0.2637f, .qz=-0.0164f, .lia_x=1.51f, .lia_y=0.42f, .lia_z=-2.38f, .temp=0.0f, .sys_cal=0, .gyro_cal=3, .accel_cal=3, .mag_cal=3, .haptic_fired=0, .deviation_score=0.0f, .haptic_reason=0, .pull_duration_ms=0.0f, .device_id=1, .device_role=0, .stroke_count=1, .breath_count=0, .entry_angle=0.0f },
    { .t_ms=19853, .ax=6.36f, .ay=-4.53f, .az=3.82f, .gx=0.804f, .gy=-1.918f, .gz=0.272f, .mx=0.0f, .my=0.0f, .mz=0.0f, .roll=0.0f, .pitch=0.0f, .yaw=0.0f, .qw=0.9177f, .qx=-0.2827f, .qy=-0.279f, .qz=-0.0057f, .lia_x=2.59f, .lia_y=0.99f, .lia_z=-3.38f, .temp=0.0f, .sys_cal=0, .gyro_cal=3, .accel_cal=3, .mag_cal=3, .haptic_fired=0, .deviation_score=0.0f, .haptic_reason=0, .pull_duration_ms=0.0f, .device_id=1, .device_role=0, .stroke_count=1, .breath_count=0, .entry_angle=0.0f },
    { .t_ms=19875, .ax=8.3f, .ay=-3.45f, .az=2.25f, .gx=1.0f, .gy=-1.49f, .gz=0.485f, .mx=0.0f, .my=0.0f, .mz=0.0f, .roll=0.0f, .pitch=0.0f, .yaw=0.0f, .qw=0.9168f, .qx=-0.2745f, .qy=-0.2901f, .qz=0.0044f, .lia_x=3.24f, .lia_y=1.96f, .lia_z=-5.0f, .temp=0.0f, .sys_cal=0, .gyro_cal=3, .accel_cal=3, .mag_cal=3, .haptic_fired=0, .deviation_score=0.0f, .haptic_reason=0, .pull_duration_ms=0.0f, .device_id=1, .device_role=0, .stroke_count=1, .breath_count=0, .entry_angle=0.0f },
    { .t_ms=19892, .ax=8.43f, .ay=-2.99f, .az=1.67f, .gx=1.177f, .gy=-1.069f, .gz=0.017f, .mx=0.0f, .my=0.0f, .mz=0.0f, .roll=0.0f, .pitch=0.0f, .yaw=0.0f, .qw=0.9168f, .qx=-0.2692f, .qy=-0.2948f, .qz=0.0092f, .lia_x=2.39f, .lia_y=2.72f, .lia_z=-5.45f, .temp=0.0f, .sys_cal=0, .gyro_cal=3, .accel_cal=3, .mag_cal=3, .haptic_fired=0, .deviation_score=0.0f, .haptic_reason=0, .pull_duration_ms=0.0f, .device_id=1, .device_role=0, .stroke_count=1, .breath_count=0, .entry_angle=0.0f },
    { .t_ms=19910, .ax=7.73f, .ay=-2.07f, .az=1.22f, .gx=1.143f, .gy=-0.905f, .gz=-0.489f, .mx=0.0f, .my=0.0f, .mz=0.0f, .roll=0.0f, .pitch=0.0f, .yaw=0.0f, .qw=0.9167f, .qx=-0.2592f, .qy=-0.3084f, .qz=0.0084f, .lia_x=1.35f, .lia_y=3.4f, .lia_z=-3.44f, .temp=0.0f, .sys_cal=0, .gyro_cal=3, .accel_cal=3, .mag_cal=3, .haptic_fired=0, .deviation_score=0.0f, .haptic_reason=0, .pull_duration_ms=0.0f, .device_id=1, .device_role=0, .stroke_count=1, .breath_count=0, .entry_angle=0.0f },
    { .t_ms=19931, .ax=6.84f, .ay=-1.27f, .az=3.19f, .gx=0.214f, .gy=-0.846f, .gz=-0.403f, .mx=0.0f, .my=0.0f, .mz=0.0f, .roll=0.0f, .pitch=0.0f, .yaw=0.0f, .qw=0.9138f, .qx=-0.2601f, .qy=-0.312f, .qz=0.0063f, .lia_x=0.98f, .lia_y=3.1f, .lia_z=-2.77f, .temp=0.0f, .sys_cal=0, .gyro_cal=3, .accel_cal=3, .mag_cal=3, .haptic_fired=0, .deviation_score=0.0f, .haptic_reason=0, .pull_duration_ms=0.0f, .device_id=1, .device_role=0, .stroke_count=1, .breath_count=0, .entry_angle=0.0f },
    { .t_ms=19948, .ax=6.27f, .ay=-1.68f, .az=3.7f, .gx=-1.672f, .gy=-0.397f, .gz=-0.156f, .mx=0.0f, .my=0.0f, .mz=0.0f, .roll=0.0f, .pitch=0.0f, .yaw=0.0f, .qw=0.9084f, .qx=-0.2759f, .qy=-0.3141f, .qz=0.0013f, .lia_x=0.66f, .lia_y=2.06f, .lia_z=-2.79f, .temp=0.0f, .sys_cal=0, .gyro_cal=3, .accel_cal=3, .mag_cal=3, .haptic_fired=0, .deviation_score=0.0f, .haptic_reason=0, .pull_duration_ms=0.0f, .device_id=1, .device_role=0, .stroke_count=1, .breath_count=0, .entry_angle=0.0f },
    { .t_ms=19968, .ax=6.21f, .ay=-2.96f, .az=3.53f, .gx=-1.295f, .gy=0.26f, .gz=0.805f, .mx=0.0f, .my=0.0f, .mz=0.0f, .roll=0.0f, .pitch=0.0f, .yaw=0.0f, .qw=0.9076f, .qx=-0.2842f, .qy=-0.309f, .qz=0.0037f, .lia_x=0.72f, .lia_y=1.63f, .lia_z=-3.53f, .temp=0.0f, .sys_cal=0, .gyro_cal=3, .accel_cal=3, .mag_cal=3, .haptic_fired=0, .deviation_score=0.0f, .haptic_reason=0, .pull_duration_ms=0.0f, .device_id=1, .device_role=0, .stroke_count=1, .breath_count=0, .entry_angle=0.0f },
    { .t_ms=19988, .ax=6.39f, .ay=-3.43f, .az=2.9f, .gx=1.142f, .gy=0.642f, .gz=1.052f, .mx=0.0f, .my=0.0f, .mz=0.0f, .roll=0.0f, .pitch=0.0f, .yaw=0.0f, .qw=0.9142f, .qx=-0.2725f, .qy=-0.2995f, .qz=0.0164f, .lia_x=1.27f, .lia_y=1.73f, .lia_z=-3.67f, .temp=0.0f, .sys_cal=0, .gyro_cal=3, .accel_cal=3, .mag_cal=3, .haptic_fired=0, .deviation_score=0.0f, .haptic_reason=0, .pull_duration_ms=0.0f, .device_id=1, .device_role=0, .stroke_count=1, .breath_count=0, .entry_angle=0.0f },
    { .t_ms=20006, .ax=6.55f, .ay=-3.12f, .az=2.58f, .gx=2.87f, .gy=0.998f, .gz=1.073f, .mx=0.0f, .my=0.0f, .mz=0.0f, .roll=0.0f, .pitch=0.0f, .yaw=0.0f, .qw=0.9241f, .qx=-0.2501f, .qy=-0.2872f, .qz=0.0305f, .lia_x=1.36f, .lia_y=2.28f, .lia_z=-4.39f, .temp=0.0f, .sys_cal=0, .gyro_cal=3, .accel_cal=3, .mag_cal=3, .haptic_fired=0, .deviation_score=0.0f, .haptic_reason=0, .pull_duration_ms=0.0f, .device_id=1, .device_role=0, .stroke_count=1, .breath_count=0, .entry_angle=0.0f },
    { .t_ms=20041, .ax=5.76f, .ay=-1.81f, .az=3.44f, .gx=1.18f, .gy=0.707f, .gz=-0.337f, .mx=0.0f, .my=0.0f, .mz=0.0f, .roll=0.0f, .pitch=0.0f, .yaw=0.0f, .qw=0.9316f, .qx=-0.2354f, .qy=-0.2729f, .qz=0.0288f, .lia_x=-0.4f, .lia_y=1.2f, .lia_z=-4.44f, .temp=0.0f, .sys_cal=0, .gyro_cal=3, .accel_cal=3, .mag_cal=3, .haptic_fired=0, .deviation_score=0.0f, .haptic_reason=0, .pull_duration_ms=0.0f, .device_id=1, .device_role=0, .stroke_count=1, .breath_count=0, .entry_angle=0.0f },
    { .t_ms=20060, .ax=4.44f, .ay=-3.28f, .az=2.79f, .gx=-0.607f, .gy=0.596f, .gz=-0.968f, .mx=0.0f, .my=0.0f, .mz=0.0f, .roll=0.0f, .pitch=0.0f, .yaw=0.0f, .qw=0.9321f, .qx=-0.2382f, .qy=-0.27f, .qz=0.0176f, .lia_x=-1.11f, .lia_y=0.47f, .lia_z=-5.44f, .temp=0.0f, .sys_cal=0, .gyro_cal=3, .accel_cal=3, .mag_cal=3, .haptic_fired=0, .deviation_score=0.0f, .haptic_reason=0, .pull_duration_ms=0.0f, .device_id=1, .device_role=0, .stroke_count=1, .breath_count=0, .entry_angle=0.0f },
    { .t_ms=20081, .ax=3.74f, .ay=-3.97f, .az=1.82f, .gx=-0.129f, .gy=0.553f, .gz=-0.875f, .mx=0.0f, .my=0.0f, .mz=0.0f, .roll=0.0f, .pitch=0.0f, .yaw=0.0f, .qw=0.9341f, .qx=-0.2348f, .qy=-0.2684f, .qz=0.0137f, .lia_x=-1.39f, .lia_y=0.62f, .lia_z=-7.7f, .temp=0.0f, .sys_cal=0, .gyro_cal=3, .accel_cal=3, .mag_cal=3, .haptic_fired=0, .deviation_score=0.0f, .haptic_reason=0, .pull_duration_ms=0.0f, .device_id=1, .device_role=0, .stroke_count=1, .breath_count=0, .entry_angle=0.0f },
    { .t_ms=20098, .ax=3.45f, .ay=-3.63f, .az=-0.32f, .gx=1.045f, .gy=0.527f, .gz=-0.707f, .mx=0.0f, .my=0.0f, .mz=0.0f, .roll=0.0f, .pitch=0.0f, .yaw=0.0f, .qw=0.9383f, .qx=-0.2225f, .qy=-0.2645f, .qz=0.0095f, .lia_x=-1.61f, .lia_y=1.67f, .lia_z=-8.11f, .temp=0.0f, .sys_cal=0, .gyro_cal=3, .accel_cal=3, .mag_cal=3, .haptic_fired=0, .deviation_score=0.0f, .haptic_reason=0, .pull_duration_ms=0.0f, .device_id=1, .device_role=0, .stroke_count=1, .breath_count=0, .entry_angle=0.0f },
    { .t_ms=20118, .ax=2.96f, .ay=-2.35f, .az=-0.56f, .gx=1.182f, .gy=0.8f, .gz=-0.627f, .mx=0.0f, .my=0.0f, .mz=0.0f, .roll=0.0f, .pitch=0.0f, .yaw=0.0f, .qw=0.9428f, .qx=-0.2117f, .qy=-0.2574f, .qz=0.0038f, .lia_x=-3.09f, .lia_y=1.82f, .lia_z=-8.09f, .temp=0.0f, .sys_cal=0, .gyro_cal=3, .accel_cal=3, .mag_cal=3, .haptic_fired=0, .deviation_score=0.0f, .haptic_reason=0, .pull_duration_ms=0.0f, .device_id=1, .device_role=0, .stroke_count=1, .breath_count=0, .entry_angle=0.0f },
    { .t_ms=20137, .ax=0.8f, .ay=-1.86f, .az=-0.38f, .gx=0.465f, .gy=1.475f, .gz=-0.9f, .mx=0.0f, .my=0.0f, .mz=0.0f, .roll=0.0f, .pitch=0.0f, .yaw=0.0f, .qw=0.9478f, .qx=-0.2055f, .qy=-0.2436f, .qz=-0.0077f, .lia_x=-4.32f, .lia_y=2.27f, .lia_z=-8.1f, .temp=0.0f, .sys_cal=0, .gyro_cal=3, .accel_cal=3, .mag_cal=3, .haptic_fired=0, .deviation_score=0.0f, .haptic_reason=0, .pull_duration_ms=0.0f, .device_id=1, .device_role=0, .stroke_count=1, .breath_count=0, .entry_angle=0.0f },
    { .t_ms=20155, .ax=-0.76f, .ay=-1.29f, .az=-0.54f, .gx=0.547f, .gy=2.462f, .gz=-1.268f, .mx=0.0f, .my=0.0f, .mz=0.0f, .roll=0.0f, .pitch=0.0f, .yaw=0.0f, .qw=0.9549f, .qx=-0.1957f, .qy=-0.222f, .qz=-0.0233f, .lia_x=-7.98f, .lia_y=2.88f, .lia_z=-8.37f, .temp=0.0f, .sys_cal=0, .gyro_cal=3, .accel_cal=3, .mag_cal=3, .haptic_fired=0, .deviation_score=0.0f, .haptic_reason=0, .pull_duration_ms=0.0f, .device_id=1, .device_role=0, .stroke_count=1, .breath_count=0, .entry_angle=0.0f },
    { .t_ms=20175, .ax=-5.36f, .ay=-0.67f, .az=0.82f, .gx=1.201f, .gy=3.049f, .gz=-1.34f, .mx=0.0f, .my=0.0f, .mz=0.0f, .roll=0.0f, .pitch=0.0f, .yaw=0.0f, .qw=0.9634f, .qx=-0.1797f, .qy=-0.1951f, .qz=-0.0381f, .lia_x=-10.75f, .lia_y=2.24f, .lia_z=-4.41f, .temp=0.0f, .sys_cal=0, .gyro_cal=3, .accel_cal=3, .mag_cal=3, .haptic_fired=0, .deviation_score=0.0f, .haptic_reason=0, .pull_duration_ms=0.0f, .device_id=1, .device_role=0, .stroke_count=1, .breath_count=0, .entry_angle=0.0f },
    { .t_ms=20198, .ax=-8.21f, .ay=-1.31f, .az=4.19f, .gx=1.496f, .gy=3.775f, .gz=-0.821f, .mx=0.0f, .my=0.0f, .mz=0.0f, .roll=0.0f, .pitch=0.0f, .yaw=0.0f, .qw=0.9724f, .qx=-0.1642f, .qy=-0.1589f, .qz=-0.0481f, .lia_x=-13.0f, .lia_y=1.7f, .lia_z=0.15f, .temp=0.0f, .sys_cal=0, .gyro_cal=3, .accel_cal=3, .mag_cal=3, .haptic_fired=0, .deviation_score=0.0f, .haptic_reason=0, .pull_duration_ms=0.0f, .device_id=1, .device_role=0, .stroke_count=1, .breath_count=0, .entry_angle=0.0f },
    { .t_ms=20217, .ax=-10.13f, .ay=-1.39f, .az=9.08f, .gx=0.726f, .gy=4.704f, .gz=-0.104f, .mx=0.0f, .my=0.0f, .mz=0.0f, .roll=0.0f, .pitch=0.0f, .yaw=0.0f, .qw=0.9794f, .qx=-0.1569f, .qy=-0.1144f, .qz=-0.0557f, .lia_x=-12.93f, .lia_y=1.83f, .lia_z=5.08f, .temp=0.0f, .sys_cal=0, .gyro_cal=3, .accel_cal=3, .mag_cal=3, .haptic_fired=0, .deviation_score=0.0f, .haptic_reason=0, .pull_duration_ms=0.0f, .device_id=1, .device_role=0, .stroke_count=1, .breath_count=0, .entry_angle=0.0f },
    { .t_ms=20237, .ax=-12.39f, .ay=-0.25f, .az=14.25f, .gx=0.19f, .gy=4.513f, .gz=-0.412f, .mx=0.0f, .my=0.0f, .mz=0.0f, .roll=0.0f, .pitch=0.0f, .yaw=0.0f, .qw=0.9832f, .qx=-0.1519f, .qy=-0.075f, .qz=-0.0681f, .lia_x=-15.05f, .lia_y=2.34f, .lia_z=8.33f, .temp=0.0f, .sys_cal=0, .gyro_cal=3, .accel_cal=3, .mag_cal=3, .haptic_fired=0, .deviation_score=0.0f, .haptic_reason=0, .pull_duration_ms=0.0f, .device_id=1, .device_role=0, .stroke_count=2, .breath_count=0, .entry_angle=9.68f },
    { .t_ms=20256, .ax=-14.08f, .ay=-0.98f, .az=20.37f, .gx=-0.024f, .gy=3.622f, .gz=-1.201f, .mx=0.0f, .my=0.0f, .mz=0.0f, .roll=0.0f, .pitch=0.0f, .yaw=0.0f, .qw=0.9838f, .qx=-0.1522f, .qy=-0.0427f, .qz=-0.0847f, .lia_x=-13.64f, .lia_y=-1.05f, .lia_z=12.26f, .temp=0.0f, .sys_cal=0, .gyro_cal=3, .accel_cal=3, .mag_cal=3, .haptic_fired=0, .deviation_score=0.0f, .haptic_reason=0, .pull_duration_ms=0.0f, .device_id=1, .device_role=0, .stroke_count=2, .breath_count=0, .entry_angle=0.0f },
    { .t_ms=20281, .ax=-12.84f, .ay=-4.05f, .az=21.57f, .gx=-1.529f, .gy=3.235f, .gz=-0.713f, .mx=0.0f, .my=0.0f, .mz=0.0f, .roll=0.0f, .pitch=0.0f, .yaw=0.0f, .qw=0.9816f, .qx=-0.1662f, .qy=-0.0133f, .qz=-0.0931f, .lia_x=-10.8f, .lia_y=-2.13f, .lia_z=11.35f, .temp=0.0f, .sys_cal=0, .gyro_cal=3, .accel_cal=3, .mag_cal=3, .haptic_fired=0, .deviation_score=0.0f, .haptic_reason=0, .pull_duration_ms=0.0f, .device_id=1, .device_role=0, .stroke_count=2, .breath_count=0, .entry_angle=0.0f },
    { .t_ms=20299, .ax=-10.44f, .ay=-5.48f, .az=20.56f, .gx=-1.975f, .gy=2.016f, .gz=0.79f, .mx=0.0f, .my=0.0f, .mz=0.0f, .roll=0.0f, .pitch=0.0f, .yaw=0.0f, .qw=0.9797f, .qx=-0.1812f, .qy=0.0053f, .qz=-0.085f, .lia_x=-7.32f, .lia_y=-2.45f, .lia_z=7.62f, .temp=0.0f, .sys_cal=0, .gyro_cal=3, .accel_cal=3, .mag_cal=3, .haptic_fired=0, .deviation_score=0.0f, .haptic_reason=0, .pull_duration_ms=0.0f, .device_id=1, .device_role=0, .stroke_count=2, .breath_count=0, .entry_angle=0.0f },
    { .t_ms=20319, .ax=-7.22f, .ay=-6.0f, .az=16.76f, .gx=-0.601f, .gy=0.392f, .gz=2.202f, .mx=0.0f, .my=0.0f, .mz=0.0f, .roll=0.0f, .pitch=0.0f, .yaw=0.0f, .qw=0.9811f, .qx=-0.1817f, .qy=0.0104f, .qz=-0.0654f, .lia_x=-6.4f, .lia_y=-3.34f, .lia_z=4.49f, .temp=0.0f, .sys_cal=0, .gyro_cal=3, .accel_cal=3, .mag_cal=3, .haptic_fired=0, .deviation_score=0.0f, .haptic_reason=0, .pull_duration_ms=0.0f, .device_id=1, .device_role=0, .stroke_count=2, .breath_count=0, .entry_angle=0.0f },
    { .t_ms=20339, .ax=-5.44f, .ay=-6.73f, .az=13.7f, .gx=1.366f, .gy=-0.37f, .gz=2.285f, .mx=0.0f, .my=0.0f, .mz=0.0f, .roll=0.0f, .pitch=0.0f, .yaw=0.0f, .qw=0.9852f, .qx=-0.1658f, .qy=0.0094f, .qz=-0.0427f, .lia_x=-3.82f, .lia_y=-3.56f, .lia_z=2.79f, .temp=0.0f, .sys_cal=0, .gyro_cal=3, .accel_cal=3, .mag_cal=3, .haptic_fired=0, .deviation_score=0.0f, .haptic_reason=0, .pull_duration_ms=0.0f, .device_id=1, .device_role=0, .stroke_count=2, .breath_count=0, .entry_angle=0.0f },
    { .t_ms=20357, .ax=-2.9f, .ay=-6.68f, .az=11.59f, .gx=2.171f, .gy=-0.436f, .gz=2.364f, .mx=0.0f, .my=0.0f, .mz=0.0f, .roll=0.0f, .pitch=0.0f, .yaw=0.0f, .qw=0.9891f, .qx=-0.1456f, .qy=0.0094f, .qz=-0.0201f, .lia_x=-2.23f, .lia_y=-3.18f, .lia_z=1.53f, .temp=0.0f, .sys_cal=0, .gyro_cal=3, .accel_cal=3, .mag_cal=3, .haptic_fired=0, .deviation_score=0.0f, .haptic_reason=0, .pull_duration_ms=0.0f, .device_id=1, .device_role=0, .stroke_count=2, .breath_count=0, .entry_angle=0.0f },
    { .t_ms=20379, .ax=-1.85f, .ay=-5.85f, .az=10.96f, .gx=1.68f, .gy=0.19f, .gz=2.127f, .mx=0.0f, .my=0.0f, .mz=0.0f, .roll=0.0f, .pitch=0.0f, .yaw=0.0f, .qw=0.9911f, .qx=-0.1317f, .qy=0.0148f, .qz=-0.0018f, .lia_x=-1.08f, .lia_y=-2.61f, .lia_z=1.55f, .temp=0.0f, .sys_cal=0, .gyro_cal=3, .accel_cal=3, .mag_cal=3, .haptic_fired=0, .deviation_score=0.0f, .haptic_reason=0, .pull_duration_ms=0.0f, .device_id=1, .device_role=0, .stroke_count=2, .breath_count=0, .entry_angle=0.0f },
    { .t_ms=20396, .ax=-1.36f, .ay=-5.14f, .az=11.28f, .gx=0.614f, .gy=0.471f, .gz=1.482f, .mx=0.0f, .my=0.0f, .mz=0.0f, .roll=0.0f, .pitch=0.0f, .yaw=0.0f, .qw=0.9915f, .qx=-0.1277f, .qy=0.0211f, .qz=0.0103f, .lia_x=-0.97f, .lia_y=-2.66f, .lia_z=1.94f, .temp=0.0f, .sys_cal=0, .gyro_cal=3, .accel_cal=3, .mag_cal=3, .haptic_fired=0, .deviation_score=0.0f, .haptic_reason=0, .pull_duration_ms=0.0f, .device_id=1, .device_role=0, .stroke_count=2, .breath_count=0, .entry_angle=0.0f },
    { .t_ms=20415, .ax=-1.45f, .ay=-5.01f, .az=11.51f, .gx=-0.003f, .gy=0.484f, .gz=0.87f, .mx=0.0f, .my=0.0f, .mz=0.0f, .roll=0.0f, .pitch=0.0f, .yaw=0.0f, .qw=0.9915f, .qx=-0.1266f, .qy=0.0267f, .qz=0.0167f, .lia_x=-0.4f, .lia_y=-2.01f, .lia_z=1.67f, .temp=0.0f, .sys_cal=0, .gyro_cal=3, .accel_cal=3, .mag_cal=3, .haptic_fired=0, .deviation_score=0.0f, .haptic_reason=0, .pull_duration_ms=0.0f, .device_id=1, .device_role=0, .stroke_count=2, .breath_count=0, .entry_angle=0.0f },
    { .t_ms=20434, .ax=-0.96f, .ay=-3.88f, .az=10.98f, .gx=0.711f, .gy=0.584f, .gz=0.47f, .mx=0.0f, .my=0.0f, .mz=0.0f, .roll=0.0f, .pitch=0.0f, .yaw=0.0f, .qw=0.9918f, .qx=-0.1172f, .qy=0.0335f, .qz=0.0202f, .lia_x=-0.02f, .lia_y=-1.16f, .lia_z=1.13f, .temp=0.0f, .sys_cal=0, .gyro_cal=3, .accel_cal=3, .mag_cal=3, .haptic_fired=0, .deviation_score=0.0f, .haptic_reason=0, .pull_duration_ms=0.0f, .device_id=1, .device_role=0, .stroke_count=2, .breath_count=0, .entry_angle=0.0f },
    { .t_ms=20452, .ax=-0.71f, .ay=-3.43f, .az=10.64f, .gx=1.593f, .gy=0.671f, .gz=0.593f, .mx=0.0f, .my=0.0f, .mz=0.0f, .roll=0.0f, .pitch=0.0f, .yaw=0.0f, .qw=0.993f, .qx=-0.1016f, .qy=0.0405f, .qz=0.0256f, .lia_x=-0.1f, .lia_y=-0.37f, .lia_z=0.87f, .temp=0.0f, .sys_cal=0, .gyro_cal=3, .accel_cal=3, .mag_cal=3, .haptic_fired=0, .deviation_score=0.0f, .haptic_reason=0, .pull_duration_ms=0.0f, .device_id=1, .device_role=0, .stroke_count=2, .breath_count=0, .entry_angle=0.0f },
    { .t_ms=20473, .ax=-0.94f, .ay=-2.33f, .az=10.52f, .gx=1.402f, .gy=0.413f, .gz=0.965f, .mx=0.0f, .my=0.0f, .mz=0.0f, .roll=0.0f, .pitch=0.0f, .yaw=0.0f, .qw=0.9941f, .qx=-0.0947f, .qy=0.0453f, .qz=0.0344f, .lia_x=-0.25f, .lia_y=-0.76f, .lia_z=1.0f, .temp=0.0f, .sys_cal=0, .gyro_cal=3, .accel_cal=3, .mag_cal=3, .haptic_fired=0, .deviation_score=0.0f, .haptic_reason=0, .pull_duration_ms=0.0f, .device_id=1, .device_role=0, .stroke_count=2, .breath_count=0, .entry_angle=0.0f },
    { .t_ms=20491, .ax=-1.2f, .ay=-2.47f, .az=10.61f, .gx=1.116f, .gy=0.329f, .gz=0.974f, .mx=0.0f, .my=0.0f, .mz=0.0f, .roll=0.0f, .pitch=0.0f, .yaw=0.0f, .qw=0.9945f, .qx=-0.0849f, .qy=0.0474f, .qz=0.0388f, .lia_x=-0.38f, .lia_y=-2.01f, .lia_z=2.33f, .temp=0.0f, .sys_cal=0, .gyro_cal=3, .accel_cal=3, .mag_cal=3, .haptic_fired=0, .deviation_score=0.0f, .haptic_reason=0, .pull_duration_ms=0.0f, .device_id=1, .device_role=0, .stroke_count=2, .breath_count=0, .entry_angle=0.0f },
    { .t_ms=20509, .ax=-1.41f, .ay=-3.56f, .az=11.96f, .gx=0.7f, .gy=0.277f, .gz=0.59f, .mx=0.0f, .my=0.0f, .mz=0.0f, .roll=0.0f, .pitch=0.0f, .yaw=0.0f, .qw=0.9946f, .qx=-0.0784f, .qy=0.0508f, .qz=0.0468f, .lia_x=0.39f, .lia_y=-1.98f, .lia_z=2.23f, .temp=0.0f, .sys_cal=0, .gyro_cal=3, .accel_cal=3, .mag_cal=3, .haptic_fired=0, .deviation_score=0.0f, .haptic_reason=0, .pull_duration_ms=0.0f, .device_id=1, .device_role=0, .stroke_count=2, .breath_count=0, .entry_angle=0.0f },
    { .t_ms=20530, .ax=-0.7f, .ay=-3.41f, .az=11.87f, .gx=0.579f, .gy=0.31f, .gz=0.42f, .mx=0.0f, .my=0.0f, .mz=0.0f, .roll=0.0f, .pitch=0.0f, .yaw=0.0f, .qw=0.9948f, .qx=-0.0726f, .qy=0.0543f, .qz=0.0479f, .lia_x=0.58f, .lia_y=-1.11f, .lia_z=1.33f, .temp=0.0f, .sys_cal=0, .gyro_cal=3, .accel_cal=3, .mag_cal=3, .haptic_fired=0, .deviation_score=0.0f, .haptic_reason=0, .pull_duration_ms=0.0f, .device_id=1, .device_role=0, .stroke_count=2, .breath_count=0, .entry_angle=0.0f },
    { .t_ms=20548, .ax=-0.73f, .ay=-2.19f, .az=10.98f, .gx=0.698f, .gy=0.274f, .gz=0.164f, .mx=0.0f, .my=0.0f, .mz=0.0f, .roll=0.0f, .pitch=0.0f, .yaw=0.0f, .qw=0.995f, .qx=-0.0658f, .qy=0.0572f, .qz=0.0485f, .lia_x=0.07f, .lia_y=-0.89f, .lia_z=1.06f, .temp=0.0f, .sys_cal=0, .gyro_cal=3, .accel_cal=3, .mag_cal=3, .haptic_fired=0, .deviation_score=0.0f, .haptic_reason=0, .pull_duration_ms=0.0f, .device_id=1, .device_role=0, .stroke_count=2, .breath_count=0, .entry_angle=0.0f },
    { .t_ms=20567, .ax=-1.05f, .ay=-1.81f, .az=10.73f, .gx=0.698f, .gy=0.025f, .gz=0.048f, .mx=0.0f, .my=0.0f, .mz=0.0f, .roll=0.0f, .pitch=0.0f, .yaw=0.0f, .qw=0.9954f, .qx=-0.0593f, .qy=0.0566f, .qz=0.0489f, .lia_x=-0.2f, .lia_y=-0.8f, .lia_z=0.98f, .temp=0.0f, .sys_cal=0, .gyro_cal=3, .accel_cal=3, .mag_cal=3, .haptic_fired=0, .deviation_score=0.0f, .haptic_reason=0, .pull_duration_ms=0.0f, .device_id=1, .device_role=0, .stroke_count=2, .breath_count=0, .entry_angle=0.0f },
    { .t_ms=20587, .ax=-1.47f, .ay=-2.16f, .az=10.89f, .gx=0.605f, .gy=-0.313f, .gz=0.141f, .mx=0.0f, .my=0.0f, .mz=0.0f, .roll=0.0f, .pitch=0.0f, .yaw=0.0f, .qw=0.9958f, .qx=-0.0529f, .qy=0.0543f, .qz=0.0499f, .lia_x=-0.16f, .lia_y=-1.6f, .lia_z=1.9f, .temp=0.0f, .sys_cal=0, .gyro_cal=3, .accel_cal=3, .mag_cal=3, .haptic_fired=0, .deviation_score=0.0f, .haptic_reason=0, .pull_duration_ms=0.0f, .device_id=1, .device_role=0, .stroke_count=2, .breath_count=0, .entry_angle=0.0f },
    { .t_ms=20604, .ax=-1.27f, .ay=-2.88f, .az=11.9f, .gx=0.737f, .gy=-0.035f, .gz=0.137f, .mx=0.0f, .my=0.0f, .mz=0.0f, .roll=0.0f, .pitch=0.0f, .yaw=0.0f, .qw=0.9961f, .qx=-0.0459f, .qy=0.0557f, .qz=0.0511f, .lia_x=0.43f, .lia_y=-1.78f, .lia_z=2.12f, .temp=0.0f, .sys_cal=0, .gyro_cal=3, .accel_cal=3, .mag_cal=3, .haptic_fired=0, .deviation_score=0.0f, .haptic_reason=0, .pull_duration_ms=0.0f, .device_id=1, .device_role=0, .stroke_count=2, .breath_count=0, .entry_angle=0.0f },
    { .t_ms=20625, .ax=-0.54f, .ay=-2.13f, .az=11.58f, .gx=0.599f, .gy=0.467f, .gz=0.259f, .mx=0.0f, .my=0.0f, .mz=0.0f, .roll=0.0f, .pitch=0.0f, .yaw=0.0f, .qw=0.9959f, .qx=-0.0408f, .qy=0.0611f, .qz=0.053f, .lia_x=0.81f, .lia_y=-0.98f, .lia_z=1.5f, .temp=0.0f, .sys_cal=0, .gyro_cal=3, .accel_cal=3, .mag_cal=3, .haptic_fired=0, .deviation_score=0.0f, .haptic_reason=0, .pull_duration_ms=0.0f, .device_id=1, .device_role=0, .stroke_count=2, .breath_count=0, .entry_angle=0.0f },
    { .t_ms=20642, .ax=-0.41f, .ay=-1.72f, .az=11.21f, .gx=0.477f, .gy=0.577f, .gz=0.151f, .mx=0.0f, .my=0.0f, .mz=0.0f, .roll=0.0f, .pitch=0.0f, .yaw=0.0f, .qw=0.9957f, .qx=-0.0391f, .qy=0.064f, .qz=0.0536f, .lia_x=0.58f, .lia_y=-0.58f, .lia_z=0.65f, .temp=0.0f, .sys_cal=0, .gyro_cal=3, .accel_cal=3, .mag_cal=3, .haptic_fired=0, .deviation_score=0.0f, .haptic_reason=0, .pull_duration_ms=0.0f, .device_id=1, .device_role=0, .stroke_count=2, .breath_count=0, .entry_angle=0.0f },
    { .t_ms=20660, .ax=-0.75f, .ay=-1.25f, .az=10.34f, .gx=0.284f, .gy=0.435f, .gz=-0.022f, .mx=0.0f, .my=0.0f, .mz=0.0f, .roll=0.0f, .pitch=0.0f, .yaw=0.0f, .qw=0.9955f, .qx=-0.0367f, .qy=0.0705f, .qz=0.0528f, .lia_x=-0.09f, .lia_y=-1.16f, .lia_z=1.63f, .temp=0.0f, .sys_cal=0, .gyro_cal=3, .accel_cal=3, .mag_cal=3, .haptic_fired=0, .deviation_score=0.0f, .haptic_reason=0, .pull_duration_ms=0.0f, .device_id=1, .device_role=0, .stroke_count=2, .breath_count=0, .entry_angle=0.0f },
    { .t_ms=20681, .ax=-1.5f, .ay=-1.77f, .az=11.31f, .gx=0.313f, .gy=0.349f, .gz=-0.077f, .mx=0.0f, .my=0.0f, .mz=0.0f, .roll=0.0f, .pitch=0.0f, .yaw=0.0f, .qw=0.9954f, .qx=-0.0339f, .qy=0.0723f, .qz=0.0522f, .lia_x=-0.16f, .lia_y=-1.76f, .lia_z=2.37f, .temp=0.0f, .sys_cal=0, .gyro_cal=3, .accel_cal=3, .mag_cal=3, .haptic_fired=0, .deviation_score=0.0f, .haptic_reason=0, .pull_duration_ms=0.0f, .device_id=1, .device_role=0, .stroke_count=2, .breath_count=0, .entry_angle=0.0f },
    { .t_ms=20698, .ax=-1.55f, .ay=-2.33f, .az=12.05f, .gx=0.238f, .gy=0.464f, .gz=-0.002f, .mx=0.0f, .my=0.0f, .mz=0.0f, .roll=0.0f, .pitch=0.0f, .yaw=0.0f, .qw=0.9951f, .qx=-0.0328f, .qy=0.0773f, .qz=0.0526f, .lia_x=0.2f, .lia_y=-1.78f, .lia_z=2.53f, .temp=0.0f, .sys_cal=0, .gyro_cal=3, .accel_cal=3, .mag_cal=3, .haptic_fired=0, .deviation_score=0.0f, .haptic_reason=0, .pull_duration_ms=0.0f, .device_id=1, .device_role=0, .stroke_count=2, .breath_count=0, .entry_angle=0.0f },
    { .t_ms=20718, .ax=-1.03f, .ay=-1.88f, .az=12.19f, .gx=-0.197f, .gy=0.562f, .gz=0.228f, .mx=0.0f, .my=0.0f, .mz=0.0f, .roll=0.0f, .pitch=0.0f, .yaw=0.0f, .qw=0.9944f, .qx=-0.0355f, .qy=0.0822f, .qz=0.0549f, .lia_x=0.54f, .lia_y=-1.07f, .lia_z=2.42f, .temp=0.0f, .sys_cal=0, .gyro_cal=3, .accel_cal=3, .mag_cal=3, .haptic_fired=0, .deviation_score=0.0f, .haptic_reason=0, .pull_duration_ms=0.0f, .device_id=1, .device_role=0, .stroke_count=2, .breath_count=0, .entry_angle=0.0f },
    { .t_ms=20738, .ax=-1.16f, .ay=-1.54f, .az=11.91f, .gx=-0.421f, .gy=0.299f, .gz=0.11f, .mx=0.0f, .my=0.0f, .mz=0.0f, .roll=0.0f, .pitch=0.0f, .yaw=0.0f, .qw=0.9941f, .qx=-0.0392f, .qy=0.0839f, .qz=0.0554f, .lia_x=0.46f, .lia_y=-0.84f, .lia_z=2.33f, .temp=0.0f, .sys_cal=0, .gyro_cal=3, .accel_cal=3, .mag_cal=3, .haptic_fired=0, .deviation_score=0.0f, .haptic_reason=0, .pull_duration_ms=0.0f, .device_id=1, .device_role=0, .stroke_count=2, .breath_count=0, .entry_angle=0.0f },
    { .t_ms=20755, .ax=-1.53f, .ay=-1.53f, .az=11.44f, .gx=-0.105f, .gy=-0.015f, .gz=-0.213f, .mx=0.0f, .my=0.0f, .mz=0.0f, .roll=0.0f, .pitch=0.0f, .yaw=0.0f, .qw=0.9943f, .qx=-0.0391f, .qy=0.0834f, .qz=0.0528f, .lia_x=-0.02f, .lia_y=-0.79f, .lia_z=1.47f, .temp=0.0f, .sys_cal=0, .gyro_cal=3, .accel_cal=3, .mag_cal=3, .haptic_fired=0, .deviation_score=0.0f, .haptic_reason=0, .pull_duration_ms=0.0f, .device_id=1, .device_role=0, .stroke_count=2, .breath_count=0, .entry_angle=0.0f },
    { .t_ms=20776, .ax=-1.81f, .ay=-1.45f, .az=10.5f, .gx=0.439f, .gy=-0.179f, .gz=-0.338f, .mx=0.0f, .my=0.0f, .mz=0.0f, .roll=0.0f, .pitch=0.0f, .yaw=0.0f, .qw=0.9949f, .qx=-0.0339f, .qy=0.0812f, .qz=0.0494f, .lia_x=0.24f, .lia_y=-0.71f, .lia_z=0.77f, .temp=0.0f, .sys_cal=0, .gyro_cal=3, .accel_cal=3, .mag_cal=3, .haptic_fired=0, .deviation_score=0.0f, .haptic_reason=0, .pull_duration_ms=0.0f, .device_id=1, .device_role=0, .stroke_count=2, .breath_count=0, .entry_angle=0.0f },
    { .t_ms=20794, .ax=-1.36f, .ay=-1.29f, .az=10.42f, .gx=0.897f, .gy=-0.423f, .gz=-0.224f, .mx=0.0f, .my=0.0f, .mz=0.0f, .roll=0.0f, .pitch=0.0f, .yaw=0.0f, .qw=0.9956f, .qx=-0.0251f, .qy=0.0771f, .qz=0.0471f, .lia_x=0.53f, .lia_y=-0.42f, .lia_z=1.06f, .temp=0.0f, .sys_cal=0, .gyro_cal=3, .accel_cal=3, .mag_cal=3, .haptic_fired=0, .deviation_score=0.0f, .haptic_reason=0, .pull_duration_ms=0.0f, .device_id=1, .device_role=0, .stroke_count=2, .breath_count=0, .entry_angle=0.0f },
    { .t_ms=20819, .ax=-1.02f, .ay=-0.6f, .az=10.75f, .gx=0.722f, .gy=-0.526f, .gz=-0.092f, .mx=0.0f, .my=0.0f, .mz=0.0f, .roll=0.0f, .pitch=0.0f, .yaw=0.0f, .qw=0.9962f, .qx=-0.019f, .qy=0.0723f, .qz=0.0454f, .lia_x=0.35f, .lia_y=-0.19f, .lia_z=0.5f, .temp=0.0f, .sys_cal=0, .gyro_cal=3, .accel_cal=3, .mag_cal=3, .haptic_fired=0, .deviation_score=0.0f, .haptic_reason=0, .pull_duration_ms=0.0f, .device_id=1, .device_role=0, .stroke_count=2, .breath_count=0, .entry_angle=0.0f },
    { .t_ms=20838, .ax=-1.09f, .ay=-0.59f, .az=9.96f, .gx=0.338f, .gy=-0.551f, .gz=-0.355f, .mx=0.0f, .my=0.0f, .mz=0.0f, .roll=0.0f, .pitch=0.0f, .yaw=0.0f, .qw=0.9968f, .qx=-0.0163f, .qy=0.0667f, .qz=0.0411f, .lia_x=0.0f, .lia_y=-0.51f, .lia_z=0.02f, .temp=0.0f, .sys_cal=0, .gyro_cal=3, .accel_cal=3, .mag_cal=3, .haptic_fired=0, .deviation_score=0.0f, .haptic_reason=0, .pull_duration_ms=601.0f, .device_id=1, .device_role=0, .stroke_count=2, .breath_count=0, .entry_angle=0.0f },
    { .t_ms=20856, .ax=-1.56f, .ay=-0.9f, .az=9.58f, .gx=0.187f, .gy=-0.713f, .gz=-0.59f, .mx=0.0f, .my=0.0f, .mz=0.0f, .roll=0.0f, .pitch=0.0f, .yaw=0.0f, .qw=0.9975f, .qx=-0.0146f, .qy=0.0594f, .qz=0.0354f, .lia_x=-0.07f, .lia_y=-0.84f, .lia_z=0.91f, .temp=0.0f, .sys_cal=0, .gyro_cal=3, .accel_cal=3, .mag_cal=3, .haptic_fired=0, .deviation_score=0.0f, .haptic_reason=0, .pull_duration_ms=0.0f, .device_id=1, .device_role=0, .stroke_count=2, .breath_count=0, .entry_angle=0.0f },
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
