chaudhary-nikhil/E22_Senior_Design/(commit log)

2025-10-01 ESP32 Wroom boilerplate
2025-10-04 added a bunch of template components, cleaned up getting IMU code
2025-10-06 Modular ESP32 Code Template (#2)
    * ESP32 Wroom boilerplate
    * Update sdkconfig.defaults
    * Update README.md
    * added a bunch of template components, cleaned up getting IMU code
    * cleanup
    ---------
2025-10-06 Add IMU real-time 3D visualization system
    - ESP32 firmware reads MPU6050 IMU data at 100Hz
    - Serial streaming component sends JSON data via USB
    - Python web server processes IMU data for 3D visualization
    - Web interface displays real-time 3D cube using Three.js
    - Server-Sent Events for live data streaming
    - Removed unused components (BLE, fusion, logging, storage)
    - Simplified codebase for direct IMU visualization
2025-10-06 Clean up codebase - remove unused components and files
    - Remove unused live_imu_visualizer.py and live_imu_3d.html
    - Remove websocket_simple component completely
    - Clean up main CMakeLists.txt comments
    - Keep only essential components: bus_i2c, imu_mpu6050, serial_stream
    - Keep only working visualization: simple_imu_visualizer.py and simple_imu_3d.html
    - System builds successfully and Python visualizer works
    - Minimal, clean codebase for IMU real-time 3D visualization
2025-10-17 added new functionality for visual charts (#5)
    * added new functionality for visual charts of the acceleration and angular velocity
    * adding codeowners file
2025-10-19 Copy main branch from embedded-purdue/BB8 to bno055-aakash
    This commit copies the complete main branch from embedded-purdue/BB8 repository
    to create a new branch bno055-aakash in E22_Senior_Design repository.
    Source: https://github.com/embedded-purdue/BB8/tree/main
    Destination: https://github.com/chaudhary-nikhil/E22_Senior_Design/tree/bno055-aakash
    Components copied:
    - components/ (bus_i2c, imu_bno055, imu_mpu6050, serial_stream)
    - main/ (app_main.c and CMakeLists.txt)
    - scripts/ (Python visualization scripts)
    - Configuration files (CMakeLists.txt, sdkconfig.defaults, etc.)
2025-10-21 Fix ESP32 connection messages and add missing endpoints
    - Remove excessive 'Connected to ESP32' messages (only show once)
    - Add visualizer.js endpoint handler to fix 404 error
    - Add missing /session_status endpoint
    - Improve error handling for serial reconnections
    [app_main.c, bno055.c, bus_i2c.c, session_logger.py, simple_imu_visualizer.py]
2025-10-21 Add sessions directory and dynamic orientation analysis
    - Create dashboard/sessions/ directory for organized JSON storage
    - Update all file paths to use sessions/ directory
    - Add dynamic orientation analysis based on acceleration data
    - Fix emergency save logic to only save when actively logging
    - Update README with sessions directory documentation
    [session_logger.py]
2025-10-21 Fix critical issues identified by Copilot AI
    - Fix undefined data_lock variable in session_logger.py
    - Fix BNO055 accelerometer unit conversion (mg/LSB to m/s²)
    - Fix BNO055 gyroscope unit conversion (dps to rad/s)
    - Use CONFIG_FORMSYNC_SAMPLE_HZ instead of hardcoded sampling period
    - Improve playback timing accuracy with session_time-based delays
    All fixes ensure proper sensor data accuracy and system reliability.
    [app_main.c, bno055.c, session_logger.py]
2025-10-21 Fix shutdown errors and improve cleanup
    - Add safe serial port cleanup with error handling
    - Fix data_lock scope issue in main shutdown handler
    - Add graceful error handling for emergency save
    - Prevent multiple serial port close attempts
    - Add confirmation message for clean shutdown
    Resolves: Bad file descriptor errors and NameError on shutdown
    [session_logger.py]
2025-10-21 Fix timing and session management issues identified by Copilot
    - Use monotonic time for session timestamps (prevents NTP/clock drift issues)
    - Fix BNO055 session start time to reset between sessions
    - Replace hardcoded playback delay bounds with dynamic calculation
    - Calculate bounds based on actual sample rate characteristics
    - Ensure accurate timing regardless of system clock changes
    All timing issues resolved for reliable session logging and playback.
    [bno055.c, bno055.h, session_logger.py]
2025-10-21 Fix static variable declaration order in BNO055 driver
    - Move session_start_time declaration to top of file (line 11)
    - Remove duplicate declaration at bottom of file
    - Fixes compilation error: variable used before declaration
    - Ensures proper C compilation order
    Resolves Copilot compilation warning.
    [bno055.c]
2026-01-19 Atharva integral try (#17)
    * added Lia read
    * imu visualizer with calibration, added some integration logic too, issues with html
    * working visuals
    * Configure ESP-IDF for VS Code and make paths portable
    - Add VS Code settings for ESP-IDF extension
    - Update CMakeLists.txt to use portable paths (HOME instead of hardcoded)
    - Configure ESP-IDF path detection for workspace and common locations
    * comment for psedu logic
    * Improve IMU visualizer for swimming stroke tracking
    - Add Kalman filtering for smoother acceleration data
    - Implement smart friction to prevent drift when stationary
    - Add stroke trail visualization with colored paths
    - Fix position direction mappings (all axes now correc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
    [app_main.c, bno055.c, bno055.h, simple_imu_visualizer.py]
2026-01-21 Nikhil/feature/sd card integration (#18)
    - Fix position direction mappings (all a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
    [app_main.c, simple_imu_visualizer.py, storage.c, storage.h]
2026-01-21 Refactor: move just_reset flag initialization and remove unused reset signaling
    [simple_imu_visualizer.py]
2026-01-23 PCB stuff - not fully done
    [GoldenForm_1.kicad_pcb, GoldenForm_1.kicad_sch]
2026-01-28 changing the SD reader to Adafruit MicroSD SPI (#21)
    * changing the SD reader to Adafruit MicroSD SPI
    * new SD logic
    * cleanup again
    * revert sdkconfig
    * Update sdkconfig
    Update components/bus_i2c/bus_i2c.c
    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
    [app_main.c, storage.c]
2026-01-31 send saved data in sd card through wifi from the esp32 to the server (#20)
    * Add ESP32-S3 support with WiFi server integration
    - Updated firmware for ESP32-S3-WROOM-1 based on schematic
    - Integrated WiFi server component from atharva_wifi_check branch
    - Implemented 4-state machine (IDLE, LOGGING, STOPPED, SYNCING) controlled by BOOT button
    - Added binary protobuf-like storage format for SD card
    - Configured I2C pins for BNO055 (SDA=GPIO4, SCL=GPIO5, ADDR=GPIO6)
    - Configured SPI pins for SD card (MOSI=47, MISO=14, SCK=21, CS=48, DETECT=11)
    - Added checksum verification for data integrity during WiFi sync
    - Fixed format specifiers for uint32_t in WiFi server
    - Using onboard LED (GPIO2) tempor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
    [GoldenForm_1.kicad_pcb, GoldenForm_1.kicad_sch]
2026-01-31 Rename project to GoldenForm
    Updated project name and clarified focus on IMU sensors.
2026-02-02 added m3 mounting holes
    [GoldenForm_1.kicad_pcb]
2026-02-02 added mounting holes to sch
    [GoldenForm_1.kicad_sch]
2026-02-04 added LED logic (#23)
2026-02-04 Fixing ERC Check Errors/Warnings (#22)
    * some new changes
    * more changes for ERC cleanup
    * added Symbols to table
    * wip
    * WIP
    * 3 ERC warnings now
    [GoldenForm_1.kicad_pcb]
2026-02-04 oops renamed to LED_2
    [GoldenForm_1.kicad_sch]
2026-02-05 some updates to footprints, USBC, buck boost, switch
    [GoldenForm_1.kicad_pcb, GoldenForm_1.kicad_sch]
2026-02-05 added new sd card socket, esd protection for boot and en, uart debug
    [GoldenForm_1.kicad_pcb, GoldenForm_1.kicad_sch]
2026-02-05 added switch, led footprints
    [GoldenForm_1.kicad_pcb, GoldenForm_1.kicad_sch]
2026-02-07 placed the components on the PCB
    [GoldenForm_1.kicad_pcb, GoldenForm_1.kicad_sch]
2026-02-07 added transistor and haptic onto board
    [GoldenForm_1.kicad_pcb, GoldenForm_1.kicad_sch]
2026-02-08 started routing. added classes and stuff
    [GoldenForm_1.kicad_pcb, GoldenForm_1.kicad_sch]
2026-02-08 need to sort DRCs
    [GoldenForm_1.kicad_pcb, GoldenForm_1.kicad_sch]
2026-02-10 Ignore esp-idf framework directory
2026-02-10 Live IMU visualizer: UART stream from ESP32, auto-detect serial port, skip Bluetooth
    [app_main.c, simple_imu_visualizer.py]
2026-02-13 commented prints out
2026-02-15 added caps for vdd sd, added esd for usbc, fixed i2c addr from bno
    [GoldenForm_1.kicad_pcb, GoldenForm_1.kicad_sch]
2026-02-17 0 DRC errors. Need to do silkscreen
    [GoldenForm_1.kicad_pcb, GoldenForm_1.kicad_sch]
2026-02-17 added silkscreen, logo, etc.
    [GoldenForm_1.kicad_pcb]
2026-02-18 Software prototyping: visualization, stroke detection, sync & docs
    - integrated_session_viewer: displacement-from-origin trails, per-stroke colors, arc scale; server doc routes
    - simple_imu_visualizer: MIN_STROKE_INTERVAL 1.1s, no double-count during stroke_integrating
    - wifi_session_processor: serve /docs/screenshot_* for slide assets
    - firmware/storage/wifi_server/imu/main: existing integration and config
2026-02-20 CDR updates
    [GoldenForm_1.kicad_pcb, GoldenForm_1.kicad_sch]
2026-02-26 added shield res, and ext button headers
    [GoldenForm_1.kicad_pcb, GoldenForm_1.kicad_sch]
2026-03-01 minor silkscreen changes
    [GoldenForm_1-B_Cu.gbl, GoldenForm_1-B_Mask.gbs, GoldenForm_1-B_Paste.gbp, GoldenForm_1-B_Silkscreen.gbo, GoldenForm_1-Edge_Cuts.gm1, GoldenForm_1-F_Cu.gtl, GoldenForm_1-F_Mask.gts, GoldenForm_1-F_Paste.gtp]
2026-03-05 final PCB
    [GoldenForm_1.kicad_pcb, GoldenForm_1.kicad_sch]
2026-03-11 Fix up BTstack to root components, apply haptic & stability fixes, and enable IDF 6.0 compatibility
    [app_main.c, bno055.c, database.py, haptic.c, haptic.h, simple_imu_visualizer.py]
2026-04-02 Align LIA position integration with legacy UART tuning (0401fbde)
    When accel and gyro fusion are both >= 2, use the same deadzone (0.2 m/s²)
    and velocity decay (0.98 / 0.80) as the pre-WiFi live serial path, plus a
    slightly longer pull-through window (0.72s). Keeps impact-based stroke
    reset and world-frame R*Kalman LIA integration; exposes position_integration
    in processed JSON for debugging.
    Made-with: Cursor
    [simple_imu_visualizer.py]
2026-04-02 Viz: LIA-first 3D defaults, drift-tuned integration, cleaner scene
    StrokeProcessor: vector deadzone when accel+gyro fusion >=2; quiet-sample
    velocity bleed; comments clarify Wi‑Fi uses same world LIA physics as legacy.
    App: default path mode position; smaller hand scale; softer water/fog/trail;
    ghost ideal as subtle solid (off by default); swimmer silhouette off by default;
    checkboxes for ideal overlay and swimmer ref; ideal overlay respects checkbox.
    Firmware: document IMU sample path parity with dashboard integration.
    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
    [app_main.c, simple_imu_visualizer.py]
2026-04-09 Update .gitignore to exclude environment files; modify sdkconfig for device ID and enable multi-device support; enhance bno055.c with new operation mode handling and calibration logging; update dashb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
2026-04-09 added replay button
2026-04-09 reverted to older stroke processor
    [simple_imu_visualizer.py]
2026-04-09 Enhance stroke detection and dashboard features: Adjust haptic thresholds and warmup logic in stroke detector; update dashboard styles for improved user experience; add haptic feedback metrics to ses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
2026-04-13 fixed statvfs issues (#27)
    [storage.c]
2026-04-14 Update sdkconfig for device ID and role; enhance error logging in app_main for SD card and IMU read errors; add IDF setup path in VSCode settings.
    [app_main.c]
2026-04-17 IMU viz + StrokeProcessor: 0401fbde alignment, UX, firmware polish
    - StrokeProcessor: motion-gate segment resets (live+batch), quiet streak to
    reduce gate flutter; cal-fail and /reset clear gate state; land-demo stroke
    detection tightened; batch replay notes for GF_REPLAY_INTEGRATION.
    - Dashboard: per-stroke origin (catch/pull), prefer stroke_count over fw strokes;
    side-view PCA sign fix; lockable side camera + shared sagittal transform;
    auto-scale stroke + camera frame; tracking HUD; default position scale.
    - 3D: watch-style strap geometry, quaternion session baseline.
    - Firmware: button GPIO Kconfig, deferred BOOT sync; sdkconfig defaults.
    Does not merge main; intended for review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
    [app_main.c, simple_imu_visualizer.py, wifi_session_processor.py]
2026-04-17 Update GPIO configurations in sdkconfig and app_main; modify VSCode settings for serial port and monitor. Adjust LED GPIO definitions for improved functionality.
2026-04-21 Nikhil/rrt (#30)
    * rrt
    * tweaked some things, looks better now
    * push
    * push
    * Update GPIO configuration for goldenform button and remove turn count from IMU and protobuf structures. Adjust stroke detection logic to eliminate turn detection and enhance haptic feedback settings based on skill level. Update dashboard to reflect changes in data handling and visualization, including removal of legacy pool length metrics.
    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
2026-04-21 added dummy flow in main
2026-04-21 visualizer fix should be patched now
    [app_main.c, wifi_session_processor.py]
2026-04-21 Add TIDR Architecture Guide and Verification Report
    - Introduced a comprehensive TIDR Architecture Guide detailing the 19 Trade-Off Informed Design Requirements (TIDRs) and their interconnections across hardware, firmware, and web app components.
    - Documented key data flows, trade-offs, and architectural constraints imposed by TIDRs.
    - Added a TIDR Verification Report confirming the implementation of all TIDRs, including a quick lookup for TIDR references and critical path analysis.
    - Verified code mappings and provided insights into the design decisions and their implications on system performance and user experience.
